pratham-cloud-ctrl/INDRBT/02_Simulation_and_Animation/README.md

# Simulation · Motion, workspace and feedback

[← Project home](../README.md) · [Mechanical tour](../06_Complete_Project_Source/docs/cad_tour.md) · [Theory walkthrough](../06_Complete_Project_Source/docs/engineering_walkthrough.md)

Recorded FK pick-and-place task

## Move and inspect the actual CAD

**[Launch the public robot viewer](https://pratham-cloud-ctrl.github.io/INDRBT/#robot)** for joint controls, gripper motion, component isolation and playback without downloading files.

**Optional offline use:** download and extract the project, then open **OPEN_3D_VIEWER.cmd** in the parent folder on Windows. On any system, open [Interactive_3D_Viewer.html](Interactive_3D_Viewer.html) locally in a browser. This local copy needs no server or internet; GitHub displays its HTML source rather than executing it.

Drag to orbit, scroll to zoom, select a named pose, adjust six joints and the gripper, or play the recorded task. The **CAD component** selector isolates and frames each of the 54 parts.

For optional native CAD/PCB or offline inspection, use the [public engineering download release](https://github.com/pratham-cloud-ctrl/INDRBT/releases/tag/indrbt-2026-10-28) and [opening guide](../06_Complete_Project_Source/docs/cad_downloads.md). The release includes a combined offline viewer/CAD pack. The published GitHub Pages showcase includes the browser viewers and download controls.

## Understand the recorded task

| Inspect | Evidence |
|---|---|
| Tool path through the task | [Pick/place TCP plot](Trajectories/pick_place_tcp.png) |
| Joint angles, speeds and accelerations | [Pick/place joint plots](Trajectories/pick_place_joints.png) |
| Reproduce the samples | [Task CSV](Trajectories/pick_place.csv) · [Task metrics](Trajectories/pick_place_metrics.json) |
| Compare joint interpolation and Cartesian moves | [Interpolation curves](Trajectories/interpolation_comparison.png) · [MOVE J](Trajectories/move_j_tcp.png) · [MOVE L](Trajectories/move_l_tcp.png) |

## Workspace and feedback

| Topic | Plot | Explanation |
|---|---|---|
| Reachable samples | [3D workspace](Workspace/workspace_3d.png) · [Projections](Workspace/workspace_projections.png) | 6,000 seeded joint configurations; the convex hull is an envelope, not collision-free reachable volume |
| Frames and singularities | [Coordinate frames](Workspace/coordinate_frames.png) · [Singularity analysis](Workspace/singularity_analysis.png) | [Kinematic formulation](../06_Complete_Project_Source/docs/02_kinematics.md) |
| Simplified PID | [Tracking](Control/pid_tracking.png) · [Step response](Control/pid_step_response.png) · [Metrics](Control/metrics.json) | [Theory guide](../06_Complete_Project_Source/docs/theory_guide.md) |

The grasp is an ideal attachment and controller plants use independent assumed inertias/damping. Manual joint settings can collide. [Sampled CAD clearance evidence](../03_Reports_and_Results/Validation/cad_motion_clearance.json) is separate from viewer playback.
