pratham-cloud-ctrl/INDRBT/07_Releases/README.md

# INDRBT release bundles

Download the complete INDRBT project, installable Python package, standard CAD,
FreeCAD and KiCad inspection packs from the [current public release](https://github.com/pratham-cloud-ctrl/INDRBT/releases/tag/indrbt-2026-10-28).

The engineering design revision remains 1.2.0. The October 2026 identity update
renames the project and refreshes its native labels, viewers, documentation and
source-bound verification. Historical distributions and audit records are
preserved separately; current downloads use INDRBT consistently.
