pratham-cloud-ctrl/INDRBT/06_Complete_Project_Source/docs/cad_downloads.md

# Open the engineering files

[Inspect the robot online](https://pratham-cloud-ctrl.github.io/INDRBT/#robot) · [Inspect the PCB online](https://pratham-cloud-ctrl.github.io/INDRBT/#pcb) · [Documentation index](README.md)

The [public browser showcase](https://pratham-cloud-ctrl.github.io/INDRBT/#robot) is the quickest viewing route. For optional CAD/electronics application inspection or offline browsing, use the [public GitHub inspection release](https://github.com/pratham-cloud-ctrl/INDRBT/releases/tag/indrbt-2026-10-28) and the actual engineering files below. The repository and its release assets are public; no private repository access is needed.

**Hosting status — 28 October 2026:** the browser showcase and its download controls are published through GitHub Pages at the address above. Public downloads are also distributed through the GitHub inspection release below. The original Sites management record remains inaccessible; publication on GitHub Pages does not claim to repair that server record.

## Choose a model format

| What you want | Actual file or folder | Open it with |
|---|---|---|
| Complete solid assembly | [Home STEP](../cad/exports/STEP/assembly_home.step) | FreeCAD or another CAD application supporting STEP |
| Another complete configuration | [Six STEP assemblies](../cad/exports/STEP) — files named `assembly_home`, `assembly_extended`, `assembly_folded`, `assembly_vertical`, `assembly_pick` and `assembly_place` | CAD application, **File → Open** or **File → Import** |
| One component | [Individual STEP files](../../01_CAD_Models/STEP/Individual_Parts) | CAD application, **File → Open** or **File → Import** |
| Native FreeCAD inspection assembly | [indrbt_home.FCStd](../cad/freecad/indrbt_home.FCStd) | FreeCAD, **File → Open** |
| Triangle meshes | [STL exports](../cad/exports/STL) | Mesh viewer or a CAD application supporting STL |
| Dimensioned interfaces | [Engineering drawings PDF](drawings/engineering_interfaces.pdf) | Any PDF viewer |

**STEP is standard solid-geometry exchange without construction history.** Its geometry can be inspected or modified using the receiving application's tools; it does not include the original parametric feature sequence. The native FreeCAD file contains 54 named, saved solids and inspection metadata, rather than a sketch-based construction tree.

The reproducible parametric design lives in [Build123d geometry](../cad/build123d/geometry.py), [assembly transforms](../cad/build123d/assembly.py) and the [shared SI configuration](../config/robot.yaml). Read [CAD reproduction](04_cad.md#refresh-native-cad-evidence) before changing the design or regenerating its exports.

### Open or import safely

1. Save or extract the chosen file to a normal folder. On GitHub, use the file page's **Download raw file** control when available; do not copy its displayed text into another application.
2. Start FreeCAD or your CAD application, then choose **File → Open** for a new document, or **File → Import** when deliberately adding geometry to an existing document. Select the `.step` or `.FCStd` file using the file-type filter.
3. Use **Fit all** if the model is outside the current view. Open an `assembly_*.step` file to see positioned parts together.
4. Save intentional edits as a **new filename**. Generated files are refreshed by the project scripts; an older open document should not overwrite a newer generated file.

CAD exports use **millimetres**; numerical calculations use **metres**. Individual parts retain local group frames, so opening all part files at a common origin does not assemble the robot. Use a complete assembly or the native FreeCAD home model for that purpose.

## Open the KiCad project

| Native item | Actual file or folder |
|---|---|
| Project entry point | [joint_interface.kicad_pro](../electronics/joint_interface.kicad_pro) |
| Schematic | [joint_interface.kicad_sch](../electronics/joint_interface.kicad_sch) |
| Routed PCB | [joint_interface.kicad_pcb](../electronics/joint_interface.kicad_pcb) |
| Project-local footprint resolution | [fp-lib-table](../electronics/fp-lib-table) and [INDRBT_Interface.pretty](../electronics/INDRBT_Interface.pretty) |
| Symbol resolution and rules | [sym-lib-table](../electronics/sym-lib-table) and [joint_interface.kicad_dru](../electronics/joint_interface.kicad_dru) |
| Readable circuit and layers | [Schematic PDF](../electronics/exports/joint_interface.pdf) and [PCB layer PDF](../electronics/exports/pcb_layers.pdf) |

With **KiCad 10** and its standard libraries installed, keep the project, schematic, PCB, rule files, library tables and local footprint folder together. Open the `.kicad_pro` file in KiCad, then open the schematic or PCB editor. Open the `.kicad_sch` or `.kicad_pcb` directly only when their surrounding project context is retained. The custom F1 footprint resolves through `${KIPRJMOD}`; downloading the board alone omits that editable library context.

For component roles, supply assumptions and verification scope, read the [circuit tour](electronics_tour.md), [component guide](electronics_components.md) and [electronics chapter](05_electronics.md). Native files and rule checks remain digital design evidence, without physical qualification.

## Public inspection download release

[Open the inspection release](https://github.com/pratham-cloud-ctrl/INDRBT/releases/tag/indrbt-2026-10-28) for the four focused format packs and the combined offline pack. These are GitHub **release assets**; they do not need to be stored in the repository file tree. Local copies are also retained in `07_Releases`.

| Public release asset | Intended use |
|---|---|
| [INDRBT_STEP_STL_CAD.zip](https://github.com/pratham-cloud-ctrl/INDRBT/releases/download/indrbt-2026-10-28/INDRBT_STEP_STL_CAD.zip) | Extract the exchange solids/meshes, then open a complete STEP assembly; STEP has no construction history |
| [INDRBT_FreeCAD_Model.zip](https://github.com/pratham-cloud-ctrl/INDRBT/releases/download/indrbt-2026-10-28/INDRBT_FreeCAD_Model.zip) | Extract and open the native saved-solid FreeCAD inspection model |
| [INDRBT_KiCad_Project.zip](https://github.com/pratham-cloud-ctrl/INDRBT/releases/download/indrbt-2026-10-28/INDRBT_KiCad_Project.zip) | Extract the project with its local library context, then open the `.kicad_pro` file |
| [INDRBT_PCB_STEP.zip](https://github.com/pratham-cloud-ctrl/INDRBT/releases/download/indrbt-2026-10-28/INDRBT_PCB_STEP.zip) | Import the native board STEP into mechanical CAD; 100 × 100 × 11.54 mm, with fitted component and copper geometry |
| [INDRBT_Inspection_With_CAD.zip](https://github.com/pratham-cloud-ctrl/INDRBT/releases/download/indrbt-2026-10-28/INDRBT_Inspection_With_CAD.zip) | Extract the browser viewers with the selected CAD and KiCad downloads for combined offline inspection |

The earlier `INDRBT_Browser_Inspection.zip` remains a local historical pack in `07_Releases`; the public combined pack is the current offline download. The engineering v1.2.0 release is preserved separately from this inspection distribution.

Downloading or opening these files is optional. The online viewers remain the immediate inspection route, and the [source project guide](../README.md) covers local reproduction.
