pratham-cloud-ctrl/INDRBT/06_Complete_Project_Source/docs/completion_checklist.md

# Digital project completion checklist

This maps the master brief's definition of done to the retained source and actual
evidence. The executed [validation report](../results/validation/validation_report.md)
records **DIGITAL SCOPE COMPLETE**: the numerical/CAD tests passed with no failures,
errors or skips, native schematic ERC/PCB DRC/connectivity passed, and the versioned
wheel passed detached installation checks. The public repository and its versioned
releases provide publication evidence, checked separately from local engineering
acceptance. The current published release is linked below.

| Deliverable | Evidence |
|---|---|
| Requirements and architecture | [Requirements](01_requirements.md), [architecture](architecture.md), diagrams |
| Student-readable theory and assumptions | [Theory guide](theory_guide.md), linked equations/models and independent [final theory review](../results/validation/final_theory_review.json) |
| Original six-axis arm, parametric CAD and assembly | `cad/build123d`, valid component manifest and six STEP/STL assemblies |
| Parallel gripper and interchangeable tool | CAD body/guides/jaws, opening checks and mechanical calculations |
| STEP/STL, useful drawings and representative renders | `cad/exports`, `docs/drawings`, `cad/renders`, independent FreeCAD inspection |
| Frames, FK, IK and Jacobian | [Kinematics](02_kinematics.md), software tests and independent numerical reconstruction |
| Workspace and singularities | Seeded FK sample data and labelled projections/3D figures |
| Joint/Cartesian trajectories and pick/place | Linear/cubic/quintic laws, MOVE J/MOVE L, recorded task data, plots and model-driven viewer |
| Joint torque, analytical structure and conceptual actuator sizing | [Mechanical analysis](03_mechanical_analysis.md), load/beam results and independent torque test |
| PID control simulation | Step/tracking/saturation/antiwindup evidence under the stated independent-axis plant |
| KiCad architecture, schematic, PCB and actual native checks | [Electronics](05_electronics.md), BOM/net contract, native ERC/DRC, routed board and fabrication files; zero DRC violations, unconnected items or schematic parity issues in the [PCB audit](../electronics/pcb_verification.json) |
| Organized reproducible software and central parameters | `src/robotarm`, authoritative SI YAML, commands and tests |
| Automated tests and numerical validation | Passing suite in the executed validation report plus Jacobian/IK/FK/configuration/trajectory/gripper/CAD checks; the [final theory review](../results/validation/final_theory_review.json) includes the independent beam-regression audit |
| Validation matrix and one workflow | [Traceability](validation_matrix.md), `scripts/run_validation.py` |
| Research experiments, plots and KPIs | Five real parameter sweeps, figure files and [KPIs](kpis.md) |
| Engineering report and decisions | [Report](engineering_report.md), [decision log](design_decisions.md), real failure/fix journal |
| Polished README and tested installation | Root/source guides, browser reports and fresh detached [versioned wheel validation](../results/validation/packaging_validation.json) |
| Clean repository, secrets scan and meaningful history | Repository audit and retained commits; repository made public by the owner's explicit instruction on 21 October 2026 |
| Complete organized publication and coherent release | Numbered repository folders and exact-copy manifest; [public repository](https://github.com/pratham-cloud-ctrl/INDRBT) and [latest versioned release](https://github.com/pratham-cloud-ctrl/INDRBT/releases/latest) with complete project ZIP and installable wheel. Live publication is checked separately from local engineering acceptance. |

Physical construction and physically measured payload/repeatability were excluded
by the master brief. The allowed analytical structure and simplified PID models
are implemented. Full FEA, coupled dynamics, contact physics, production firmware,
manufacturing qualification and continuous swept collision certification are
declared extensions, not substituted pass claims. The [scope audit](digital_scope_audit.md)
explains this boundary against the actual requested sections.
