pratham-cloud-ctrl/INDRBT/01_CAD_Models/Drawings/engineering_interfaces.pdf

# INDRBT | BASE & TOOL INTERFACES

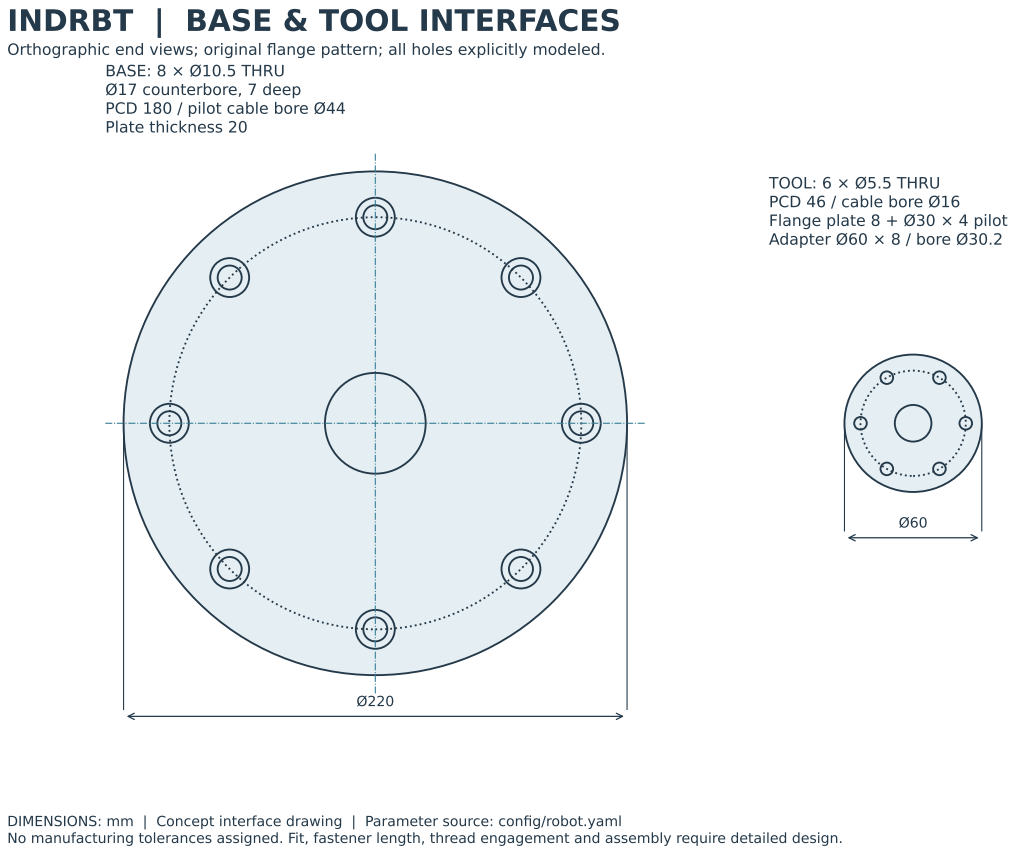
[picture p14: page 1]

Orthographic end views; original flange pattern; all holes explicitly modeled.

BASE: 8 × Ø10.5 THRU
Ø17 counterbore, 7 deep
PCD 180 / pilot cable bore Ø44
Plate thickness 20

TOOL: 6 × Ø5.5 THRU
PCD 46 / cable bore Ø16
Flange plate 8 + Ø30 × 4 pilot
Adapter Ø60 × 8 / bore Ø30.2

DIMENSIONS: mm | Concept interface drawing | Parameter source: config/robot.yaml
No manufacturing tolerances assigned. Fit, fastener length, thread engagement and assembly require detailed design.

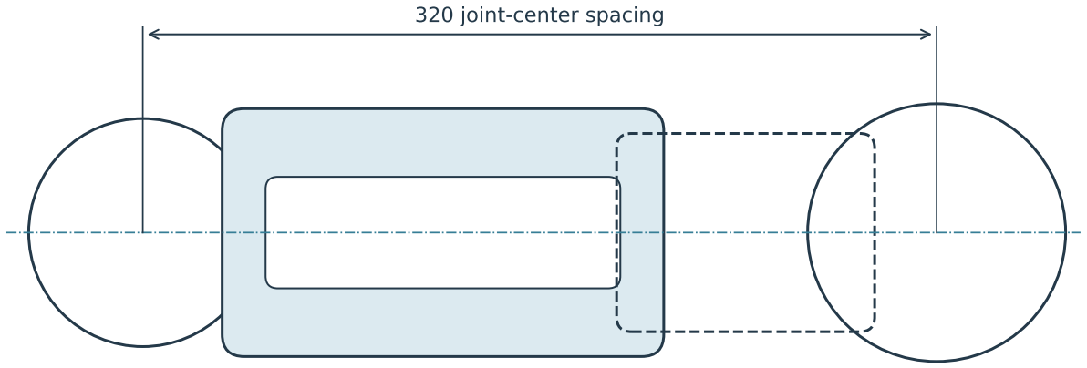
[picture p15: figure]
320 joint-center spacing

100

80

UPPER NOMINAL
80 × 100 × 4 wall

FOREARM: 280 center spacing; 65 × 80 × 4 wall.
Longitudinal fillets R9 outside / R5 inside; service cover mounting Ø3.4.

Joint barrels, fork bridges and material overlap are structural assembly interfaces.

# INDRBT | LINK SECTIONS & JOINT CENTERS

Side outline and nominal extrusion section. Access windows require a separate structural refinement.

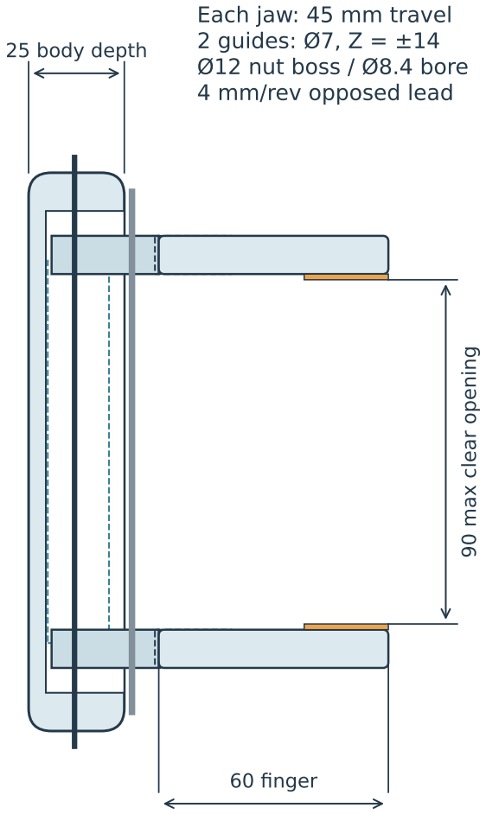
[picture p16: figure]
90 max clear opening; 60 finger; 25 body depth; Each jaw: 45 mm travel 2 guides: Ø7, Z = ±14 Ø12 nut boss / Ø8.4 bore 4 mm/rev opposed lead

Finger section 10 × 18; replaceable 1.5-thick pads. TCP at X=110, jaw mid-plane.
Ø8 screw envelope; connected nut bridges; top service hatch (dashed); no thread/preload detail.

# INDRBT | SYMMETRIC PARALLEL GRIPPER

Top view: transverse opposite-hand screw and two guides; fingers translate along ±Y.
