pratham-cloud-ctrl/INDRBT/06_Complete_Project_Source/requirements-lock.txt

anytree==2.13.0
asttokens==3.0.2
bd_materials==0.2.4
build123d==0.13.0
cadquery-ocp-novtk==8.0.1.0.0
cadquery-ocp-proxy==8.0.1.0.0
certifi==2026.7.22
charset-normalizer==3.5.2
cloudpickle==3.1.2
colorama==0.4.6
contourpy==1.4.0
cycler==0.12.1
dataclasses-json==0.6.7
Deprecated==3.0.0
executing==2.2.1
ezdxf==1.4.4
fonttools==4.66.1
idna==3.20
iniconfig==2.3.0
ipython==9.17.1
ipython_pygments_lexers==1.1.1
jedi==0.20.0
joblib==1.6.0
kiwisolver==1.5.1
lib3mf==2.5.0
Markdown==3.8.2
marshmallow==3.26.2
matplotlib==3.11.2
matplotlib-inline==0.2.2
mpmath==1.3.0
mypy_extensions==1.1.0
narwhals==2.26.0
numpy==2.5.3
ocp_gordon==0.3.1
ocpsvg==0.7.0
packaging==26.3
parso==0.8.7
pillow==12.2.0
platformdirs==4.12.3
pluggy==1.6.0
prompt_toolkit==3.0.53
psutil==7.2.2
pure_eval==0.2.4
pygltflib==1.16.5
Pygments==2.21.0
pyparsing==3.3.3
pytest==9.1.1
python-dateutil==2.9.0.post0
PyYAML==6.0.3
requests==2.34.2
ruff==0.16.10
scikit-learn==1.9.1
scipy==1.18.1
six==1.17.0
stack-data==0.6.3
svgelements==1.9.6
svgpathtools==1.8.0
svgwrite==1.4.3
sympy==1.14.0
threadpoolctl==3.7.0
threejs-materials==1.2.4
traitlets==5.16.1
trianglesolver==1.2
trimesh==5.1.1
typing-inspect==0.9.0
typing_extensions==4.16.0
urllib3==2.8.0
wcwidth==0.9.1
webcolors==24.8.0
wrapt==2.5.0
