pratham-cloud-ctrl/INDRBT/01_CAD_Models/Preview_Images/pose_extended.png

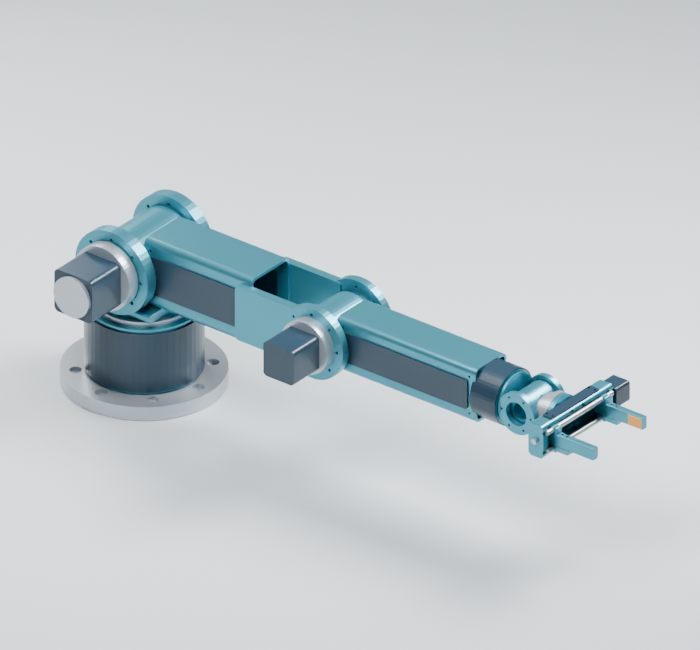
01_CAD_Models/Preview_Images/pose_extended.png
