pratham-cloud-ctrl/INDRBT/01_CAD_Models/Preview_Images/pose_home.png

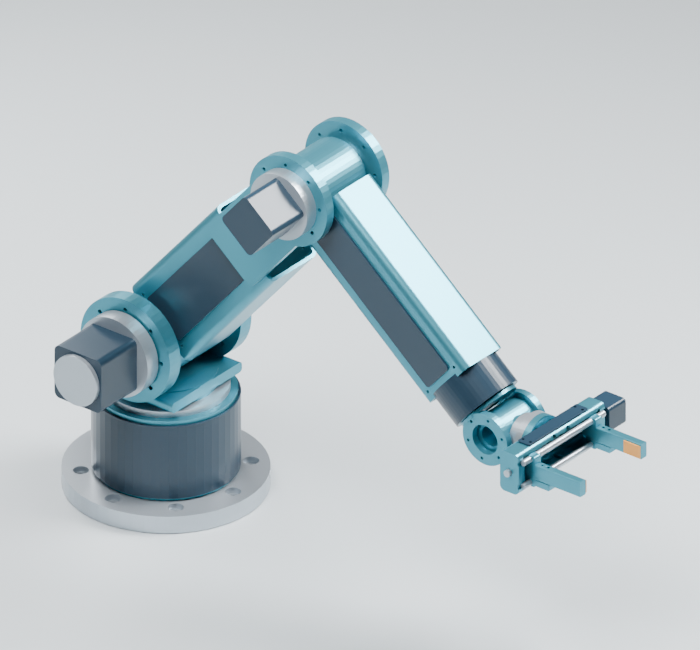
01_CAD_Models/Preview_Images/pose_home.png
