pratham-cloud-ctrl/INDRBT/01_CAD_Models/Preview_Images/pose_pick.png

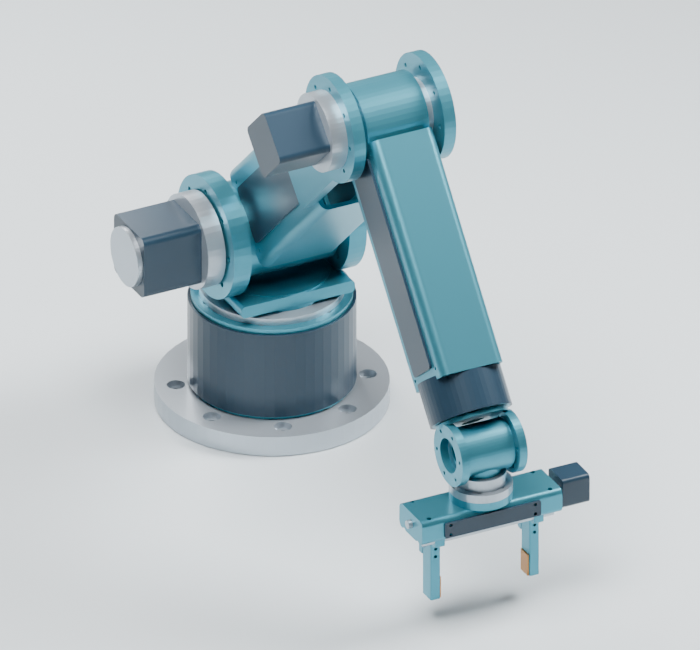
01_CAD_Models/Preview_Images/pose_pick.png
