pratham-cloud-ctrl/INDRBT/02_Simulation_and_Animation/Trajectories/interpolation_comparison.png

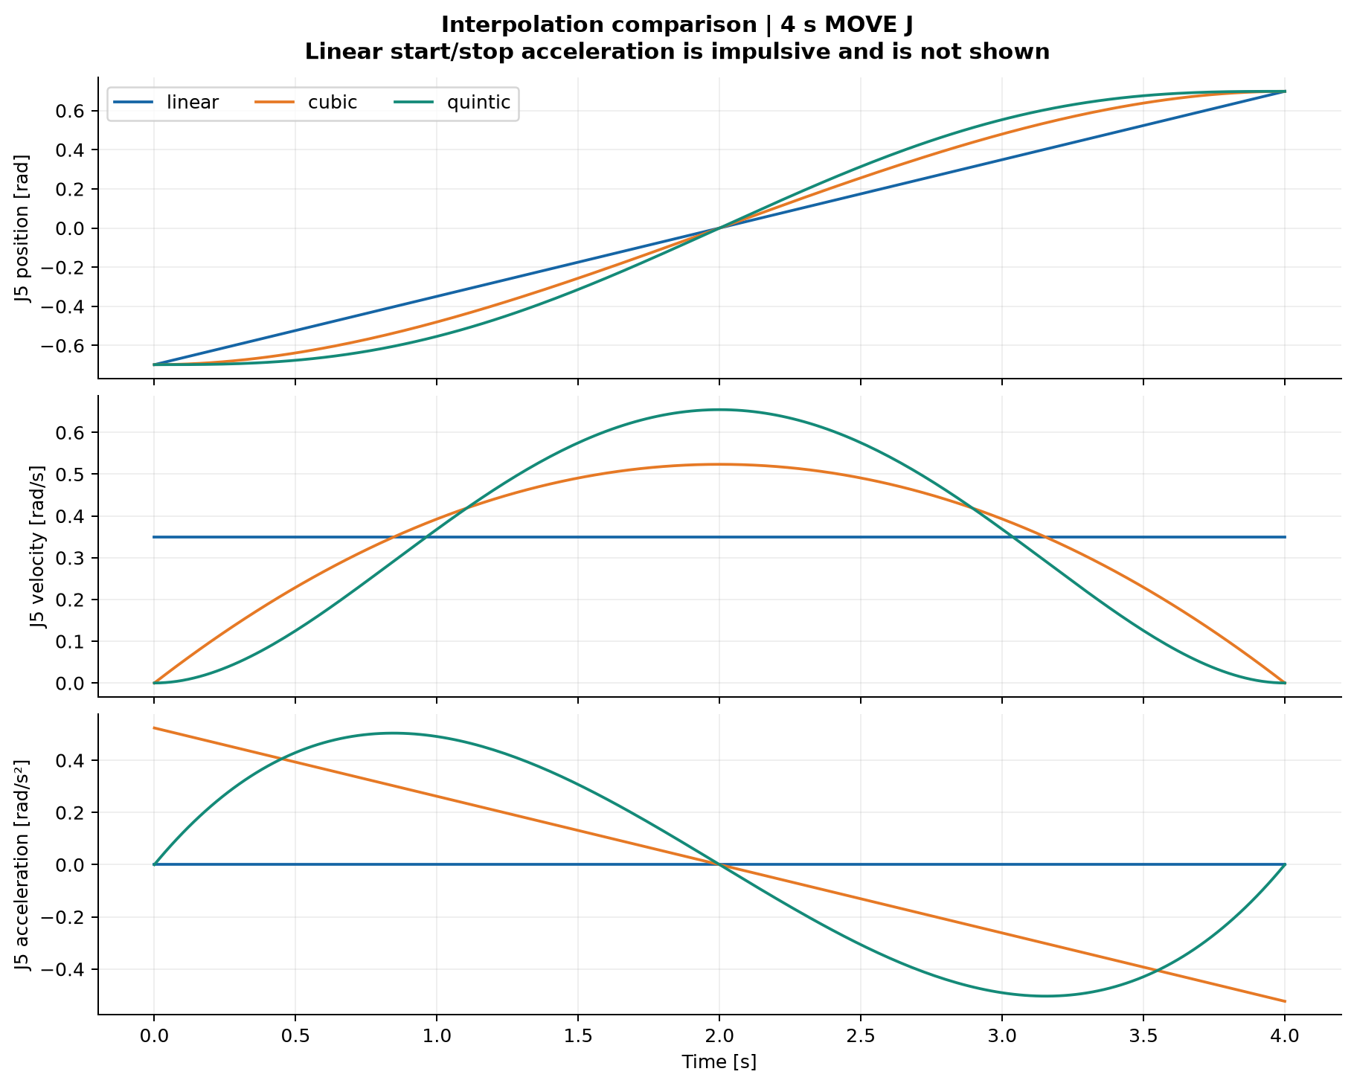
02_Simulation_and_Animation/Trajectories/interpolation_comparison.png
