pratham-cloud-ctrl/INDRBT/02_Simulation_and_Animation/Trajectories/move_j_joints.png

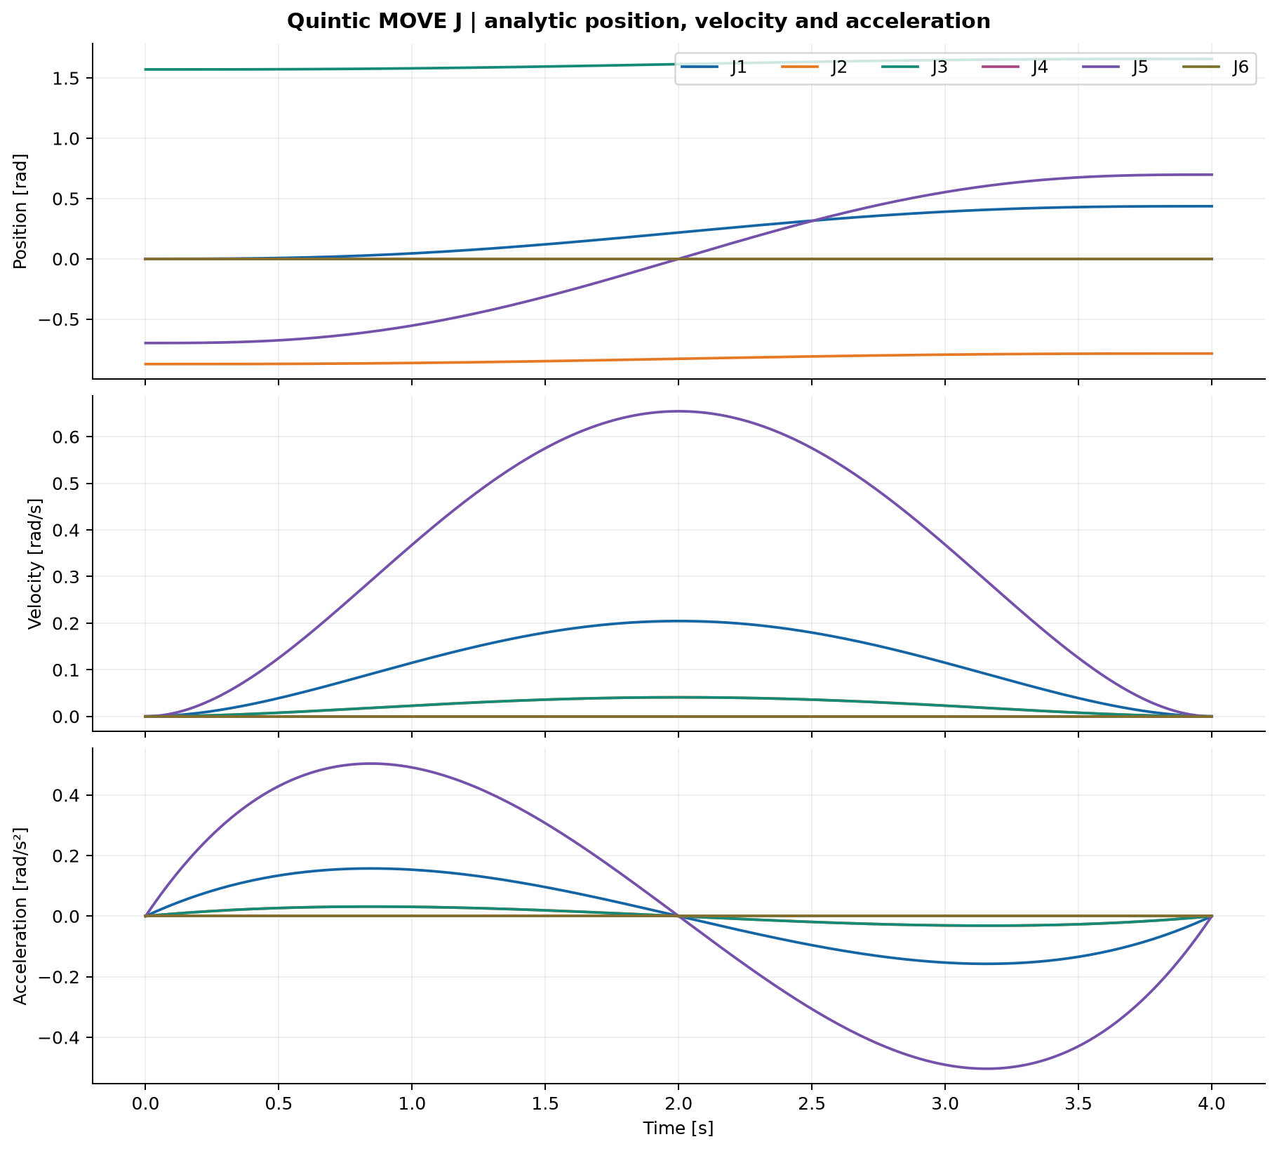
02_Simulation_and_Animation/Trajectories/move_j_joints.png
