pratham-cloud-ctrl/INDRBT/02_Simulation_and_Animation/Trajectories/move_l_tcp.png

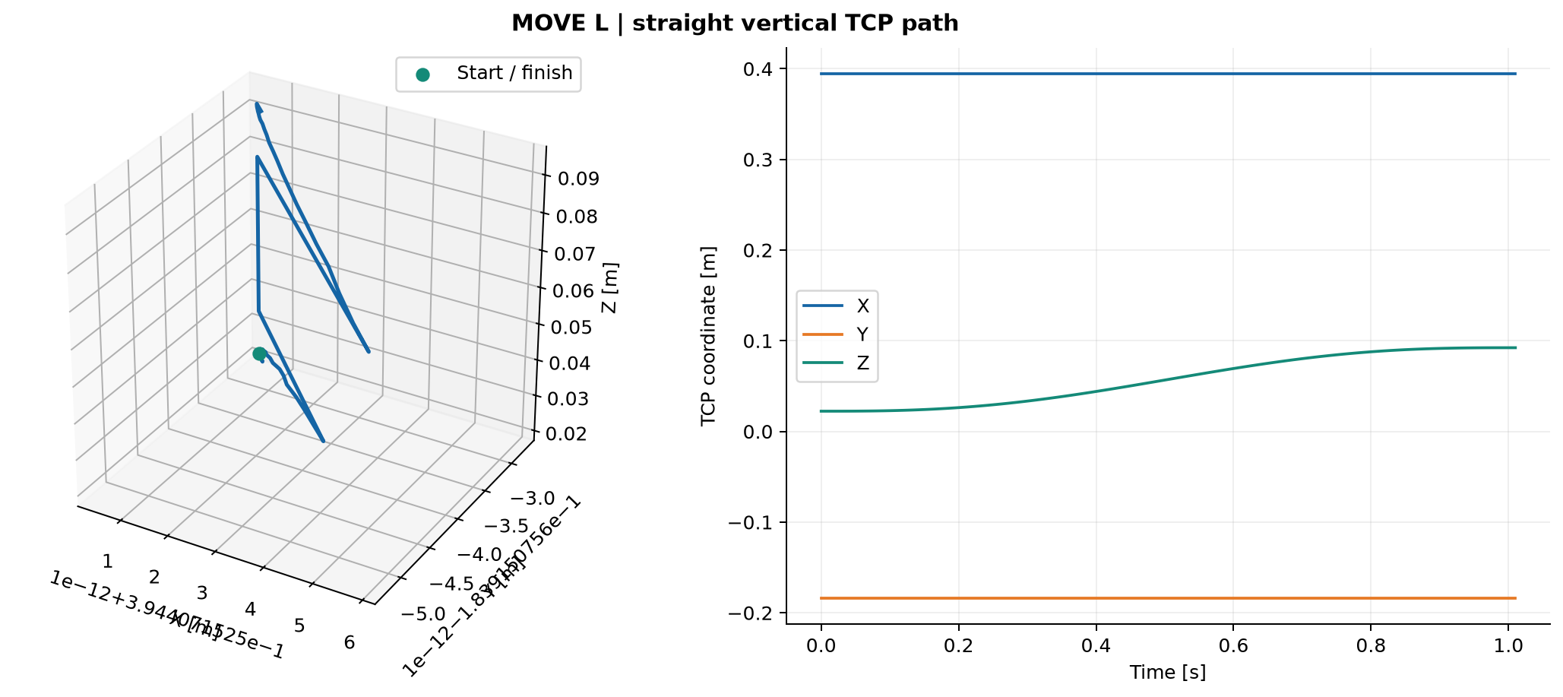
02_Simulation_and_Animation/Trajectories/move_l_tcp.png
