pratham-cloud-ctrl/INDRBT/02_Simulation_and_Animation/Viewer_Checked.png

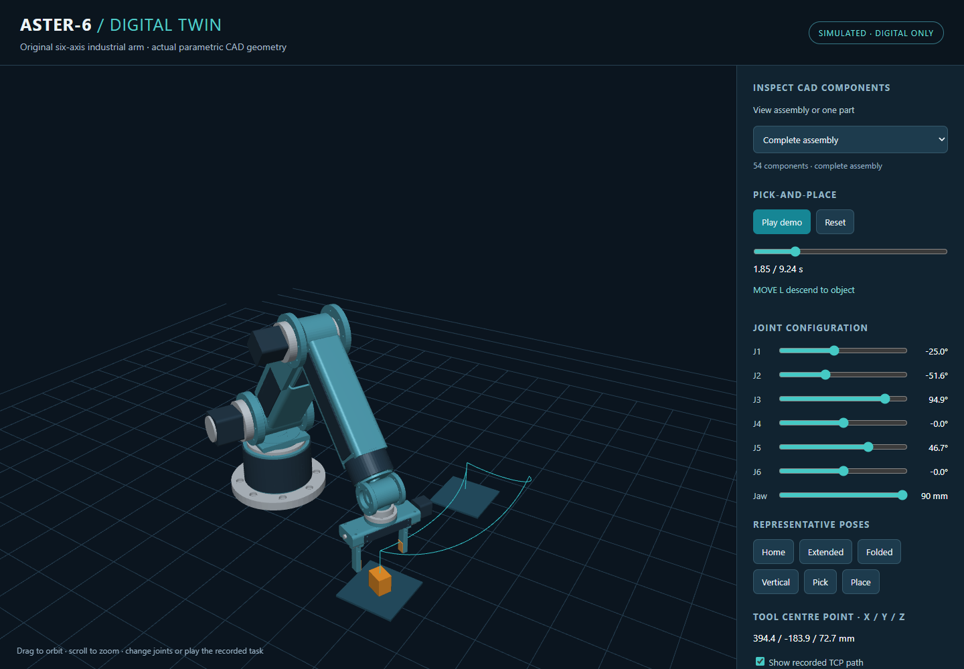
02_Simulation_and_Animation/Viewer_Checked.png
