pratham-cloud-ctrl/INDRBT/02_Simulation_and_Animation/viewer_preview.png

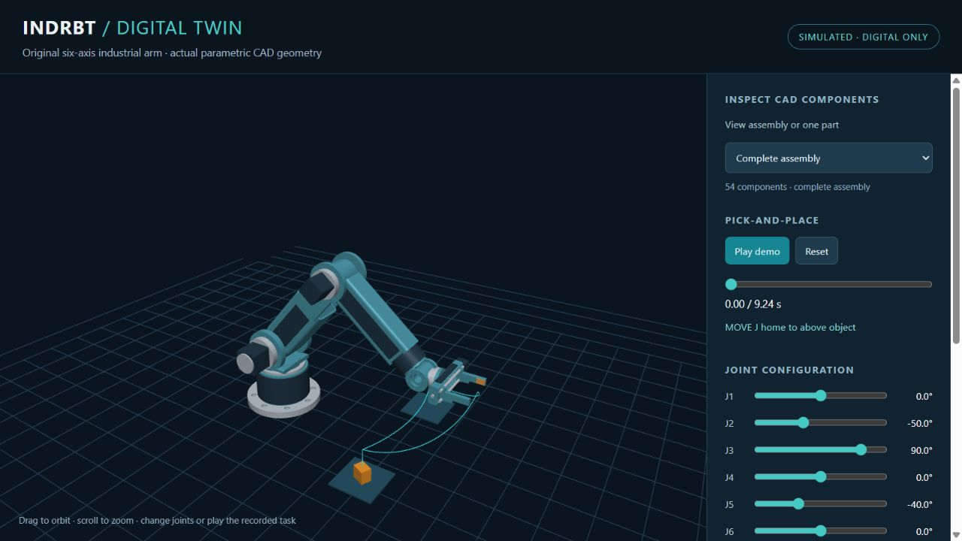
02_Simulation_and_Animation/viewer_preview.png
