pratham-cloud-ctrl/INDRBT/02_Simulation_and_Animation/Workspace/representative_poses.png

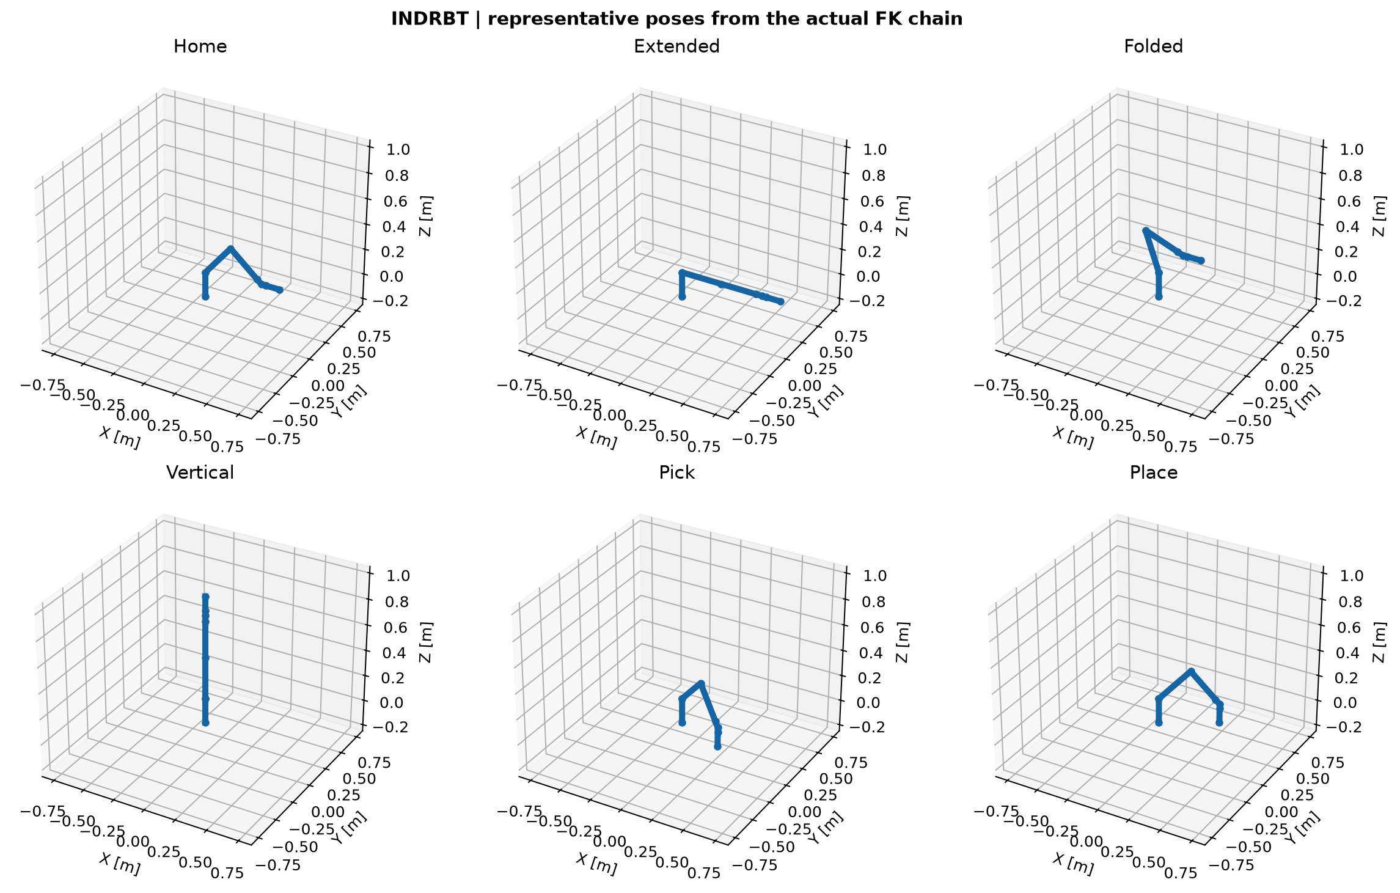
02_Simulation_and_Animation/Workspace/representative_poses.png
