pratham-cloud-ctrl/INDRBT/02_Simulation_and_Animation/Workspace/singularity_analysis.png

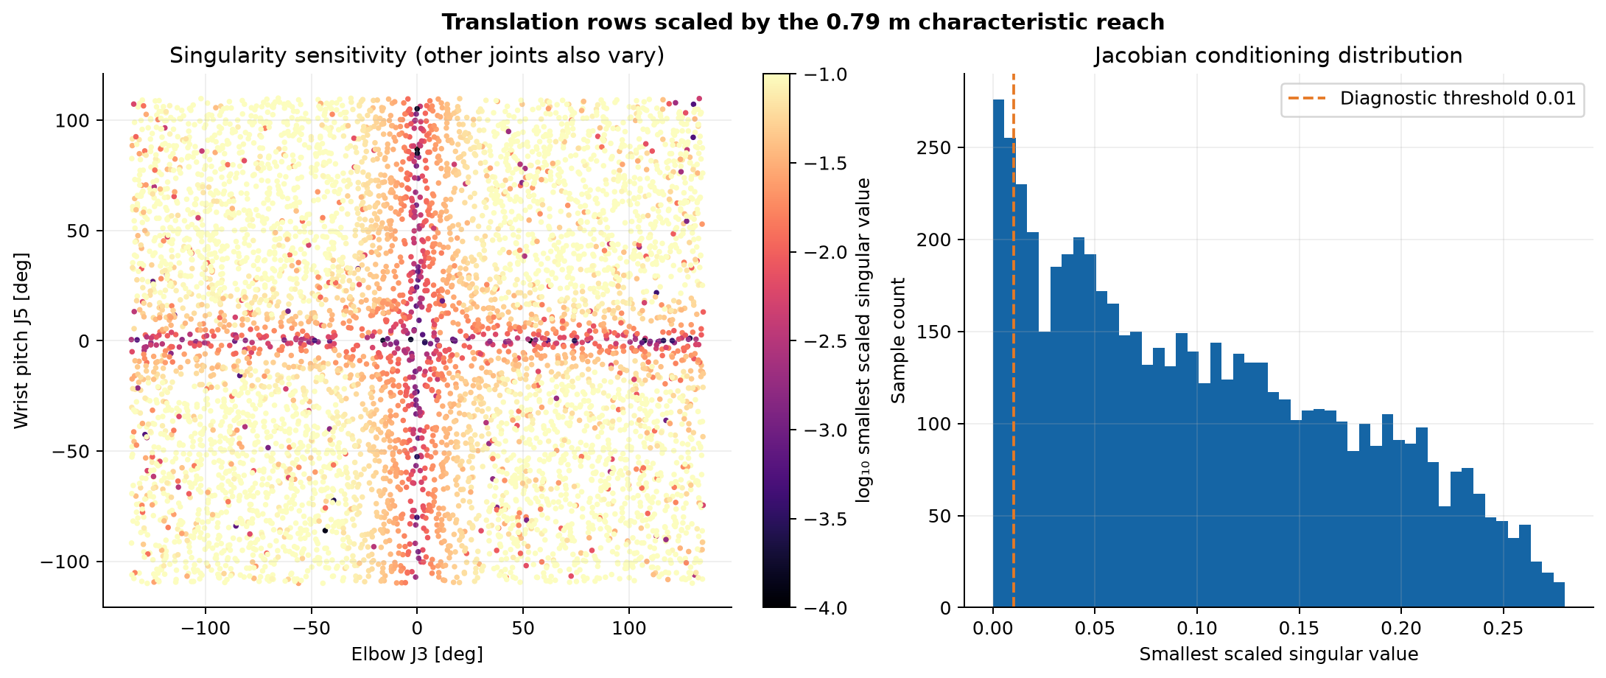
02_Simulation_and_Animation/Workspace/singularity_analysis.png
