pratham-cloud-ctrl/INDRBT/02_Simulation_and_Animation/Workspace/workspace_above_floor.png

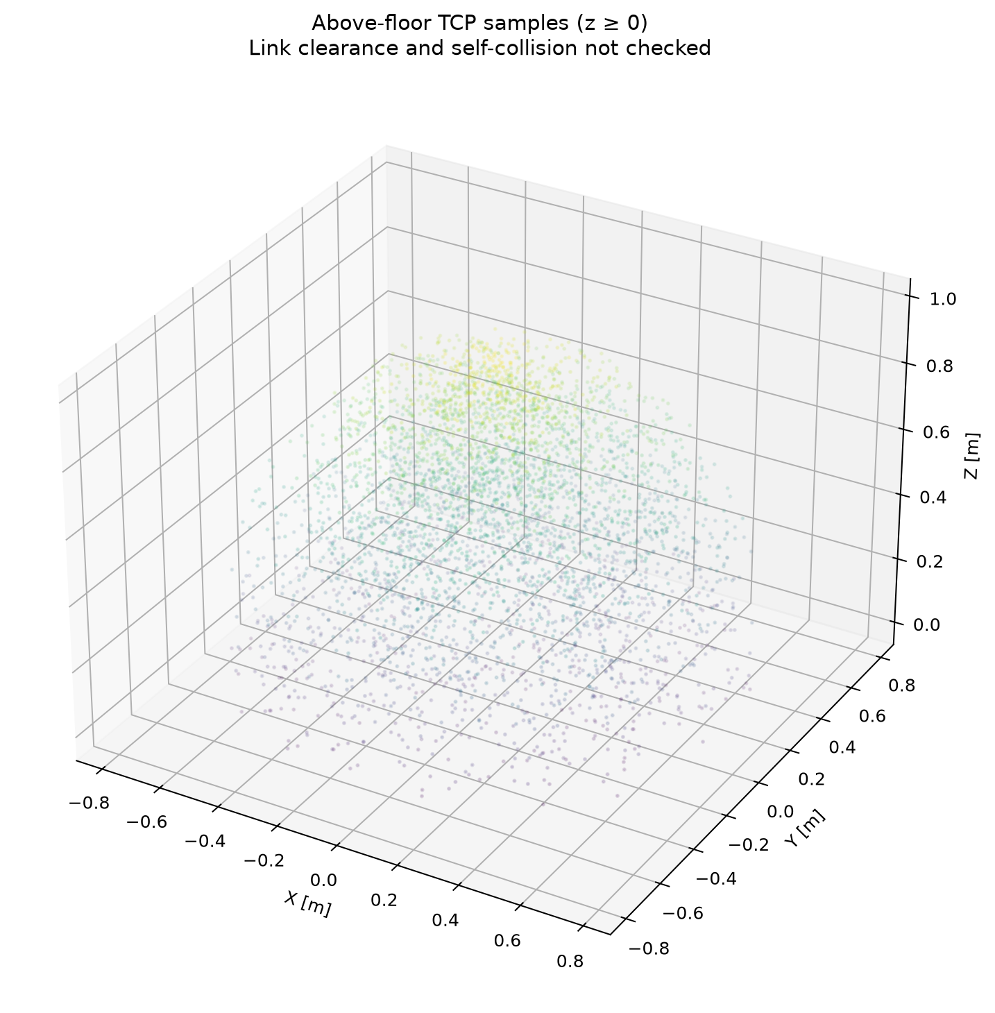
02_Simulation_and_Animation/Workspace/workspace_above_floor.png
