pratham-cloud-ctrl/INDRBT/03_Reports_and_Results/Mechanical/joint_torque.png

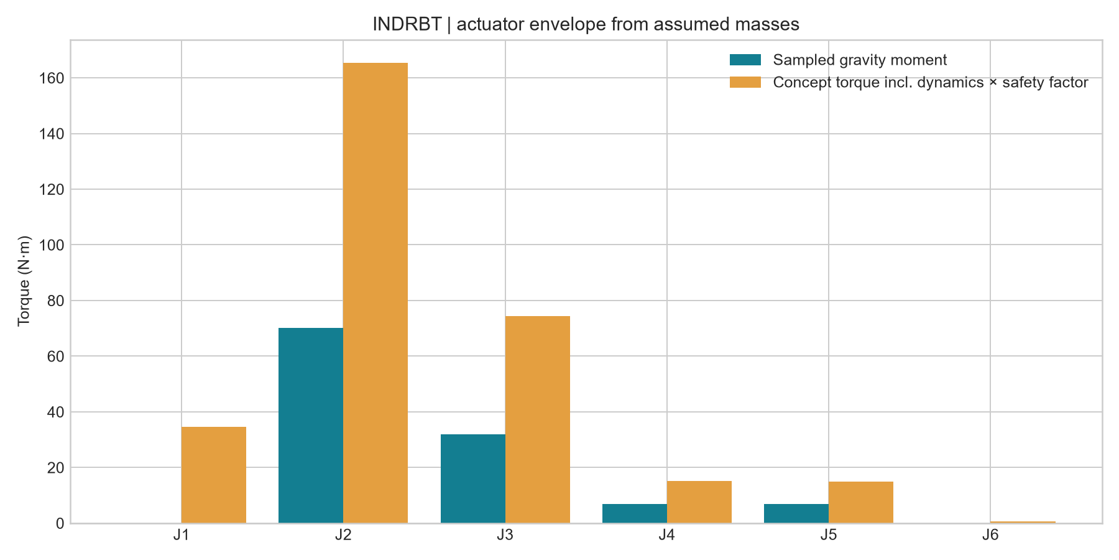
03_Reports_and_Results/Mechanical/joint_torque.png
