pratham-cloud-ctrl/INDRBT/06_Complete_Project_Source/docs/diagrams/electronics_architecture.png

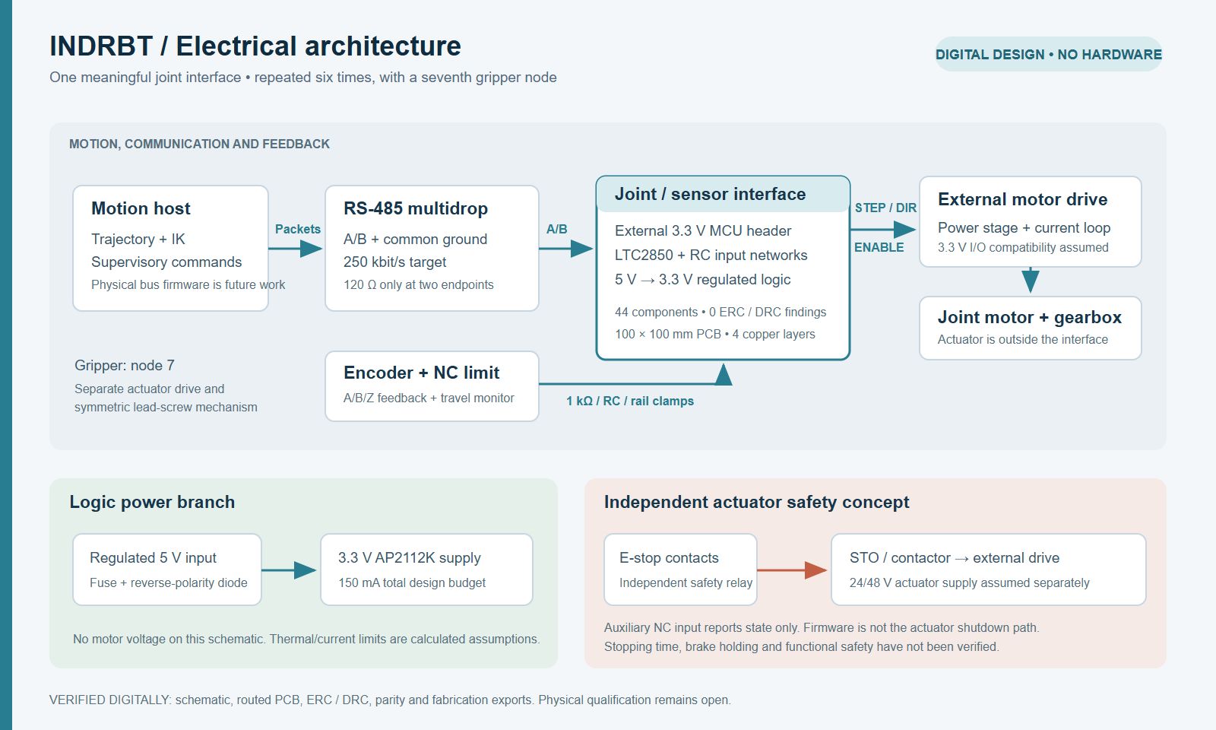
06_Complete_Project_Source/docs/diagrams/electronics_architecture.png
