pratham-cloud-ctrl/INDRBT/01_CAD_Models/STEP/Assemblies/assembly_vertical.step

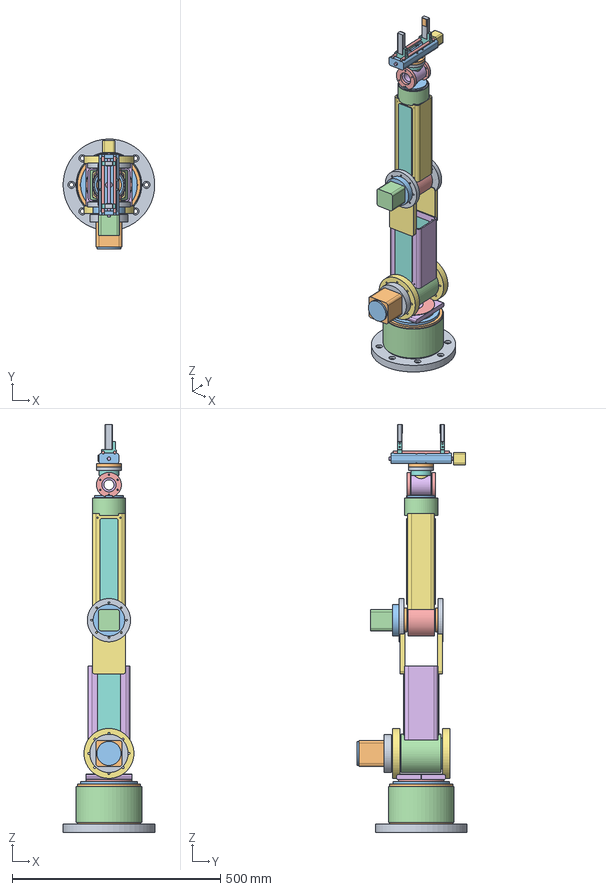
[picture p39: CAD file, 2026-10-17]
01_CAD_Models/STEP/Assemblies/assembly_vertical.step
219.8 x 263.9 x 980.0 mm
base_mounting_plate
fixed_base_riser
j1_slew_bearing_envelope
base_electronics_cover
turret_neck
turret_bridge
shoulder_fork_-1
shoulder_bearing_-1
shoulder_fork_+1
shoulder_bearing_+1
j2_gearbox_envelope
j2_motor_envelope
j2_motor_endcap
shoulder_rotor
shoulder_output_shaft
upper_arm_hollow_link
elbow_fork_bridge_-1
elbow_fork_bridge_+1
upper_service_cover_-1
elbow_fork_-1
elbow_bearing_-1
upper_service_cover_+1
elbow_fork_+1
elbow_bearing_+1
j3_gearbox_envelope
j3_motor_envelope
elbow_rotor
elbow_output_shaft
forearm_hollow_link
forearm_service_cover_-1
forearm_service_cover_+1
wrist_roll_stator
j4_bearing_envelope
wrist_roll_rotor
wrist_roll_cover
wrist_pitch_fork_-1
wrist_pitch_fork_+1
wrist_pitch_rotor
wrist_pitch_neck
j6_stator_envelope
tool_flange_6xM5_PCD46
interchangeable_gripper_adapter
gripper_pocketed_body
gripper_top_service_cover
gripper_guide_rod_-14
gripper_guide_rod_+14
opposite_hand_screw_envelope
gripper_actuator_envelope
gripper_jaw_carriage_-1
gripper_finger_-1
gripper_contact_pad_-1
gripper_jaw_carriage_+1
gripper_finger_+1
gripper_contact_pad_+1
