pratham-cloud-ctrl/INDRBT/01_CAD_Models/STEP/Individual_Parts/gripper_jaw_carriage_+1.step

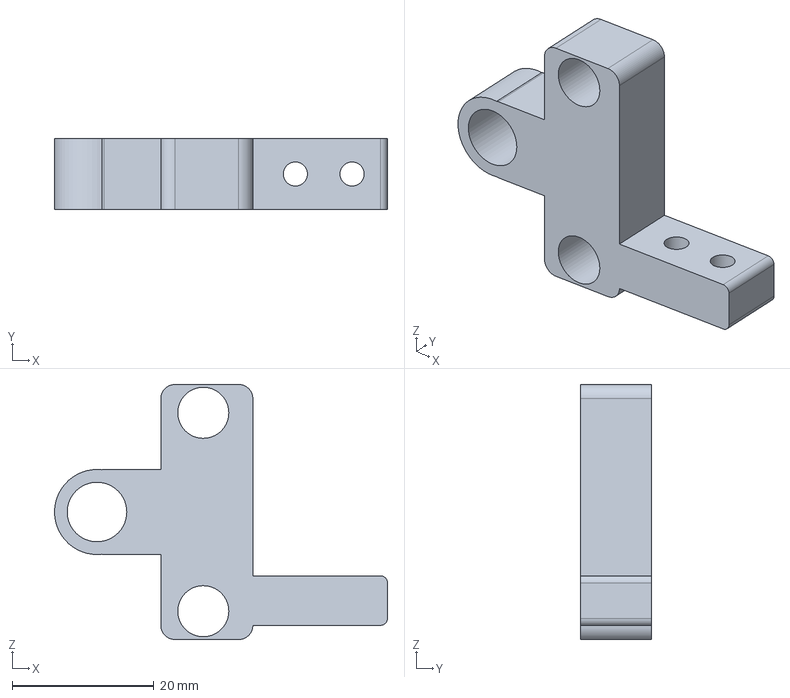
[picture p41: CAD file, 2026-10-17]
01_CAD_Models/STEP/Individual_Parts/gripper_jaw_carriage_+1.step
47.0 x 10.0 x 36.0 mm
