pratham-cloud-ctrl/INDRBT/06_Complete_Project_Source/cad/exports/STEP/wrist_roll_stator.step

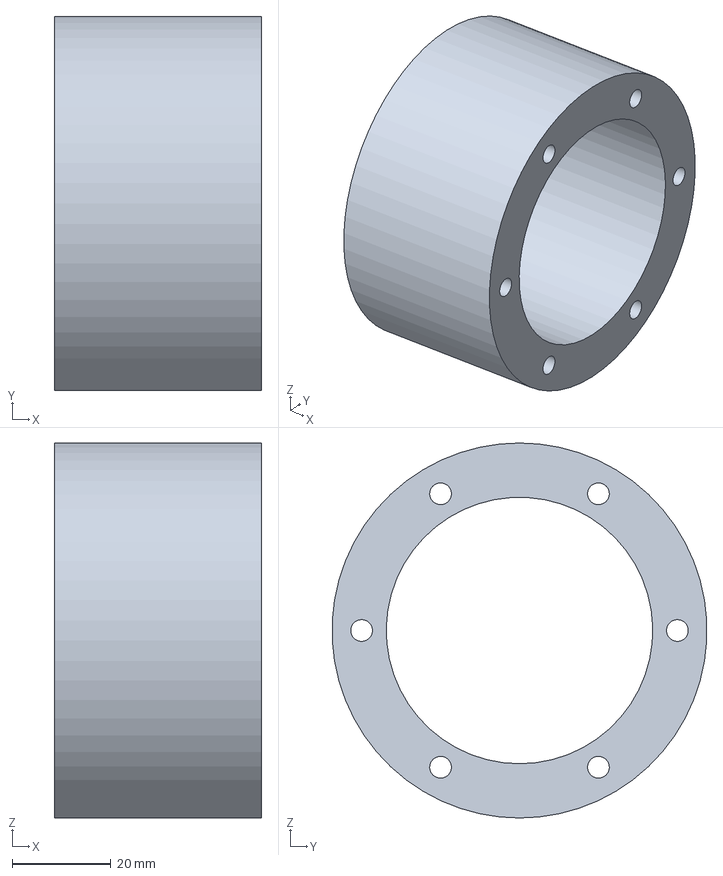
[picture p42: CAD file, 2026-10-17]
06_Complete_Project_Source/cad/exports/STEP/wrist_roll_stator.step
42.0 x 75.9 x 76.0 mm
