pratham-cloud-ctrl/INDRBT/01_CAD_Models/STEP/Individual_Parts/wrist_pitch_neck.step

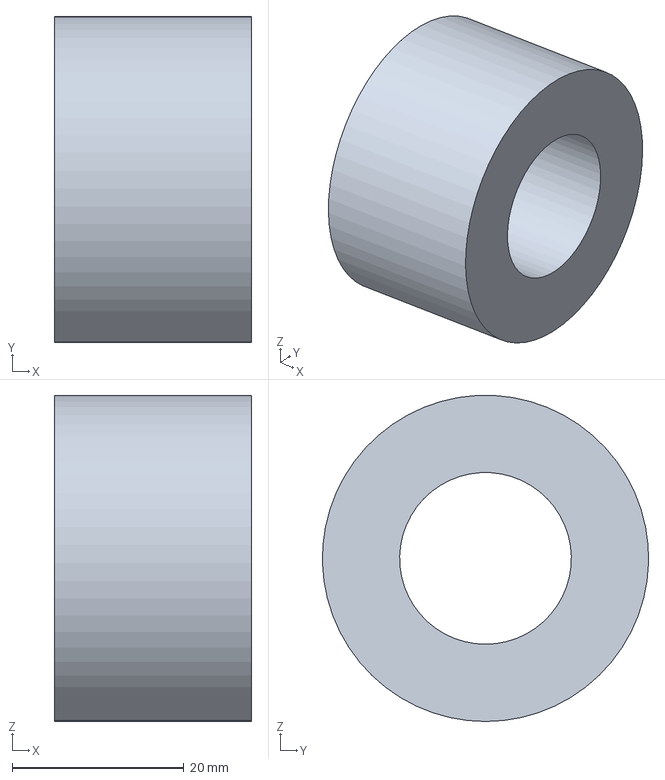
[picture p43: CAD file, 2026-10-17]
01_CAD_Models/STEP/Individual_Parts/wrist_pitch_neck.step
23.0 x 38.0 x 38.0 mm
