pratham-cloud-ctrl/INDRBT/06_Complete_Project_Source/cad/exports/STEP/elbow_fork_bridge_+1.step

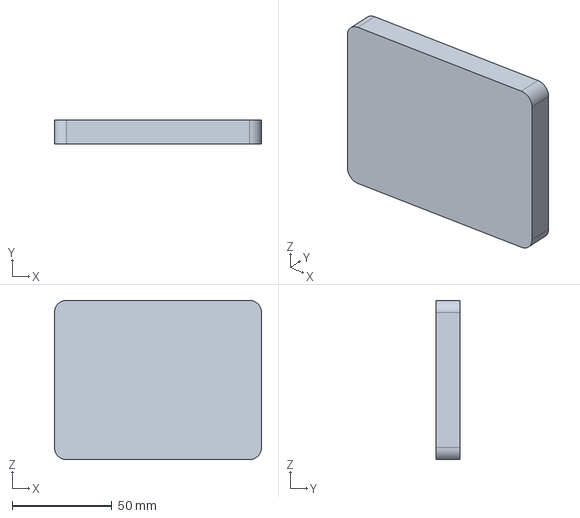
[picture p44: CAD file, 2026-10-17]
06_Complete_Project_Source/cad/exports/STEP/elbow_fork_bridge_+1.step
104.0 x 12.0 x 80.0 mm
