pratham-cloud-ctrl/INDRBT/01_CAD_Models/STEP/Individual_Parts/gripper_contact_pad_+1.step

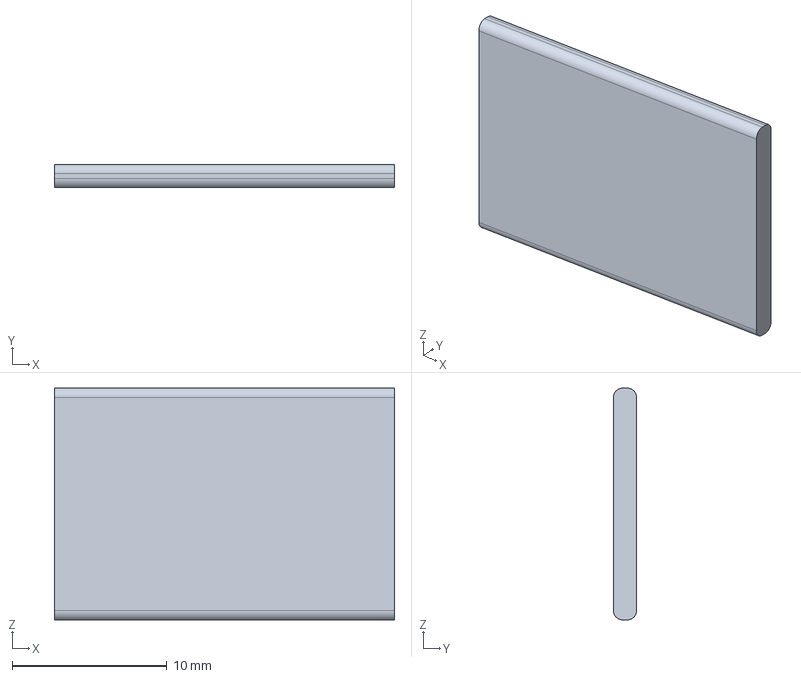
[picture p45: CAD file, 2026-10-17]
01_CAD_Models/STEP/Individual_Parts/gripper_contact_pad_+1.step
22.0 x 1.50 x 15.0 mm
