pratham-cloud-ctrl/INDRBT/06_Complete_Project_Source/cad/exports/STEP/j2_motor_endcap.step

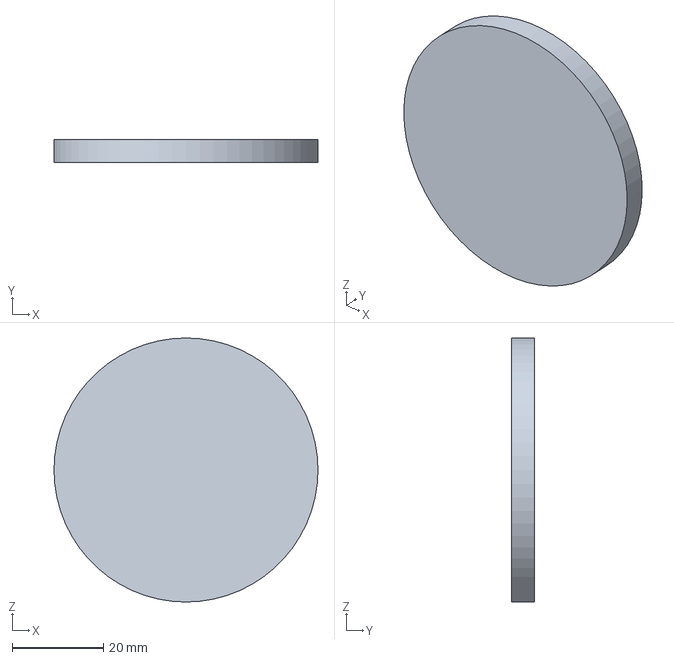
[picture p46: CAD file, 2026-10-17]
06_Complete_Project_Source/cad/exports/STEP/j2_motor_endcap.step
58.0 x 5.00 x 58.0 mm
