pratham-cloud-ctrl/INDRBT/01_CAD_Models/STEP/Individual_Parts/upper_service_cover_+1.step

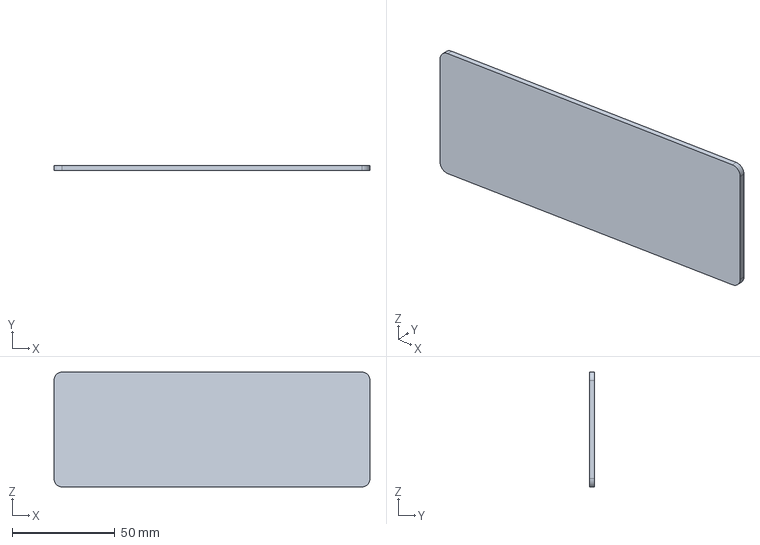
[picture p47: CAD file, 2026-10-17]
01_CAD_Models/STEP/Individual_Parts/upper_service_cover_+1.step
154.0 x 2.50 x 56.0 mm
