pratham-cloud-ctrl/INDRBT/01_CAD_Models/STEP/Individual_Parts/elbow_bearing_+1.step

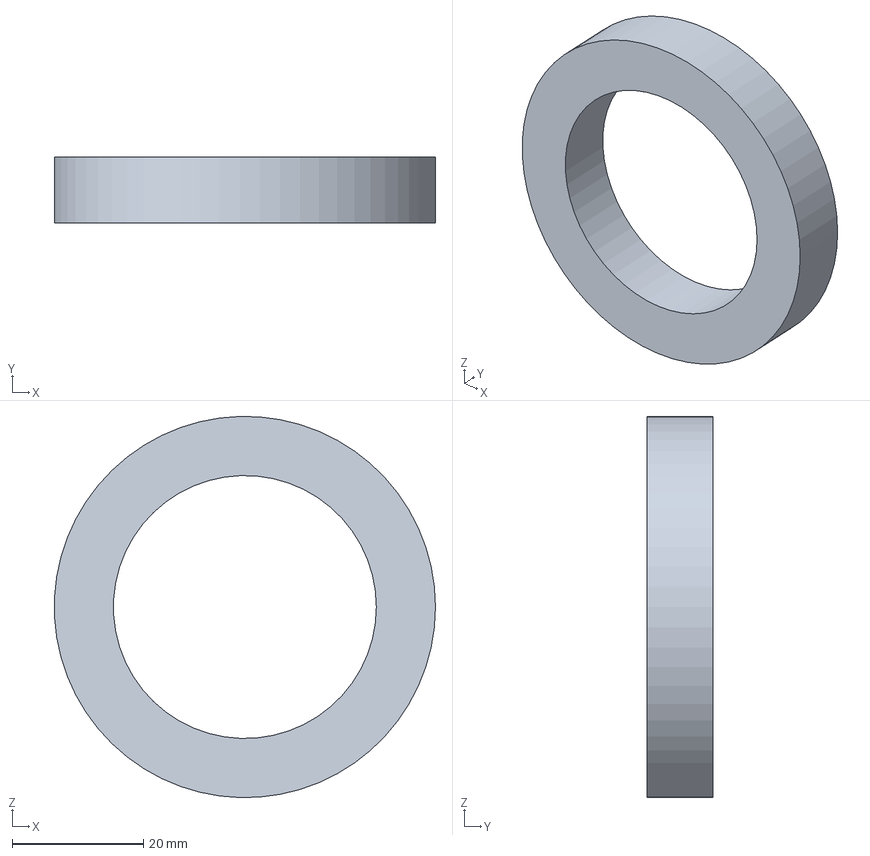
[picture p48: CAD file, 2026-10-17]
01_CAD_Models/STEP/Individual_Parts/elbow_bearing_+1.step
58.0 x 10.0 x 58.0 mm
