pratham-cloud-ctrl/INDRBT/06_Complete_Project_Source/cad/exports/STEP/wrist_roll_rotor.step

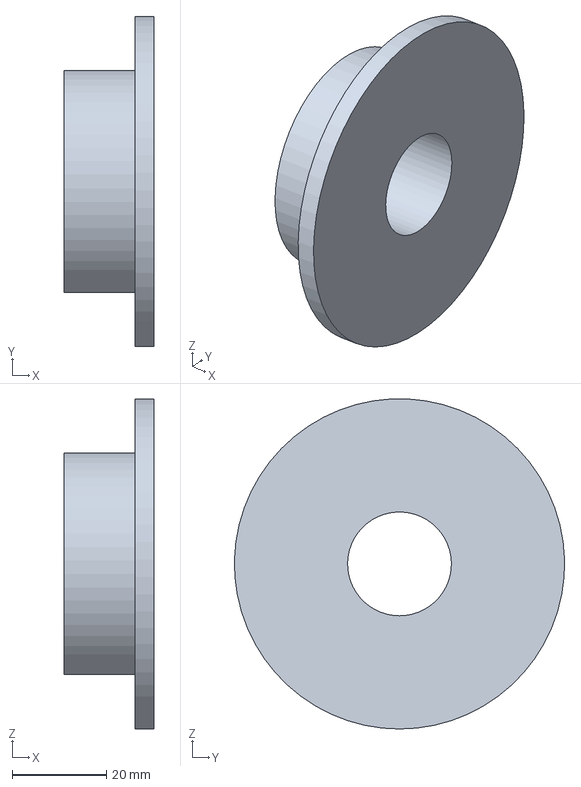
[picture p49: CAD file, 2026-10-17]
06_Complete_Project_Source/cad/exports/STEP/wrist_roll_rotor.step
19.0 x 70.0 x 70.0 mm
