pratham-cloud-ctrl/INDRBT/01_CAD_Models/STEP/Individual_Parts/base_electronics_cover.step

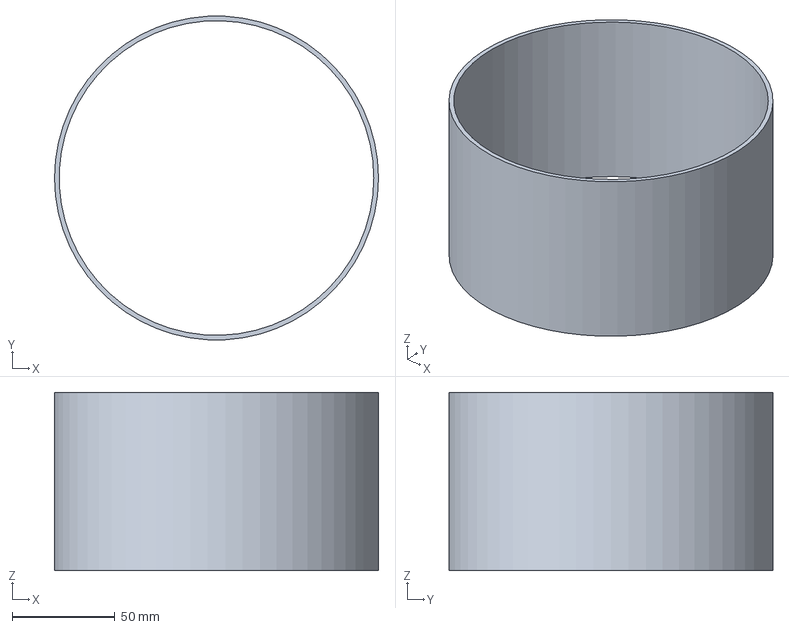
[picture p50: CAD file, 2026-10-17]
01_CAD_Models/STEP/Individual_Parts/base_electronics_cover.step
158.0 x 157.8 x 87.0 mm
