pratham-cloud-ctrl/INDRBT/06_Complete_Project_Source/cad/exports/STEP/gripper_top_service_cover.step

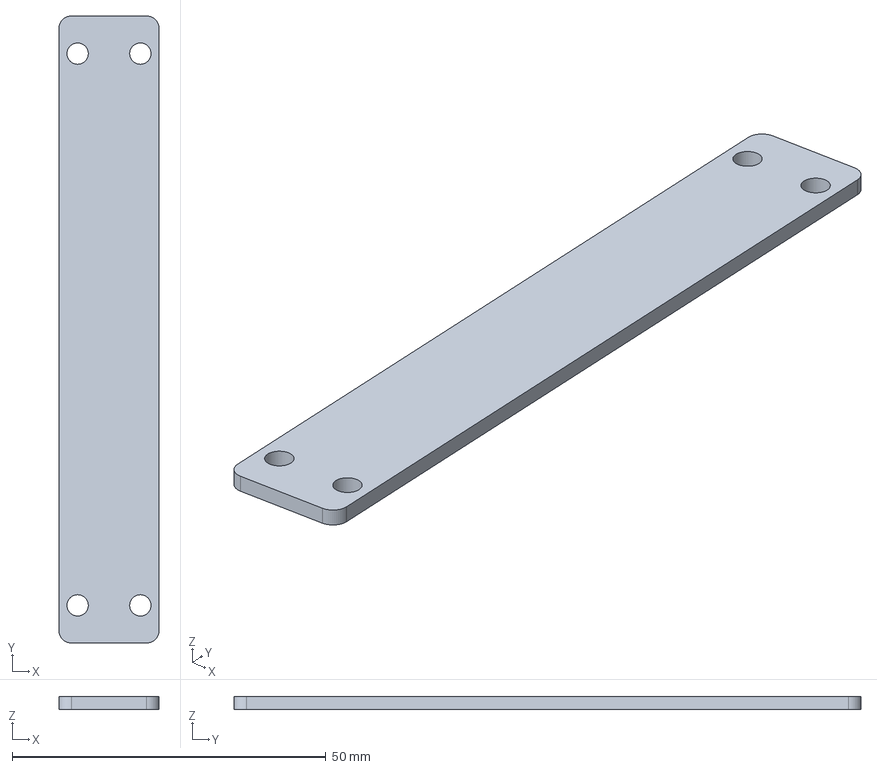
[picture p51: CAD file, 2026-10-17]
06_Complete_Project_Source/cad/exports/STEP/gripper_top_service_cover.step
16.0 x 100.0 x 2.00 mm
