pratham-cloud-ctrl/INDRBT/01_CAD_Models/STEP/Individual_Parts/wrist_pitch_rotor.step

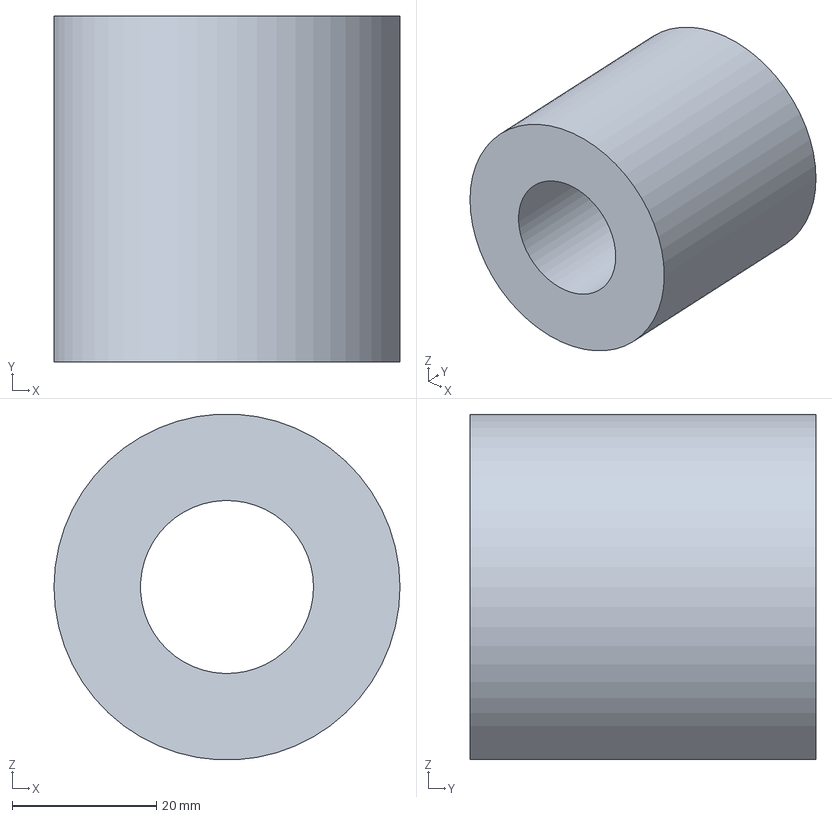
[picture p52: CAD file, 2026-10-17]
01_CAD_Models/STEP/Individual_Parts/wrist_pitch_rotor.step
48.0 x 48.0 x 47.9 mm
