pratham-cloud-ctrl/INDRBT/01_CAD_Models/STEP/Individual_Parts/j1_slew_bearing_envelope.step

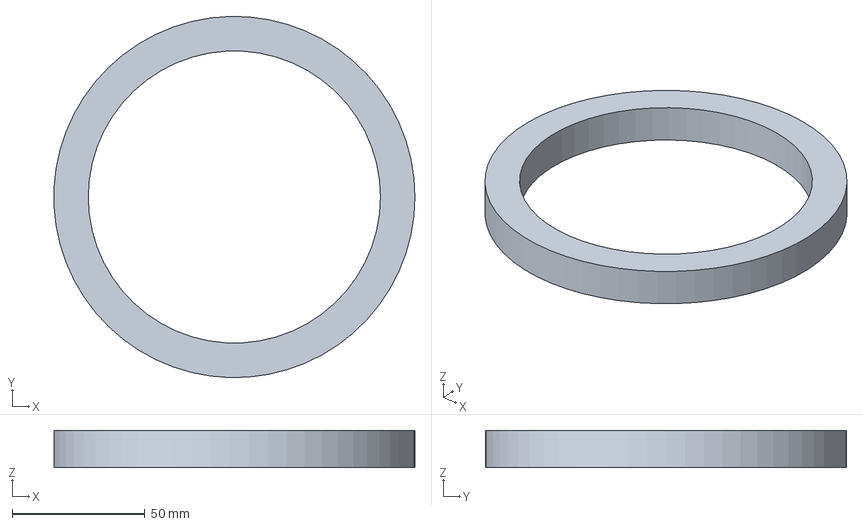
[picture p53: CAD file, 2026-10-17]
01_CAD_Models/STEP/Individual_Parts/j1_slew_bearing_envelope.step
135.9 x 136.0 x 14.0 mm
