pratham-cloud-ctrl/INDRBT/06_Complete_Project_Source/cad/exports/STEP/elbow_fork_+1.step

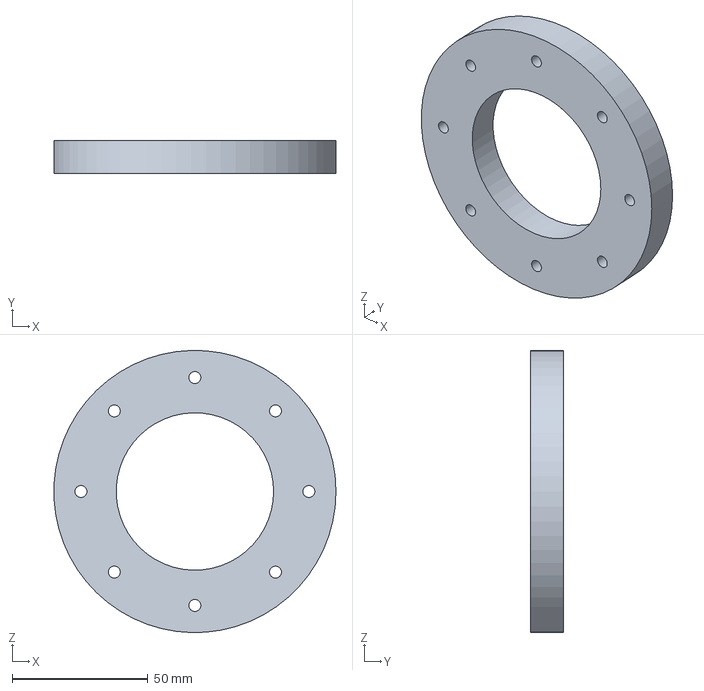
[picture p54: CAD file, 2026-10-17]
06_Complete_Project_Source/cad/exports/STEP/elbow_fork_+1.step
103.9 x 12.0 x 104.0 mm
