pratham-cloud-ctrl/INDRBT/01_CAD_Models/STEP/Individual_Parts/tool_flange_6xM5_PCD46.step

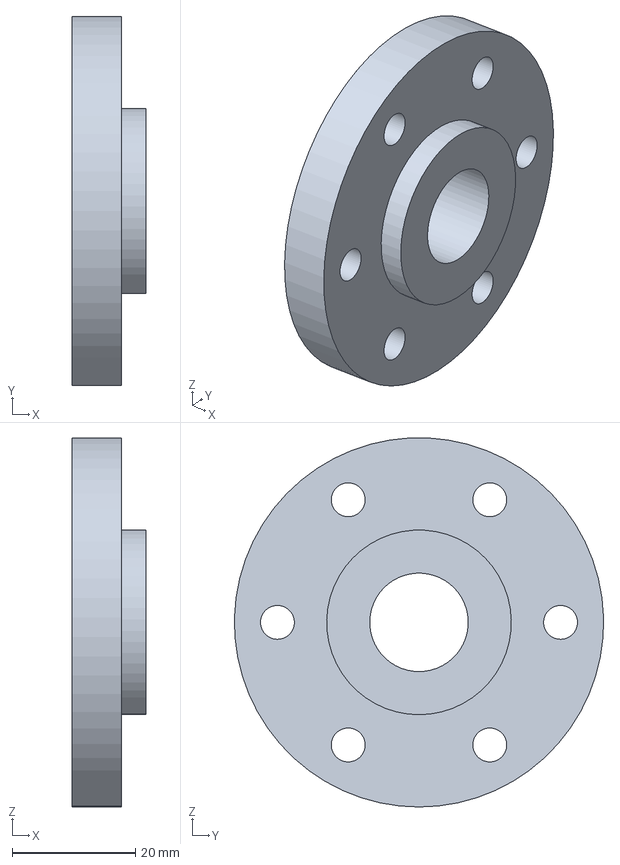
[picture p55: CAD file, 2026-10-17]
01_CAD_Models/STEP/Individual_Parts/tool_flange_6xM5_PCD46.step
12.0 x 60.0 x 60.0 mm
