pratham-cloud-ctrl/INDRBT/06_Complete_Project_Source/cad/exports/STEP/j2_gearbox_envelope.step

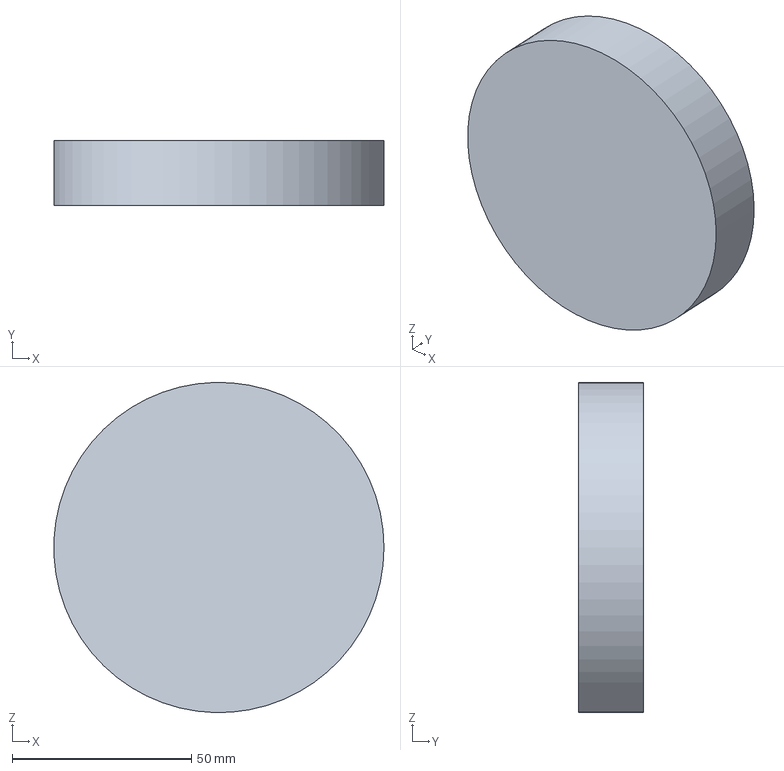
[picture p56: CAD file, 2026-10-17]
06_Complete_Project_Source/cad/exports/STEP/j2_gearbox_envelope.step
91.9 x 18.0 x 92.0 mm
