pratham-cloud-ctrl/INDRBT/01_CAD_Models/STEP/Individual_Parts/j6_stator_envelope.step

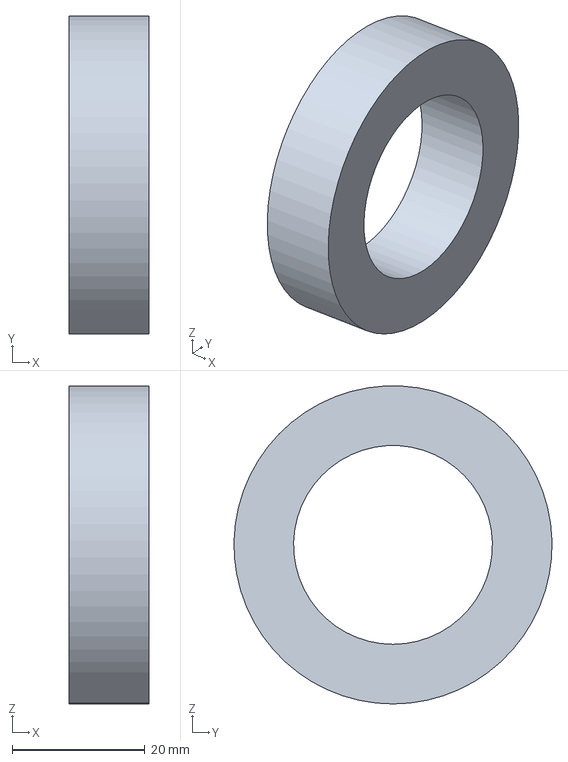
[picture p57: CAD file, 2026-10-17]
01_CAD_Models/STEP/Individual_Parts/j6_stator_envelope.step
12.0 x 48.0 x 48.0 mm
