pratham-cloud-ctrl/INDRBT/06_Complete_Project_Source/cad/exports/STEP/j4_bearing_envelope.step

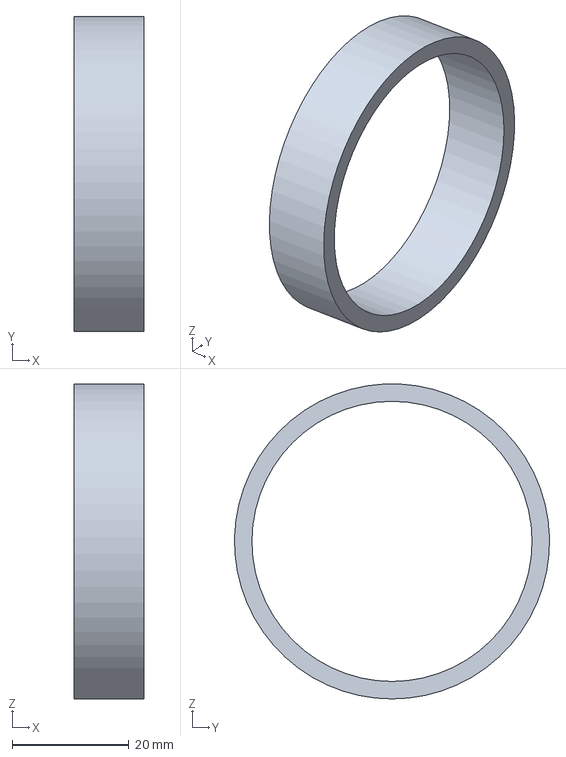
[picture p58: CAD file, 2026-10-17]
06_Complete_Project_Source/cad/exports/STEP/j4_bearing_envelope.step
12.0 x 54.0 x 54.0 mm
