pratham-cloud-ctrl/INDRBT/01_CAD_Models/STEP/Individual_Parts/interchangeable_gripper_adapter.step

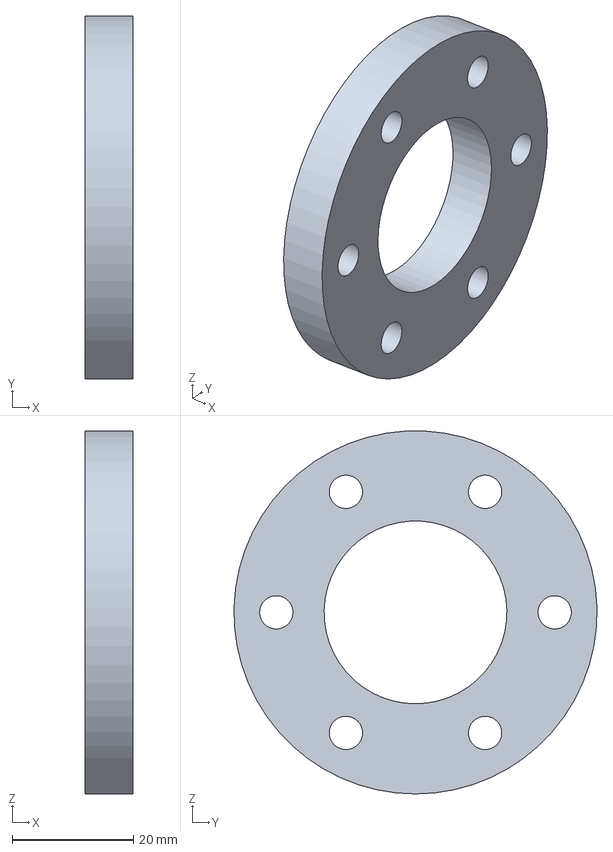
[picture p59: CAD file, 2026-10-17]
01_CAD_Models/STEP/Individual_Parts/interchangeable_gripper_adapter.step
8.00 x 60.0 x 60.0 mm
