pratham-cloud-ctrl/INDRBT/06_Complete_Project_Source/cad/exports/STEP/elbow_rotor.step

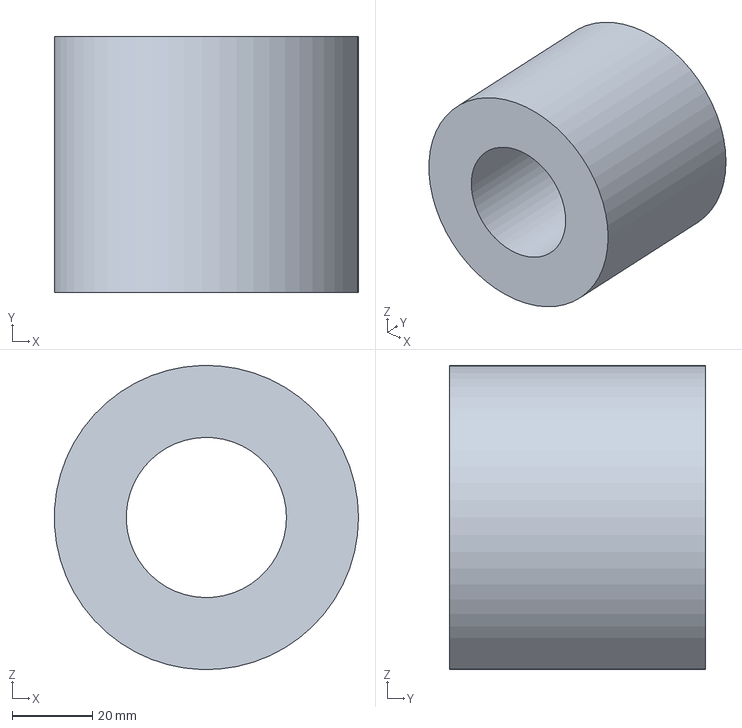
[picture p60: CAD file, 2026-10-17]
06_Complete_Project_Source/cad/exports/STEP/elbow_rotor.step
75.9 x 64.0 x 76.0 mm
