pratham-cloud-ctrl/INDRBT/01_CAD_Models/STEP/Individual_Parts/j3_gearbox_envelope.step

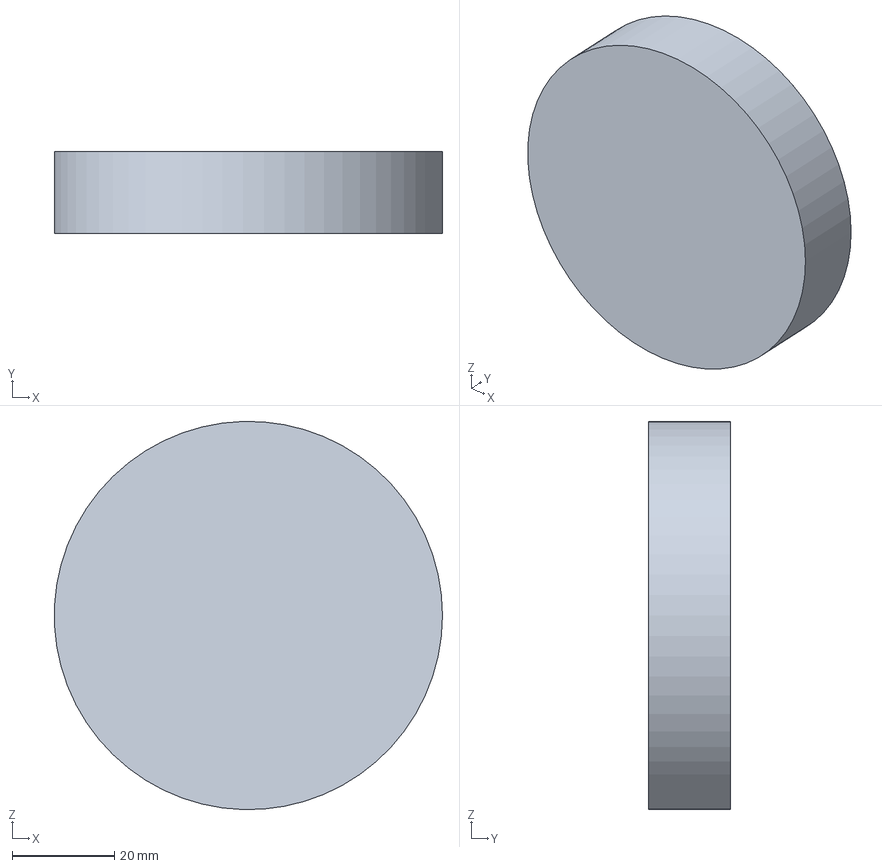
[picture p61: CAD file, 2026-10-17]
01_CAD_Models/STEP/Individual_Parts/j3_gearbox_envelope.step
75.9 x 16.0 x 76.0 mm
