pratham-cloud-ctrl/INDRBT/06_Complete_Project_Source/cad/exports/STEP/forearm_hollow_link.step

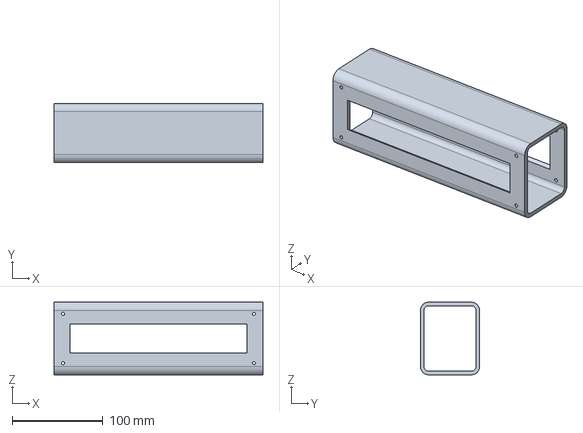
[picture p62: CAD file, 2026-10-17]
06_Complete_Project_Source/cad/exports/STEP/forearm_hollow_link.step
230.0 x 65.0 x 80.0 mm
