pratham-cloud-ctrl/INDRBT/01_CAD_Models/STEP/Individual_Parts/j2_motor_envelope.step

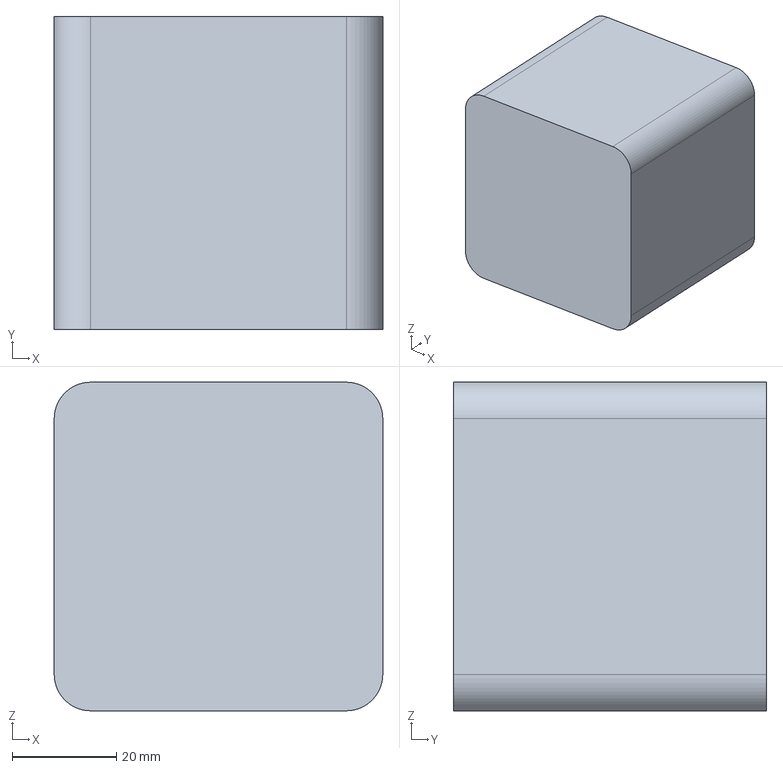
[picture p63: CAD file, 2026-10-17]
01_CAD_Models/STEP/Individual_Parts/j2_motor_envelope.step
63.0 x 60.0 x 63.0 mm
