pratham-cloud-ctrl/INDRBT/06_Complete_Project_Source/cad/exports/STEP/gripper_guide_rod_+14.step

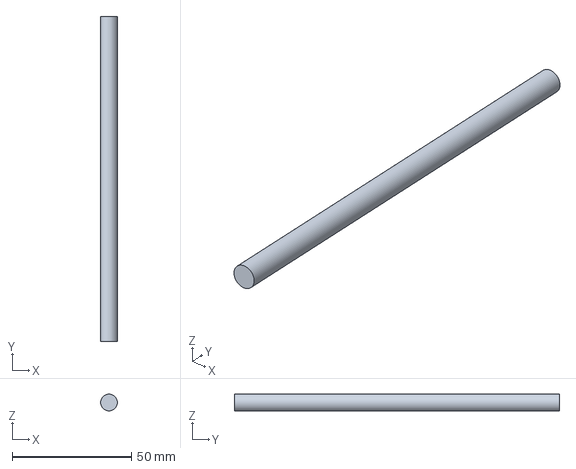
[picture p64: CAD file, 2026-10-17]
06_Complete_Project_Source/cad/exports/STEP/gripper_guide_rod_+14.step
6.99 x 136.0 x 7.00 mm
