pratham-cloud-ctrl/INDRBT/06_Complete_Project_Source/cad/exports/STEP/shoulder_output_shaft.step

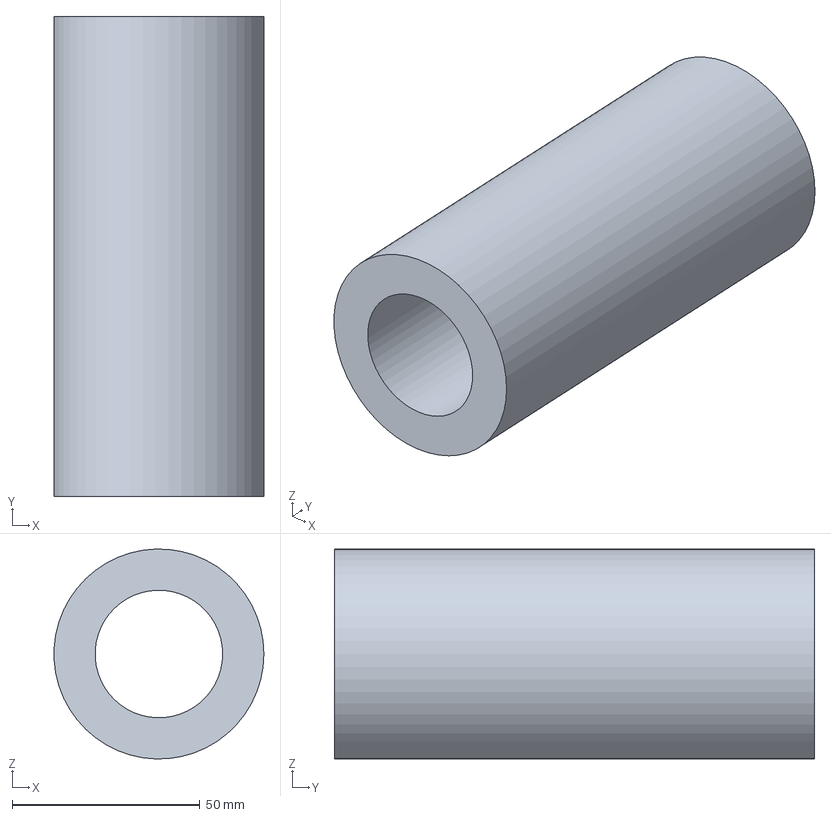
[picture p65: CAD file, 2026-10-17]
06_Complete_Project_Source/cad/exports/STEP/shoulder_output_shaft.step
55.9 x 128.0 x 56.0 mm
