pratham-cloud-ctrl/INDRBT/01_CAD_Models/STEP/Individual_Parts/shoulder_rotor.step

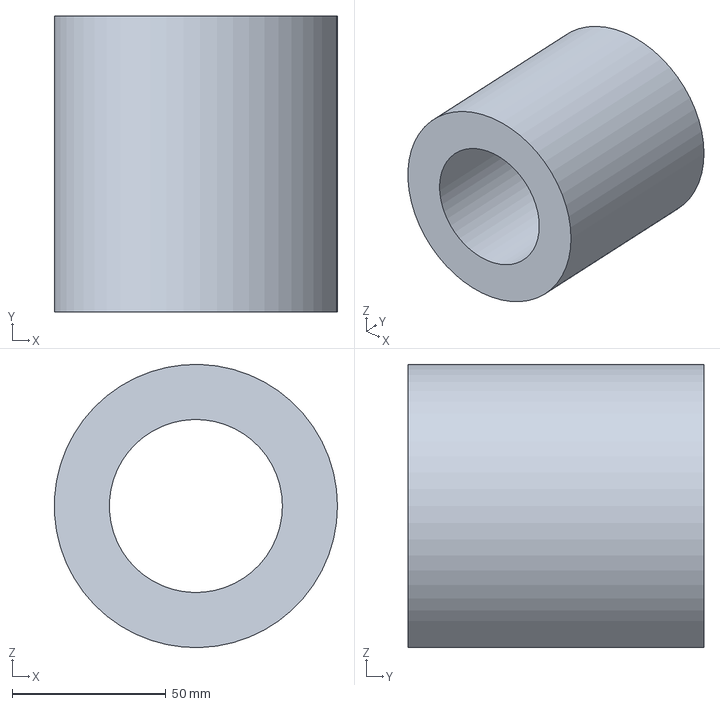
[picture p66: CAD file, 2026-10-17]
01_CAD_Models/STEP/Individual_Parts/shoulder_rotor.step
91.9 x 96.0 x 92.0 mm
