pratham-cloud-ctrl/INDRBT/06_Complete_Project_Source/cad/exports/STEP/gripper_pocketed_body.step

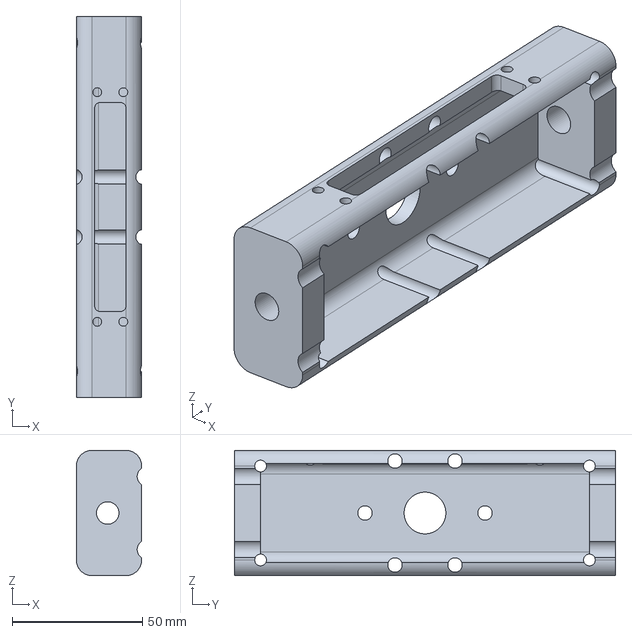
[picture p67: CAD file, 2026-10-17]
06_Complete_Project_Source/cad/exports/STEP/gripper_pocketed_body.step
25.0 x 146.0 x 48.0 mm
