pratham-cloud-ctrl/INDRBT/01_CAD_Models/STEP/Individual_Parts/wrist_roll_cover.step

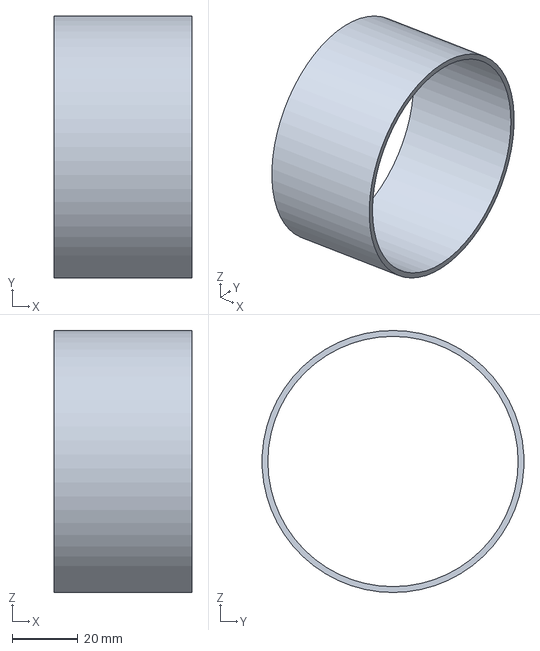
[picture p68: CAD file, 2026-10-17]
01_CAD_Models/STEP/Individual_Parts/wrist_roll_cover.step
42.0 x 79.9 x 80.0 mm
