pratham-cloud-ctrl/INDRBT/01_CAD_Models/STEP/Individual_Parts/forearm_service_cover_+1.step

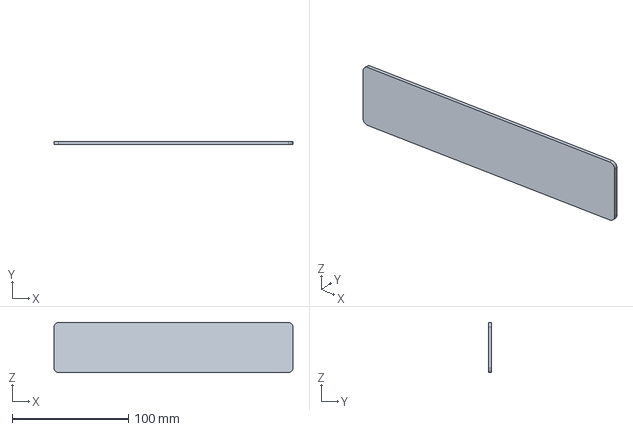
[picture p69: CAD file, 2026-10-17]
01_CAD_Models/STEP/Individual_Parts/forearm_service_cover_+1.step
206.0 x 2.50 x 43.2 mm
