pratham-cloud-ctrl/INDRBT/01_CAD_Models/STEP/Individual_Parts/gripper_actuator_envelope.step

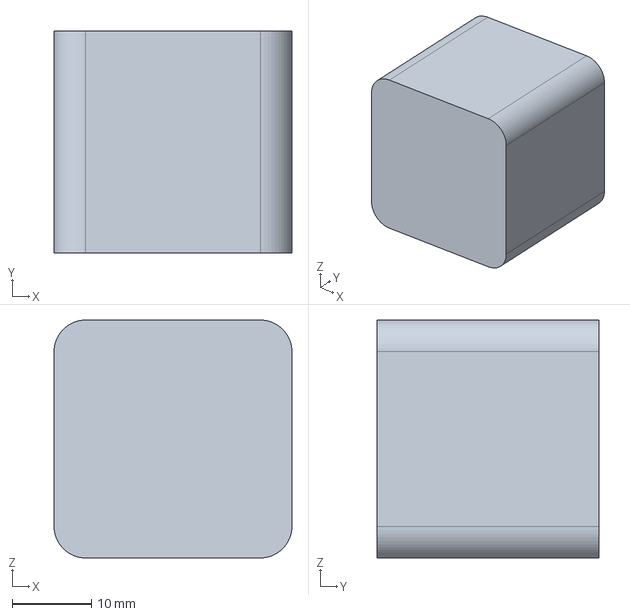
[picture p70: CAD file, 2026-10-17]
01_CAD_Models/STEP/Individual_Parts/gripper_actuator_envelope.step
30.0 x 28.0 x 30.0 mm
