pratham-cloud-ctrl/INDRBT/01_CAD_Models/STEP/Individual_Parts/turret_neck.step

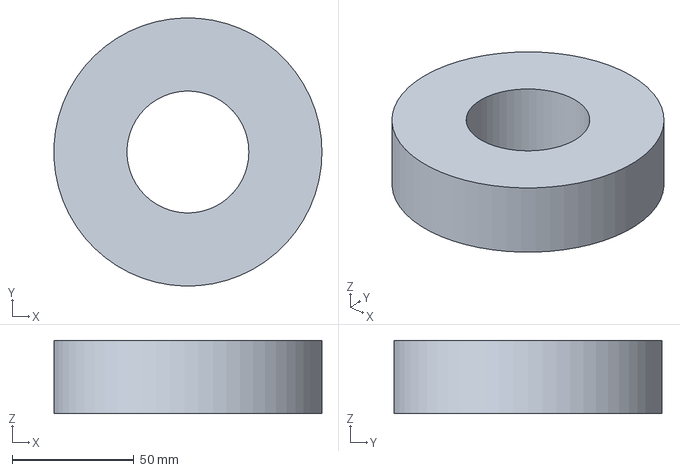
[picture p71: CAD file, 2026-10-17]
01_CAD_Models/STEP/Individual_Parts/turret_neck.step
109.9 x 110.0 x 30.0 mm
