pratham-cloud-ctrl/INDRBT/01_CAD_Models/STEP/Individual_Parts/wrist_pitch_fork_+1.step

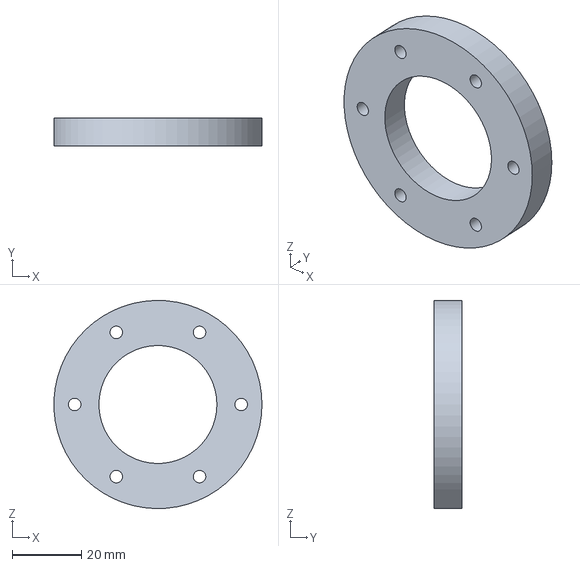
[picture p72: CAD file, 2026-10-17]
01_CAD_Models/STEP/Individual_Parts/wrist_pitch_fork_+1.step
60.0 x 8.00 x 60.0 mm
