pratham-cloud-ctrl/INDRBT/06_Complete_Project_Source/cad/exports/STEP/shoulder_bearing_+1.step

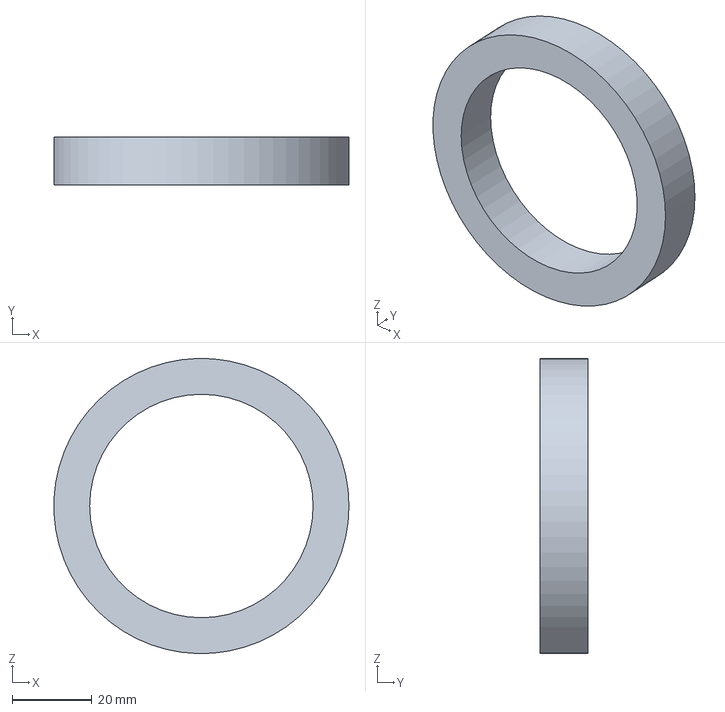
[picture p73: CAD file, 2026-10-17]
06_Complete_Project_Source/cad/exports/STEP/shoulder_bearing_+1.step
73.9 x 12.0 x 74.0 mm
