pratham-cloud-ctrl/INDRBT/01_CAD_Models/STEP/Individual_Parts/upper_arm_hollow_link.step

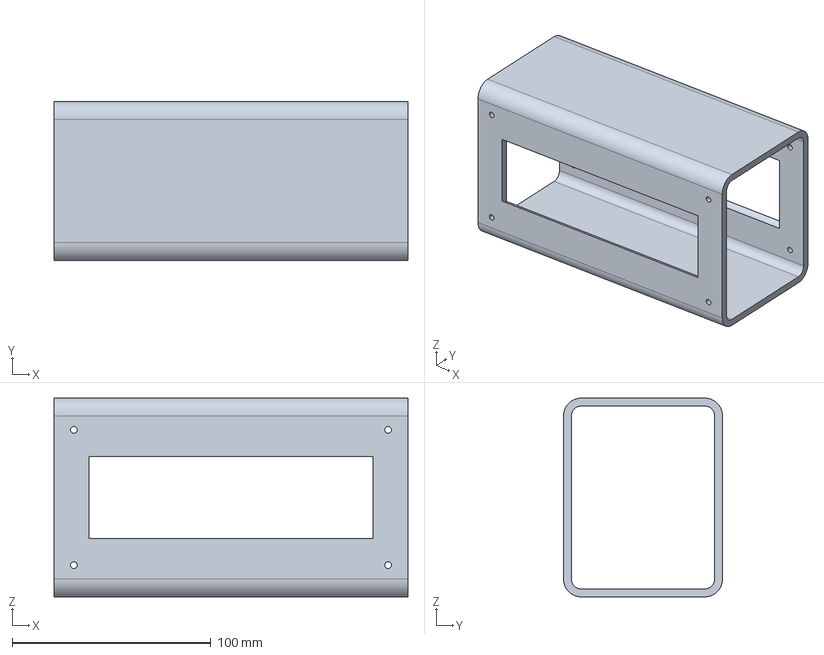
[picture p74: CAD file, 2026-10-17]
01_CAD_Models/STEP/Individual_Parts/upper_arm_hollow_link.step
178.0 x 80.0 x 100.0 mm
