pratham-cloud-ctrl/INDRBT/01_CAD_Models/STEP/Individual_Parts/fixed_base_riser.step

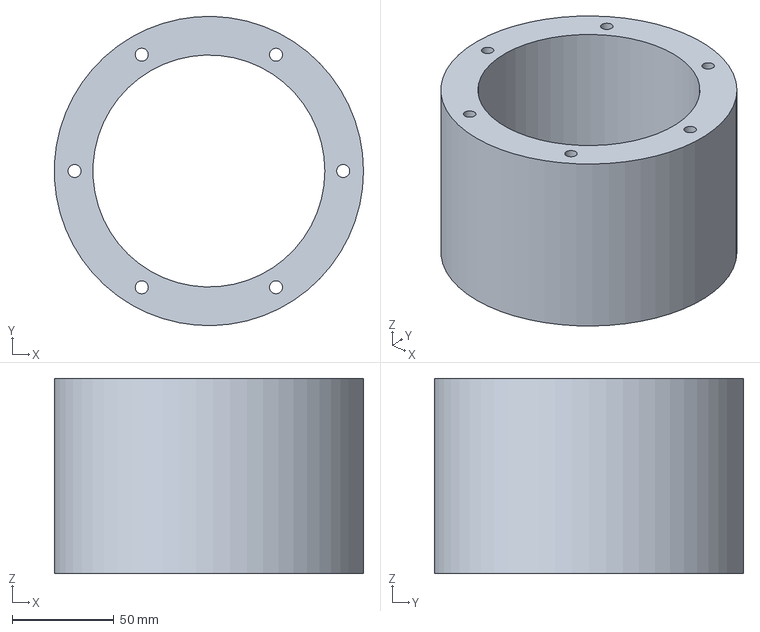
[picture p75: CAD file, 2026-10-17]
01_CAD_Models/STEP/Individual_Parts/fixed_base_riser.step
151.9 x 151.9 x 96.0 mm
