pratham-cloud-ctrl/INDRBT/06_Complete_Project_Source/cad/exports/STEP/elbow_output_shaft.step

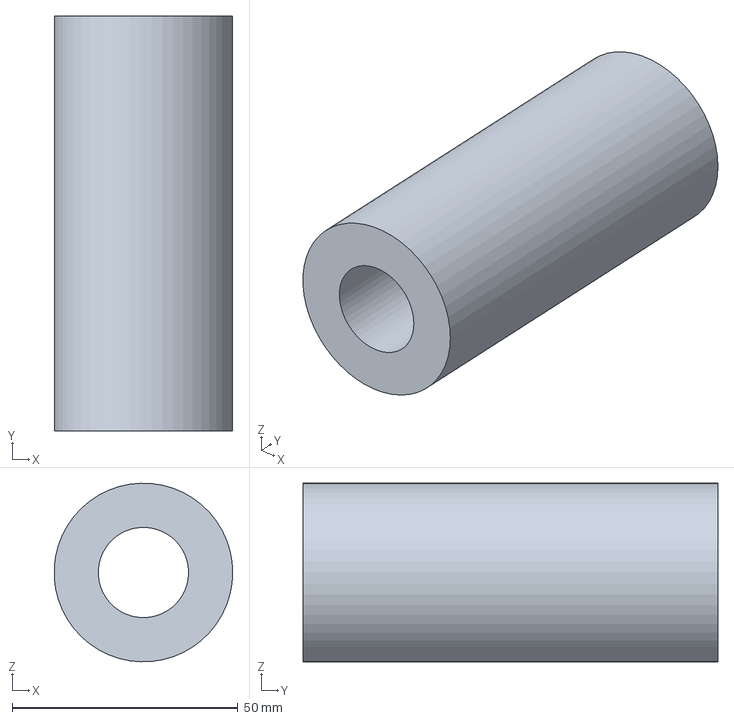
[picture p76: CAD file, 2026-10-17]
06_Complete_Project_Source/cad/exports/STEP/elbow_output_shaft.step
39.6 x 92.0 x 39.6 mm
