pratham-cloud-ctrl/INDRBT/01_CAD_Models/STEP/Individual_Parts/turret_bridge.step

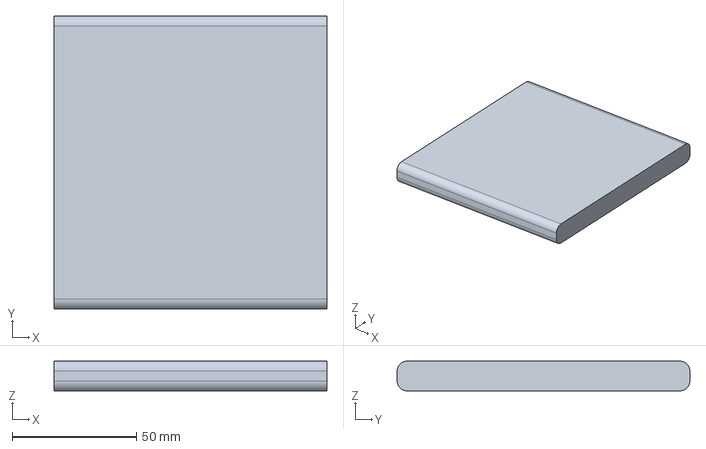
[picture p77: CAD file, 2026-10-17]
01_CAD_Models/STEP/Individual_Parts/turret_bridge.step
110.0 x 118.0 x 12.0 mm
