pratham-cloud-ctrl/INDRBT/06_Complete_Project_Source/cad/exports/STEP/j3_motor_envelope.step

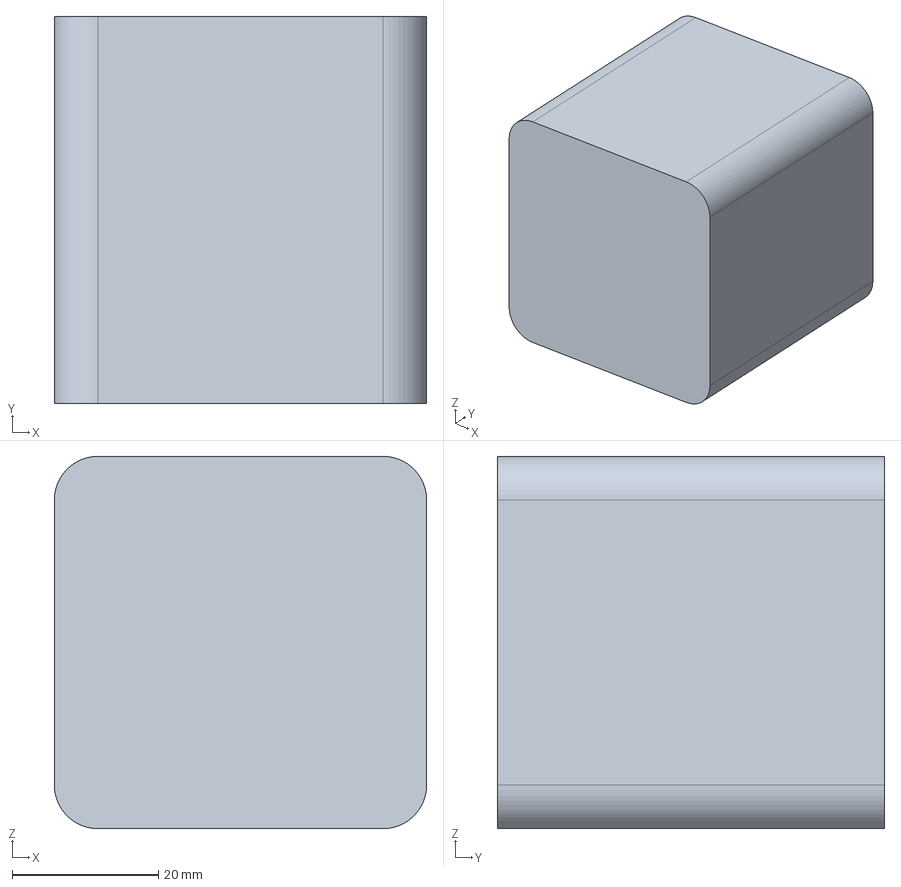
[picture p78: CAD file, 2026-10-17]
06_Complete_Project_Source/cad/exports/STEP/j3_motor_envelope.step
51.0 x 53.0 x 51.0 mm
