pratham-cloud-ctrl/INDRBT/01_CAD_Models/STEP/Individual_Parts/shoulder_fork_+1.step

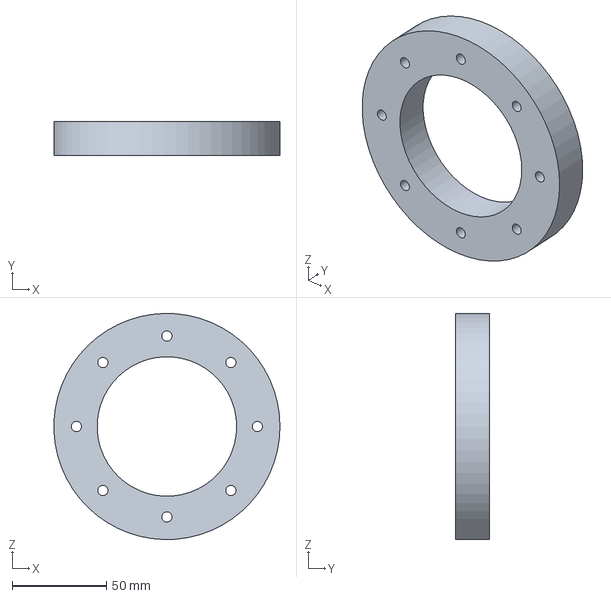
[picture p79: CAD file, 2026-10-17]
01_CAD_Models/STEP/Individual_Parts/shoulder_fork_+1.step
119.9 x 18.0 x 120.0 mm
