pratham-cloud-ctrl/INDRBT/01_CAD_Models/STEP/Individual_Parts/base_mounting_plate.step

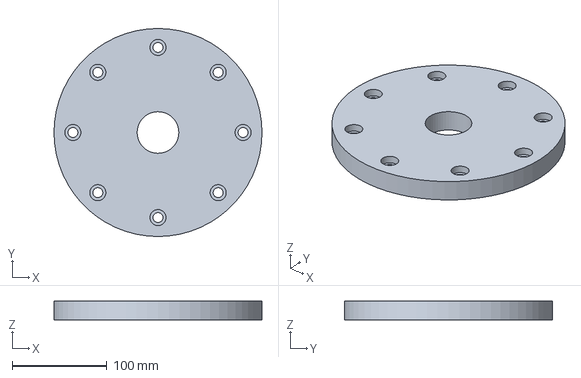
[picture p80: CAD file, 2026-10-17]
01_CAD_Models/STEP/Individual_Parts/base_mounting_plate.step
220.0 x 220.0 x 20.0 mm
