pratham-cloud-ctrl/INDRBT/01_CAD_Models/STEP/Individual_Parts/gripper_finger_+1.step

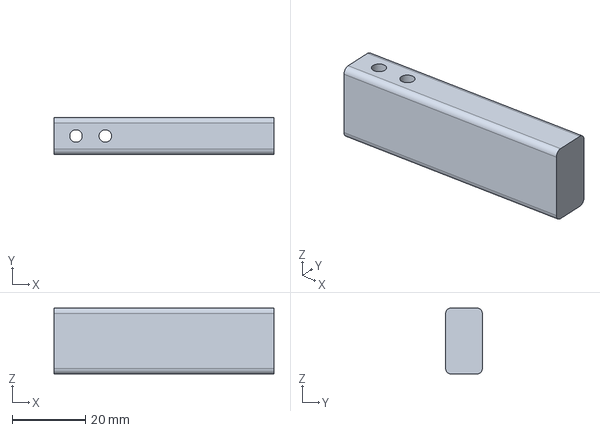
[picture p81: CAD file, 2026-10-17]
01_CAD_Models/STEP/Individual_Parts/gripper_finger_+1.step
60.0 x 10.0 x 18.0 mm
