pratham-cloud-ctrl/INDRBT/(list of files, cad)

Other CAD files:
01_CAD_Models/FreeCAD/indrbt_home.FCStd
06_Complete_Project_Source/cad/freecad/indrbt_home.FCStd
01_CAD_Models/Blender/indrbt_home.blend
01_CAD_Models/STEP/Individual_Parts/elbow_bearing_-1.step
01_CAD_Models/STEP/Individual_Parts/elbow_fork_-1.step
01_CAD_Models/STEP/Individual_Parts/elbow_fork_bridge_-1.step
01_CAD_Models/STEP/Individual_Parts/forearm_service_cover_-1.step
01_CAD_Models/STEP/Individual_Parts/gripper_contact_pad_-1.step
01_CAD_Models/STEP/Individual_Parts/gripper_finger_-1.step
01_CAD_Models/STEP/Individual_Parts/gripper_guide_rod_-14.step
01_CAD_Models/STEP/Individual_Parts/gripper_jaw_carriage_-1.step
01_CAD_Models/STEP/Individual_Parts/opposite_hand_screw_envelope.step
01_CAD_Models/STEP/Individual_Parts/shoulder_bearing_-1.step
01_CAD_Models/STEP/Individual_Parts/shoulder_fork_-1.step
01_CAD_Models/STEP/Individual_Parts/upper_service_cover_-1.step
01_CAD_Models/STEP/Individual_Parts/wrist_pitch_fork_-1.step
01_CAD_Models/STL/Assemblies/assembly_extended.stl
01_CAD_Models/STL/Assemblies/assembly_folded.stl
01_CAD_Models/STL/Assemblies/assembly_home.stl
01_CAD_Models/STL/Assemblies/assembly_pick.stl
01_CAD_Models/STL/Assemblies/assembly_place.stl
01_CAD_Models/STL/Assemblies/assembly_vertical.stl
01_CAD_Models/STL/Individual_Parts/base_electronics_cover.stl
01_CAD_Models/STL/Individual_Parts/base_mounting_plate.stl
01_CAD_Models/STL/Individual_Parts/elbow_bearing_+1.stl
01_CAD_Models/STL/Individual_Parts/elbow_bearing_-1.stl
01_CAD_Models/STL/Individual_Parts/elbow_fork_+1.stl
01_CAD_Models/STL/Individual_Parts/elbow_fork_-1.stl
01_CAD_Models/STL/Individual_Parts/elbow_fork_bridge_+1.stl
01_CAD_Models/STL/Individual_Parts/elbow_fork_bridge_-1.stl
01_CAD_Models/STL/Individual_Parts/elbow_output_shaft.stl
01_CAD_Models/STL/Individual_Parts/elbow_rotor.stl
01_CAD_Models/STL/Individual_Parts/fixed_base_riser.stl
01_CAD_Models/STL/Individual_Parts/forearm_hollow_link.stl
01_CAD_Models/STL/Individual_Parts/forearm_service_cover_+1.stl
01_CAD_Models/STL/Individual_Parts/forearm_service_cover_-1.stl
01_CAD_Models/STL/Individual_Parts/gripper_actuator_envelope.stl
01_CAD_Models/STL/Individual_Parts/gripper_contact_pad_+1.stl
01_CAD_Models/STL/Individual_Parts/gripper_contact_pad_-1.stl
01_CAD_Models/STL/Individual_Parts/gripper_finger_+1.stl
01_CAD_Models/STL/Individual_Parts/gripper_finger_-1.stl
01_CAD_Models/STL/Individual_Parts/gripper_guide_rod_+14.stl
01_CAD_Models/STL/Individual_Parts/gripper_guide_rod_-14.stl
01_CAD_Models/STL/Individual_Parts/gripper_jaw_carriage_+1.stl
01_CAD_Models/STL/Individual_Parts/gripper_jaw_carriage_-1.stl
01_CAD_Models/STL/Individual_Parts/gripper_pocketed_body.stl
01_CAD_Models/STL/Individual_Parts/gripper_top_service_cover.stl
01_CAD_Models/STL/Individual_Parts/interchangeable_gripper_adapter.stl
01_CAD_Models/STL/Individual_Parts/j1_slew_bearing_envelope.stl
01_CAD_Models/STL/Individual_Parts/j2_gearbox_envelope.stl
01_CAD_Models/STL/Individual_Parts/j2_motor_endcap.stl
01_CAD_Models/STL/Individual_Parts/j2_motor_envelope.stl
01_CAD_Models/STL/Individual_Parts/j3_gearbox_envelope.stl
01_CAD_Models/STL/Individual_Parts/j3_motor_envelope.stl
01_CAD_Models/STL/Individual_Parts/j4_bearing_envelope.stl
01_CAD_Models/STL/Individual_Parts/j6_stator_envelope.stl
01_CAD_Models/STL/Individual_Parts/opposite_hand_screw_envelope.stl
01_CAD_Models/STL/Individual_Parts/shoulder_bearing_+1.stl
01_CAD_Models/STL/Individual_Parts/shoulder_bearing_-1.stl
01_CAD_Models/STL/Individual_Parts/shoulder_fork_+1.stl
01_CAD_Models/STL/Individual_Parts/shoulder_fork_-1.stl
01_CAD_Models/STL/Individual_Parts/shoulder_output_shaft.stl
01_CAD_Models/STL/Individual_Parts/shoulder_rotor.stl
01_CAD_Models/STL/Individual_Parts/tool_flange_6xM5_PCD46.stl
01_CAD_Models/STL/Individual_Parts/turret_bridge.stl
01_CAD_Models/STL/Individual_Parts/turret_neck.stl
01_CAD_Models/STL/Individual_Parts/upper_arm_hollow_link.stl
01_CAD_Models/STL/Individual_Parts/upper_service_cover_+1.stl
01_CAD_Models/STL/Individual_Parts/upper_service_cover_-1.stl
01_CAD_Models/STL/Individual_Parts/wrist_pitch_fork_+1.stl
01_CAD_Models/STL/Individual_Parts/wrist_pitch_fork_-1.stl
01_CAD_Models/STL/Individual_Parts/wrist_pitch_neck.stl
01_CAD_Models/STL/Individual_Parts/wrist_pitch_rotor.stl
01_CAD_Models/STL/Individual_Parts/wrist_roll_cover.stl
01_CAD_Models/STL/Individual_Parts/wrist_roll_rotor.stl
01_CAD_Models/STL/Individual_Parts/wrist_roll_stator.stl
06_Complete_Project_Source/cad/exports/STEP/elbow_bearing_-1.step
06_Complete_Project_Source/cad/exports/STEP/elbow_fork_-1.step
06_Complete_Project_Source/cad/exports/STEP/elbow_fork_bridge_-1.step
06_Complete_Project_Source/cad/exports/STEP/forearm_service_cover_-1.step
06_Complete_Project_Source/cad/exports/STEP/gripper_contact_pad_-1.step
06_Complete_Project_Source/cad/exports/STEP/gripper_finger_-1.step
06_Complete_Project_Source/cad/exports/STEP/gripper_guide_rod_-14.step
06_Complete_Project_Source/cad/exports/STEP/gripper_jaw_carriage_-1.step
06_Complete_Project_Source/cad/exports/STEP/opposite_hand_screw_envelope.step
06_Complete_Project_Source/cad/exports/STEP/shoulder_bearing_-1.step
06_Complete_Project_Source/cad/exports/STEP/shoulder_fork_-1.step
06_Complete_Project_Source/cad/exports/STEP/upper_service_cover_-1.step
06_Complete_Project_Source/cad/exports/STEP/wrist_pitch_fork_-1.step
06_Complete_Project_Source/cad/exports/STL/assembly_extended.stl
06_Complete_Project_Source/cad/exports/STL/assembly_folded.stl
06_Complete_Project_Source/cad/exports/STL/assembly_home.stl
06_Complete_Project_Source/cad/exports/STL/assembly_pick.stl
06_Complete_Project_Source/cad/exports/STL/assembly_place.stl
06_Complete_Project_Source/cad/exports/STL/assembly_vertical.stl
06_Complete_Project_Source/cad/exports/STL/base_electronics_cover.stl
06_Complete_Project_Source/cad/exports/STL/base_mounting_plate.stl
06_Complete_Project_Source/cad/exports/STL/elbow_bearing_+1.stl
06_Complete_Project_Source/cad/exports/STL/elbow_bearing_-1.stl
06_Complete_Project_Source/cad/exports/STL/elbow_fork_+1.stl
06_Complete_Project_Source/cad/exports/STL/elbow_fork_-1.stl
06_Complete_Project_Source/cad/exports/STL/elbow_fork_bridge_+1.stl
06_Complete_Project_Source/cad/exports/STL/elbow_fork_bridge_-1.stl
06_Complete_Project_Source/cad/exports/STL/elbow_output_shaft.stl
06_Complete_Project_Source/cad/exports/STL/elbow_rotor.stl
06_Complete_Project_Source/cad/exports/STL/fixed_base_riser.stl
06_Complete_Project_Source/cad/exports/STL/forearm_hollow_link.stl
06_Complete_Project_Source/cad/exports/STL/forearm_service_cover_+1.stl
06_Complete_Project_Source/cad/exports/STL/forearm_service_cover_-1.stl
06_Complete_Project_Source/cad/exports/STL/gripper_actuator_envelope.stl
06_Complete_Project_Source/cad/exports/STL/gripper_contact_pad_+1.stl
06_Complete_Project_Source/cad/exports/STL/gripper_contact_pad_-1.stl
06_Complete_Project_Source/cad/exports/STL/gripper_finger_+1.stl
06_Complete_Project_Source/cad/exports/STL/gripper_finger_-1.stl
06_Complete_Project_Source/cad/exports/STL/gripper_guide_rod_+14.stl
06_Complete_Project_Source/cad/exports/STL/gripper_guide_rod_-14.stl
06_Complete_Project_Source/cad/exports/STL/gripper_jaw_carriage_+1.stl
06_Complete_Project_Source/cad/exports/STL/gripper_jaw_carriage_-1.stl
06_Complete_Project_Source/cad/exports/STL/gripper_pocketed_body.stl
06_Complete_Project_Source/cad/exports/STL/gripper_top_service_cover.stl
06_Complete_Project_Source/cad/exports/STL/interchangeable_gripper_adapter.stl
06_Complete_Project_Source/cad/exports/STL/j1_slew_bearing_envelope.stl
06_Complete_Project_Source/cad/exports/STL/j2_gearbox_envelope.stl
06_Complete_Project_Source/cad/exports/STL/j2_motor_endcap.stl
06_Complete_Project_Source/cad/exports/STL/j2_motor_envelope.stl
06_Complete_Project_Source/cad/exports/STL/j3_gearbox_envelope.stl
06_Complete_Project_Source/cad/exports/STL/j3_motor_envelope.stl
06_Complete_Project_Source/cad/exports/STL/j4_bearing_envelope.stl
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
