pratham-cloud-ctrl/INDRBT/02_Simulation_and_Animation/Control/pid_step_response.png

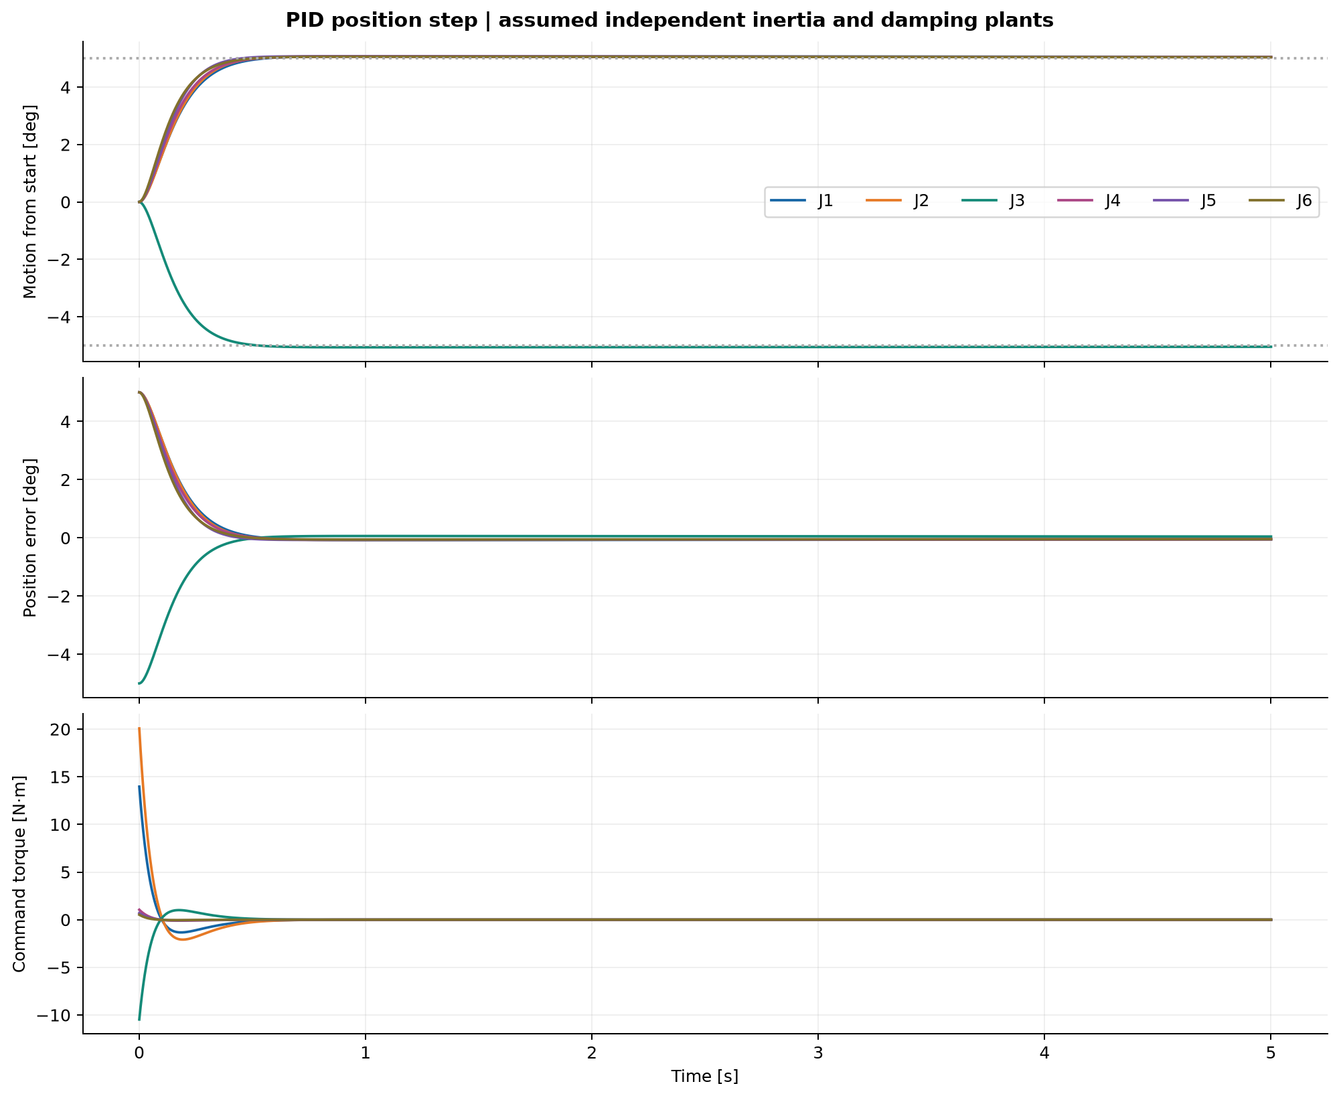
02_Simulation_and_Animation/Control/pid_step_response.png
