pratham-cloud-ctrl/INDRBT/Project_Guide_Preview.png

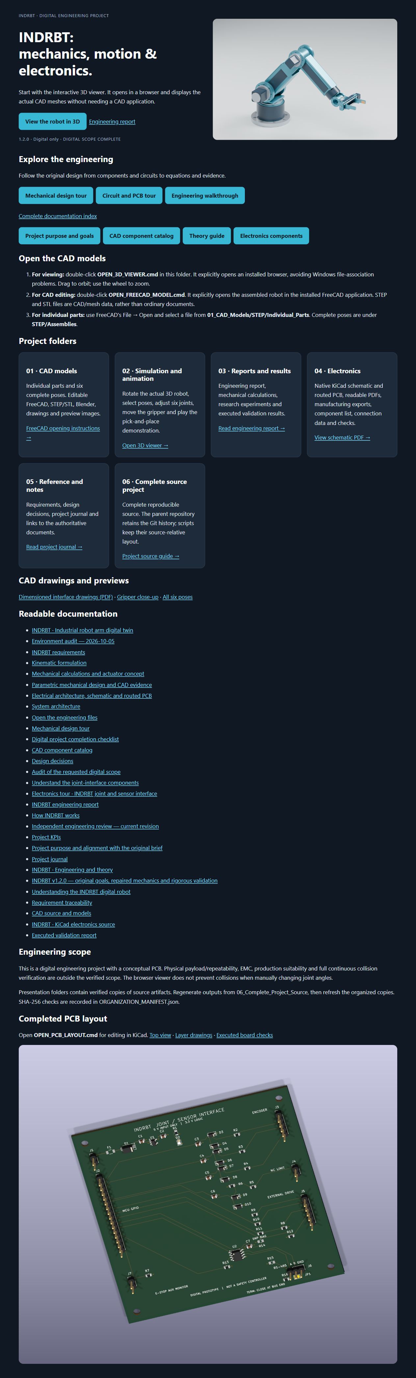
Project_Guide_Preview.png
