pratham-cloud-ctrl/INDRBT/03_Reports_and_Results/README.md

# Theory, calculations and engineering evidence

[← Project home](../README.md) · [CAD](../01_CAD_Models/README.md) · [Electronics & KiCad](../04_Electronics/README.md)

**[Read the public engineering walkthrough](https://pratham-cloud-ctrl.github.io/INDRBT/#theory) · [Open the browser design library](https://pratham-cloud-ctrl.github.io/INDRBT/#guides)** — the included chapters and figures are accessible without a GitHub account.

**Start with the [illustrated engineering walkthrough](../06_Complete_Project_Source/docs/engineering_walkthrough.md).** Follow the reasoning from robot geometry through a useful motion, assumed loads, gripper mechanics, feedback control and the interface board.

Coordinate frames from the implemented robot model

For optional native application inspection, use the [public engineering download release](https://github.com/pratham-cloud-ctrl/INDRBT/releases/tag/indrbt-2026-10-28) and [CAD/KiCad opening guide](../06_Complete_Project_Source/docs/cad_downloads.md). Four focused packs and the combined offline viewer/CAD pack are available publicly through GitHub. The published GitHub Pages showcase includes the browser viewers and download controls.

## Choose a reading route

| Your goal | Start here | Continue with |
|---|---|---|
| Understand the whole idea | [Project purpose and goals](../06_Complete_Project_Source/docs/project_alignment.md) | [Illustrated walkthrough](../06_Complete_Project_Source/docs/engineering_walkthrough.md) |
| Learn the equations | [Theory guide](../06_Complete_Project_Source/docs/theory_guide.md) | [Kinematics](../06_Complete_Project_Source/docs/02_kinematics.md) · [Mechanics](../06_Complete_Project_Source/docs/03_mechanical_analysis.md) |
| Assess the design | [Engineering report](../06_Complete_Project_Source/docs/engineering_report.md) | [Requirements matrix](../06_Complete_Project_Source/docs/validation_matrix.md) · [Design decisions](../06_Complete_Project_Source/docs/design_decisions.md) |
| Reproduce a result | [Complete documentation index](../06_Complete_Project_Source/docs/README.md) | [Source installation and commands](../06_Complete_Project_Source/README.md#run) |

## Inspect the evidence behind each chapter

| Topic | Readable result | Underlying data |
|---|---|---|
| Workspace and singularities | [Workspace plots](../02_Simulation_and_Animation/README.md#workspace-and-feedback) | [Workspace result files](../02_Simulation_and_Animation/Workspace) |
| Motion planning | [Pick/place path](../02_Simulation_and_Animation/Trajectories/pick_place_tcp.png) · [Joint curves](../02_Simulation_and_Animation/Trajectories/pick_place_joints.png) | [Recorded task CSV](../02_Simulation_and_Animation/Trajectories/pick_place.csv) |
| Feedback control | [PID tracking](../02_Simulation_and_Animation/Control/pid_tracking.png) | [Control metrics](../02_Simulation_and_Animation/Control/metrics.json) |
| Mechanical sizing and gripper | [Analysis chapter](../06_Complete_Project_Source/docs/03_mechanical_analysis.md) | [Mechanical results](Mechanical) |
| Design trade-offs | [Five research experiments](../06_Complete_Project_Source/docs/engineering_report.md) | [Experiment results and plots](Research) |
| Verification | [Executed validation report](Validation/validation_report.md) | [CAD review](Validation/final_cad_review.json) · [Electronics review](Validation/final_electronics_review.json) · [Theory review](Validation/final_theory_review.json) |

Markdown chapters also render directly on GitHub. For optional offline reading, download the project and open **OPEN_PROJECT_HOME.cmd**; [Readable_Reports](Readable_Reports) contains the matching local HTML chapters.

Results distinguish assumptions, targets, calculations, simulations and digital checks. Payload and repeatability remain physical design targets. The [scope audit](../06_Complete_Project_Source/docs/digital_scope_audit.md) explains what the models establish.
