pratham-cloud-ctrl/INDRBT/03_Reports_and_Results/Validation/validation_report.md

# Executed validation report

Status: **DIGITAL SCOPE COMPLETE**. Physical performance is unverified.

| Check | Result |
|---|---|
| KiCad ERC / PCB DRC / connectivity | PASS |
| Automated numerical/CAD tests | PASS |
| Configuration validation | PASS |
| FK / IK / Jacobian random trials | PASS |
| CAD / task / parameter consistency | PASS |
| Code lint | PASS |
| Documentation links and coverage | PASS |
| Validation source revision consistency | PASS |

## Verified scope limitations

- Collision evidence is representative and sampled, not a continuous swept collision certificate
- Payload and repeatability remain design targets; no physical robot was built
- Analytical structure and independent-axis control are the documented educational models
- The conceptual PCB has no physical thermal, EMC, ESD or functional-safety validation
