pratham-cloud-ctrl/INDRBT/06_Complete_Project_Source/results/control/tracking.csv

t_s | desired_q1_rad | desired_q2_rad | desired_q3_rad | desired_q4_rad | desired_q5_rad | desired_q6_rad | actual_q1_rad | actual_q2_rad | actual_q3_rad | actual_q4_rad | actual_q5_rad | actual_q6_rad | torque1_Nm | torque2_Nm | torque3_Nm | torque4_Nm | torque5_Nm | torque6_Nm
0 | 0 | -0.872664626 | 1.570796327 | 0 | -0.6981317008 | 0 | 0 | -0.872664626 | 1.570796327 | 0 | -0.6981317008 | 0 | 0 | 0 | 0 | 0 | 0 | 0
0.001999995579 | -1.47485749e-07 | -0.8726646493 | 1.570796353 | -4.298623267e-22 | -0.6981311733 | -2.117137387e-22 | 0 | -0.872664626 | 1.570796327 | 0 | -0.6981317008 | 0 | -0.001586786851 | -0.000347066157 | 0.0001990229991 | -3.205788838e-19 | 0.0002407806222 | -7.031449032e-20
0.003999991158 | -2.949714981e-07 | -0.8726646726 | 1.57079638 | -8.597246533e-22 | -0.6981306457 | -4.234274774e-22 | -5.28926612e-09 | -0.8726646268 | 1.570796328 | -1.602887333e-23 | -0.6981316815 | -9.37522393e-24 | -0.003103971074 | -0.0006800732103 | 0.0003889710837 | -6.265402308e-19 | 0.0004708136349 | -1.368228338e-19
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
