pratham-cloud-ctrl/INDRBT/06_Complete_Project_Source/results/trajectories/move_j.csv

time_s | q1_rad | q2_rad | q3_rad | q4_rad | q5_rad | q6_rad | dq1_rad_s | dq2_rad_s | dq3_rad_s | dq4_rad_s | dq5_rad_s | dq6_rad_s | ddq1_rad_s2 | ddq2_rad_s2 | ddq3_rad_s2 | ddq4_rad_s2 | ddq5_rad_s2 | ddq6_rad_s2
0 | 0 | -0.872664626 | 1.570796327 | 0 | -0.6981317008 | 0 | 0 | 0 | 0 | 0 | 0 | 0 | 0 | 0 | 0 | 0 | 0 | 0
0.02 | 5.41332957e-07 | -0.8726645177 | 1.570796435 | 0 | -0.6981299685 | 0 | 8.099623091e-05 | 1.619924618e-05 | 1.619924618e-05 | 0 | 0.0002591879389 | 0 | 0.008058921467 | 0.001611784293 | 0.001611784293 | 0 | 0.0257885487 | 0
0.04 | 4.298135082e-06 | -0.8726637664 | 1.570797186 | 0 | -0.6981179468 | 0 | 0.000320736975 | 6.4147395e-05 | 6.4147395e-05 | 0 | 0.00102635832 | 0 | 0.01587486038 | 0.003174972076 | 0.003174972076 | 0 | 0.05079955321 | 0
0.06 | 1.439686375e-05 | -0.8726617466 | 1.570799206 | 0 | -0.6980856308 | 0 | 0.0007143871248 | 0.000142877425 | 0.000142877425 | 0 | 0.002286038799 | 0 | 0.0234502711 | 0.00469005422 | 0.00469005422 | 0 | 0.07504086752 | 0
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
