pratham-cloud-ctrl/INDRBT/06_Complete_Project_Source/results/trajectories/move_l.csv

time_s | q1_rad | q2_rad | q3_rad | q4_rad | q5_rad | q6_rad | dq1_rad_s | dq2_rad_s | dq3_rad_s | dq4_rad_s | dq5_rad_s | dq6_rad_s | ddq1_rad_s2 | ddq2_rad_s2 | ddq3_rad_s2 | ddq4_rad_s2 | ddq5_rad_s2 | ddq6_rad_s2
0 | -0.436332313 | -0.7853981634 | 1.658062789 | 0 | 0.6981317008 | 0 | 0 | 0 | 0 | 0 | 0 | 0 | 0 | 0 | 0 | 0 | 0 | 0
0.0101 | -0.436332313 | -0.7853998204 | 1.65806294 | 1.397220369e-15 | 0.6981332068 | -1.815430597e-14 | -7.035076592e-15 | -0.0006463584867 | 5.890145603e-05 | -1.240417581e-15 | 0.0005874570306 | -3.549121762e-15 | 2.110522978e-10 | -0.1180493595 | 0.01075486312 | -1.709375857e-11 | 0.1072944943 | 2.220856164e-10
0.0202 | -0.436332313 | -0.7854112198 | 1.658063979 | -2.505643514e-17 | 0.6981435674 | -7.16922596e-17 | 8.512442676e-13 | -0.002066355103 | 0.000188250217 | -6.73762047e-14 | 0.001878104878 | 8.947665015e-13 | 5.224066776e-13 | -0.1842543049 | 0.01677320719 | 1.986821629e-13 | 0.1674810977 | 1.427666433e-13
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
