pratham-cloud-ctrl/INDRBT/06_Complete_Project_Source/results/workspace/samples.csv

x_m | y_m | z_m | scaled_sigma_min
0.57761527 | 0.326962328 | 0.310549734 | 0.0485374279
-0.0719545326 | -0.356746536 | 0.384311961 | 0.0806283283
0.108566818 | -0.0817953595 | -0.194989933 | 0.159710798
0.0987888713 | -0.236504177 | 0.774828226 | 0.0451956382
-0.0115920849 | 0.0734454779 | -0.136087724 | 0.0670403637
0.112919101 | -0.101440825 | 0.71354048 | 0.169883502
-0.0248534858 | -0.6265374 | 0.616094929 | 0.0220687374
0.148132724 | -0.305428109 | -0.328160622 | 0.186775567
0.135751893 | 0.223530233 | 0.114553355 | 0.236169358
-0.192882103 | 0.0303909054 | -0.356799169 | 0.0575213185
0.412649064 | 0.484647486 | 0.224289269 | 0.110635112
-0.0925911139 | -0.233569934 | 0.101729275 | 0.202396933
-0.643198772 | -0.280953458 | 0.138438155 | 0.0526138332
-0.0701401171 | -0.698049441 | 0.0462878777 | 0.0866815561
0.106374146 | -0.0570915853 | -0.290078844 | 0.0920293393
0.505100815 | -0.200625321 | 0.29484986 | 0.109576658
0.448514978 | -0.0945714462 | 0.710558069 | 0.140881715
-0.0916139028 | 0.155595776 | -0.0115756199 | 0.107921084
-0.046067237 | -0.531343697 | 0.419204044 | 0.192545924
-0.359340512 | 0.381706664 | 0.0594020472 | 0.122996665
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
