pratham-cloud-ctrl/INDRBT/03_Reports_and_Results/Research/duration.png

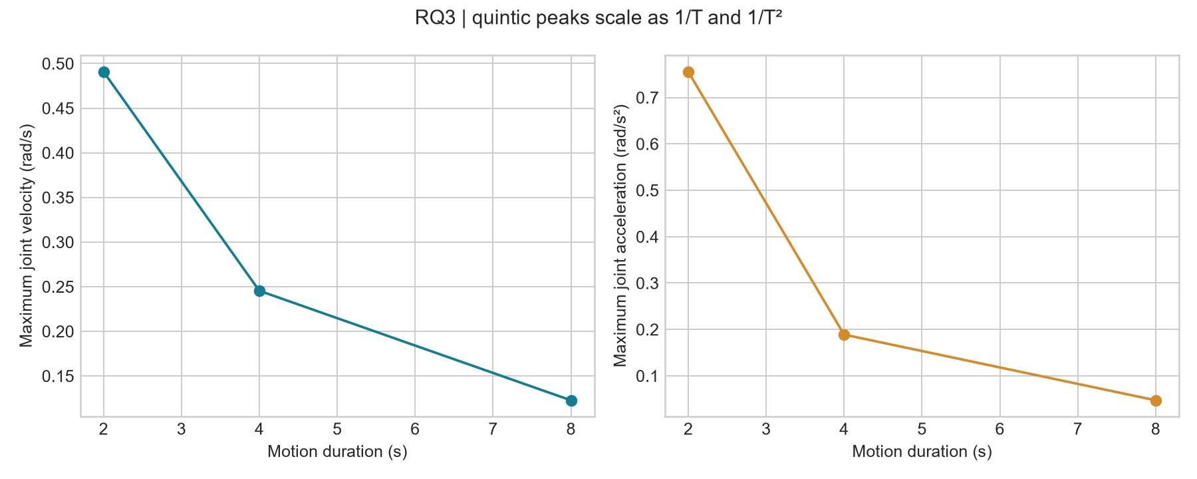
03_Reports_and_Results/Research/duration.png
