pratham-cloud-ctrl/INDRBT/03_Reports_and_Results/Research/finger_length.png

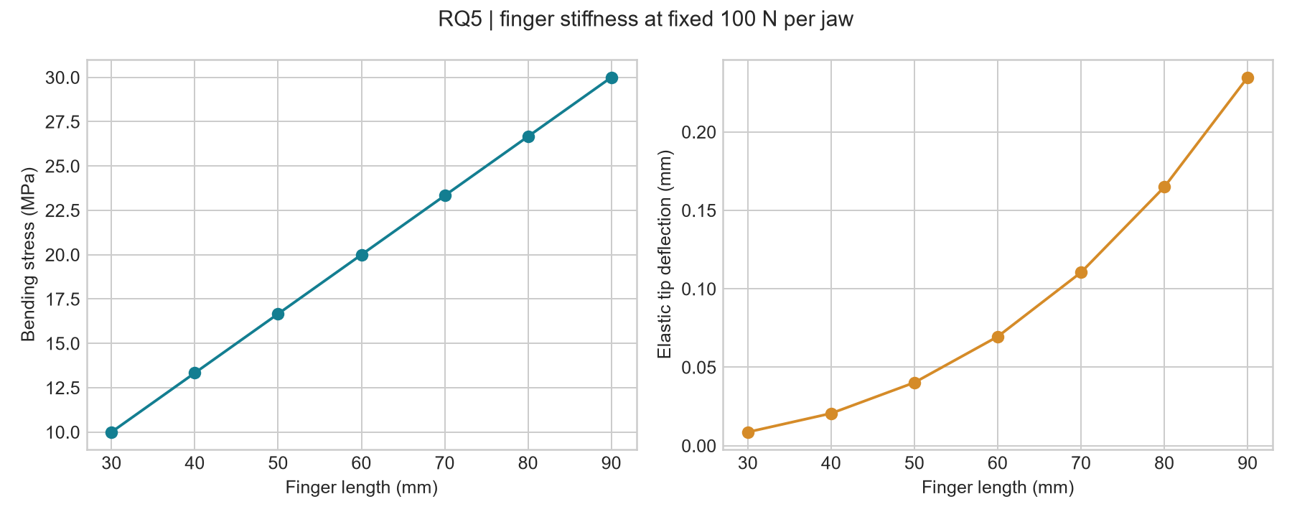
03_Reports_and_Results/Research/finger_length.png
