pratham-cloud-ctrl/INDRBT/03_Reports_and_Results/Research/link_ratio.png

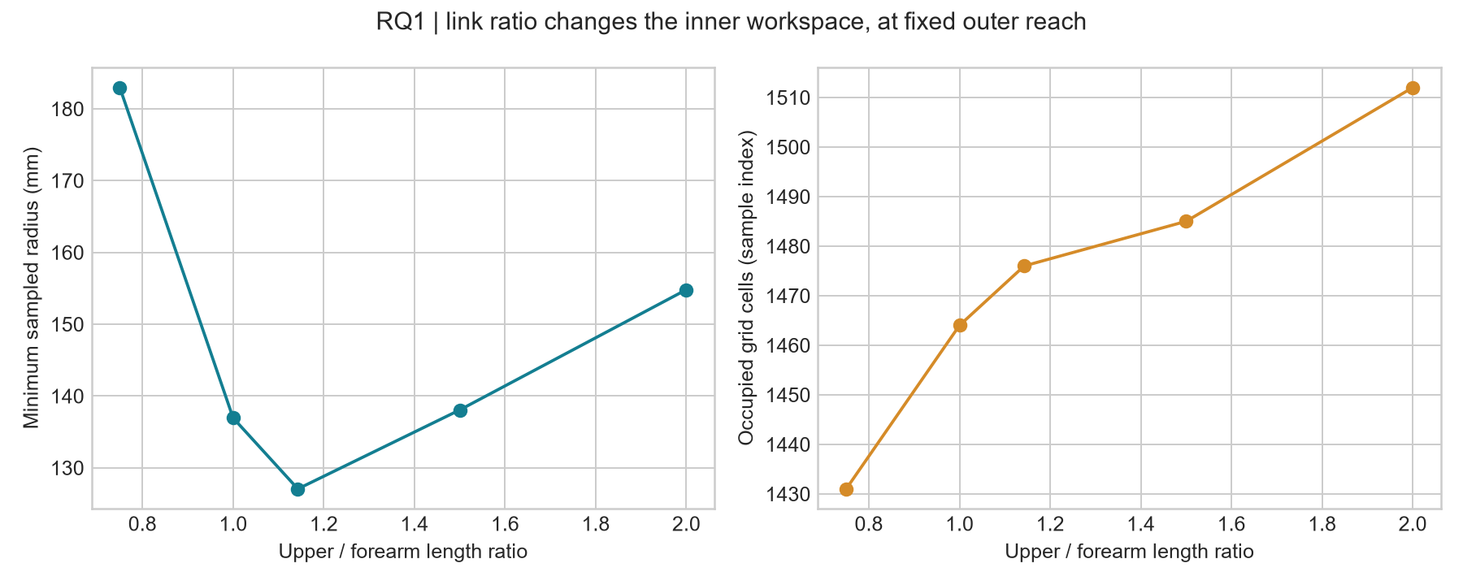
03_Reports_and_Results/Research/link_ratio.png
