pratham-cloud-ctrl/INDRBT/03_Reports_and_Results/Research/pid_tuning.png

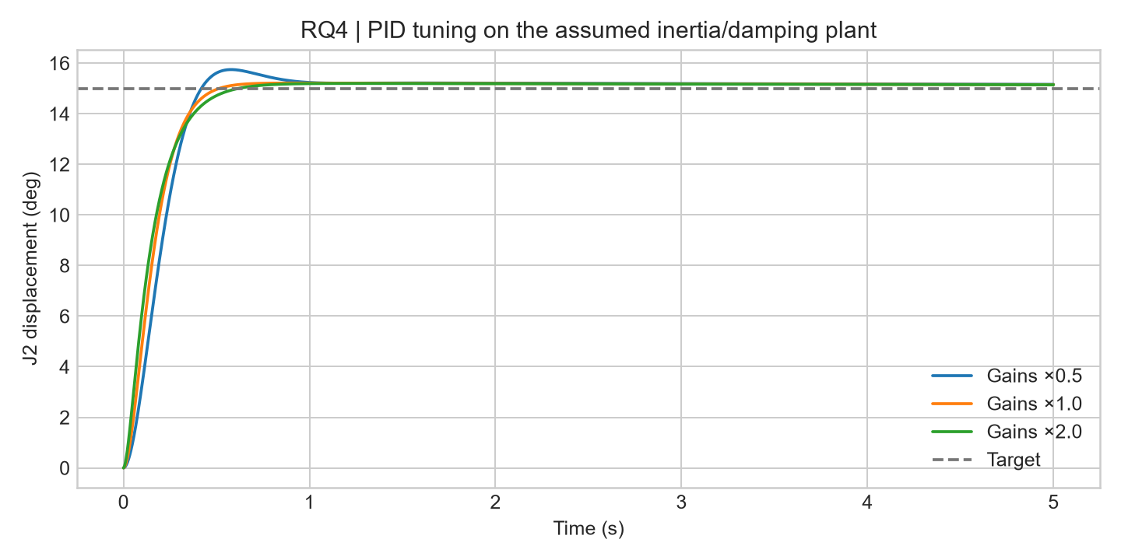
03_Reports_and_Results/Research/pid_tuning.png
