pratham-cloud-ctrl/INDRBT/04_Electronics/exports/pcb_layers.pdf

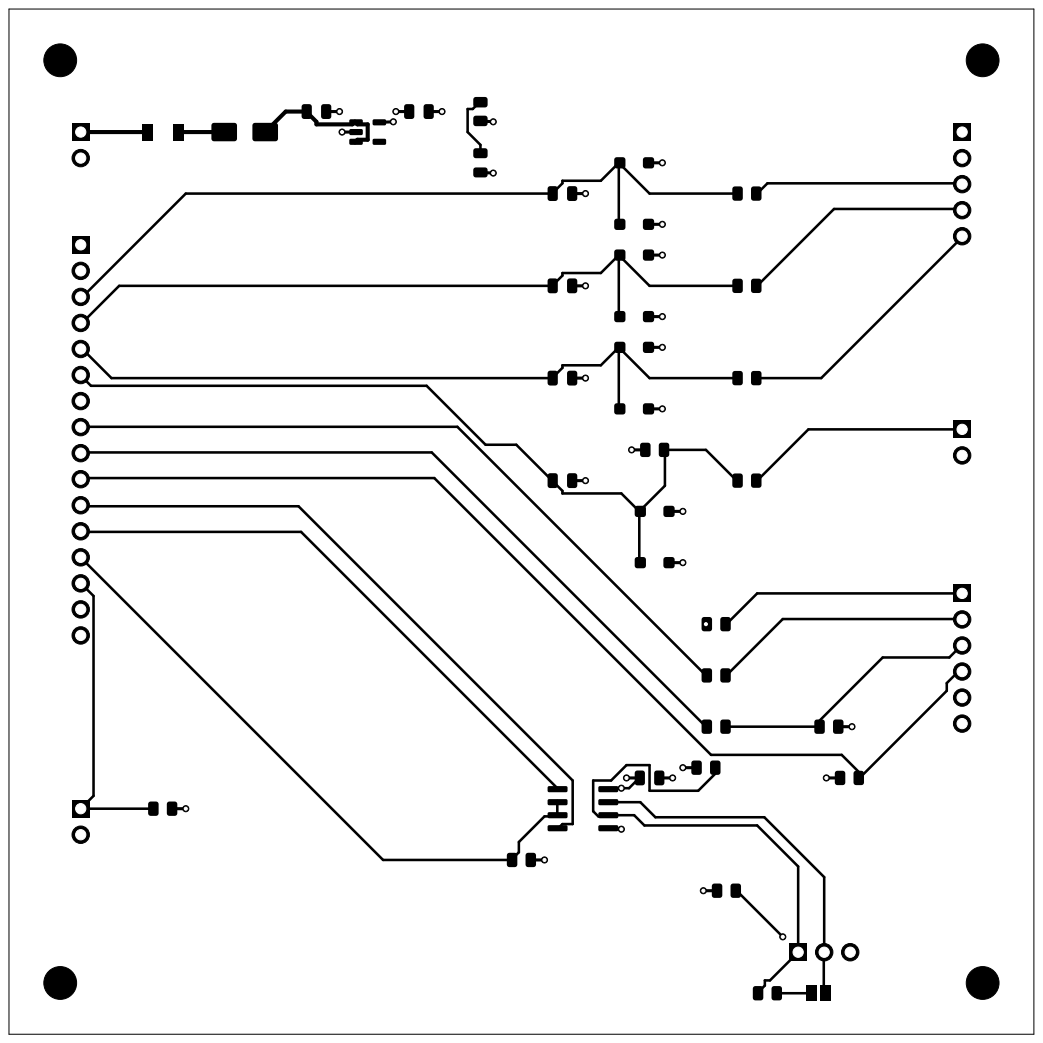
[picture p89: page 1]

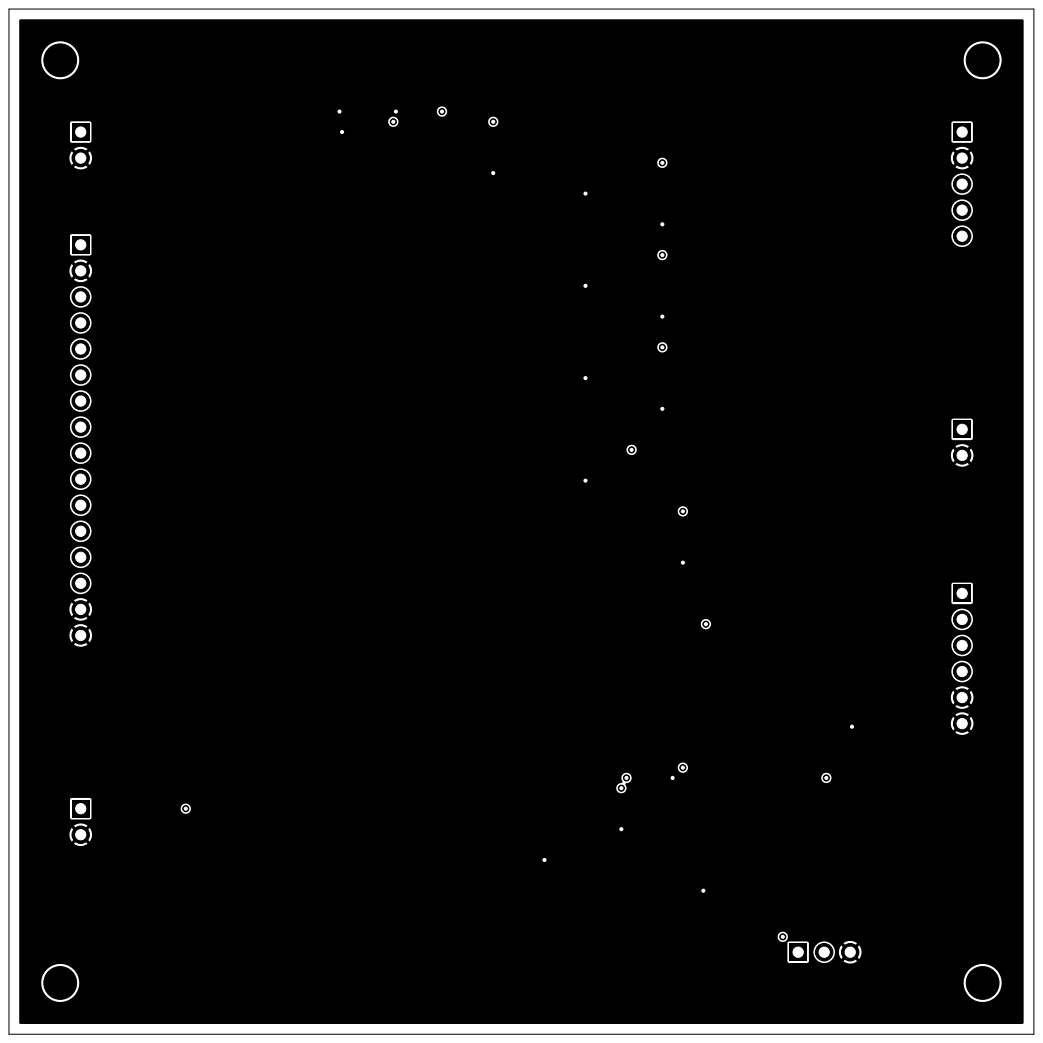
[picture p90: page 2]

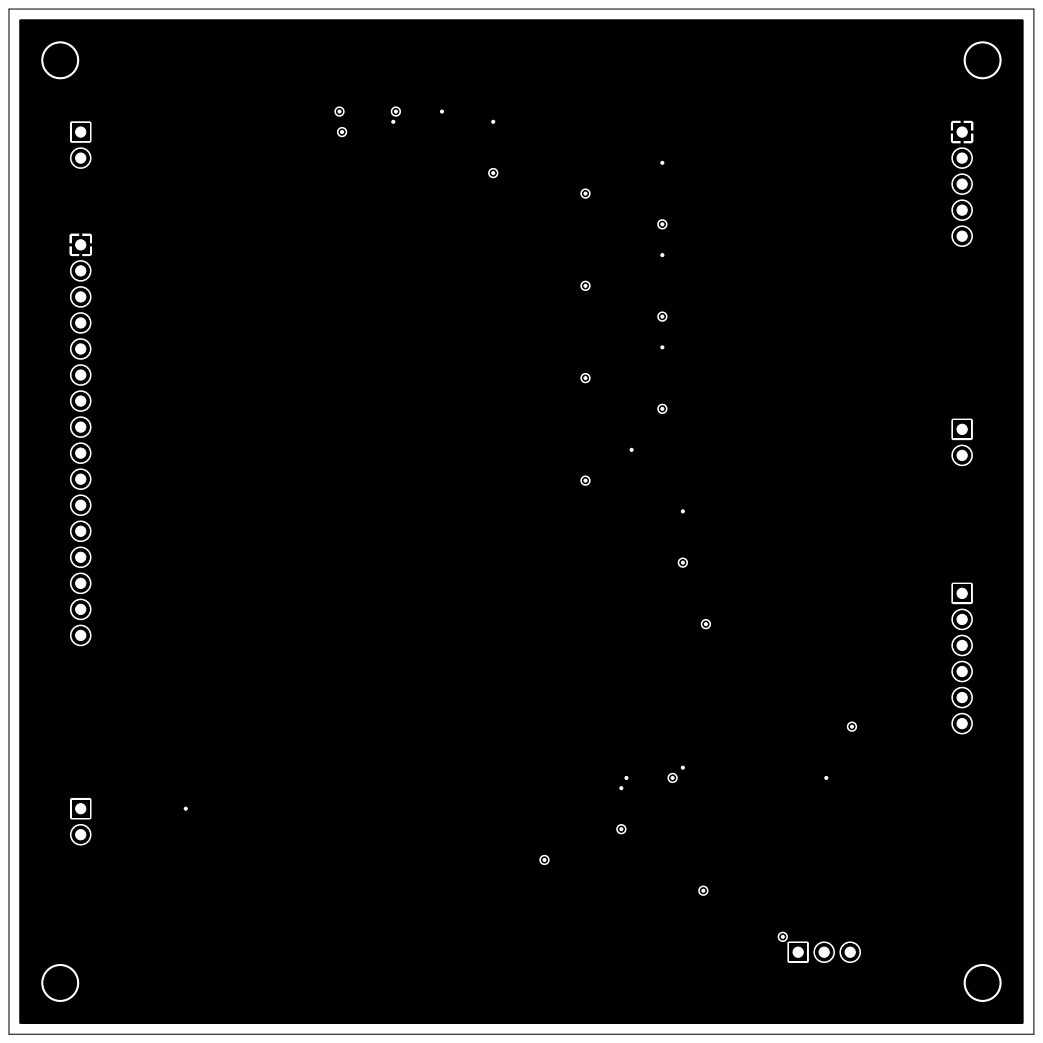
[picture p91: page 3]

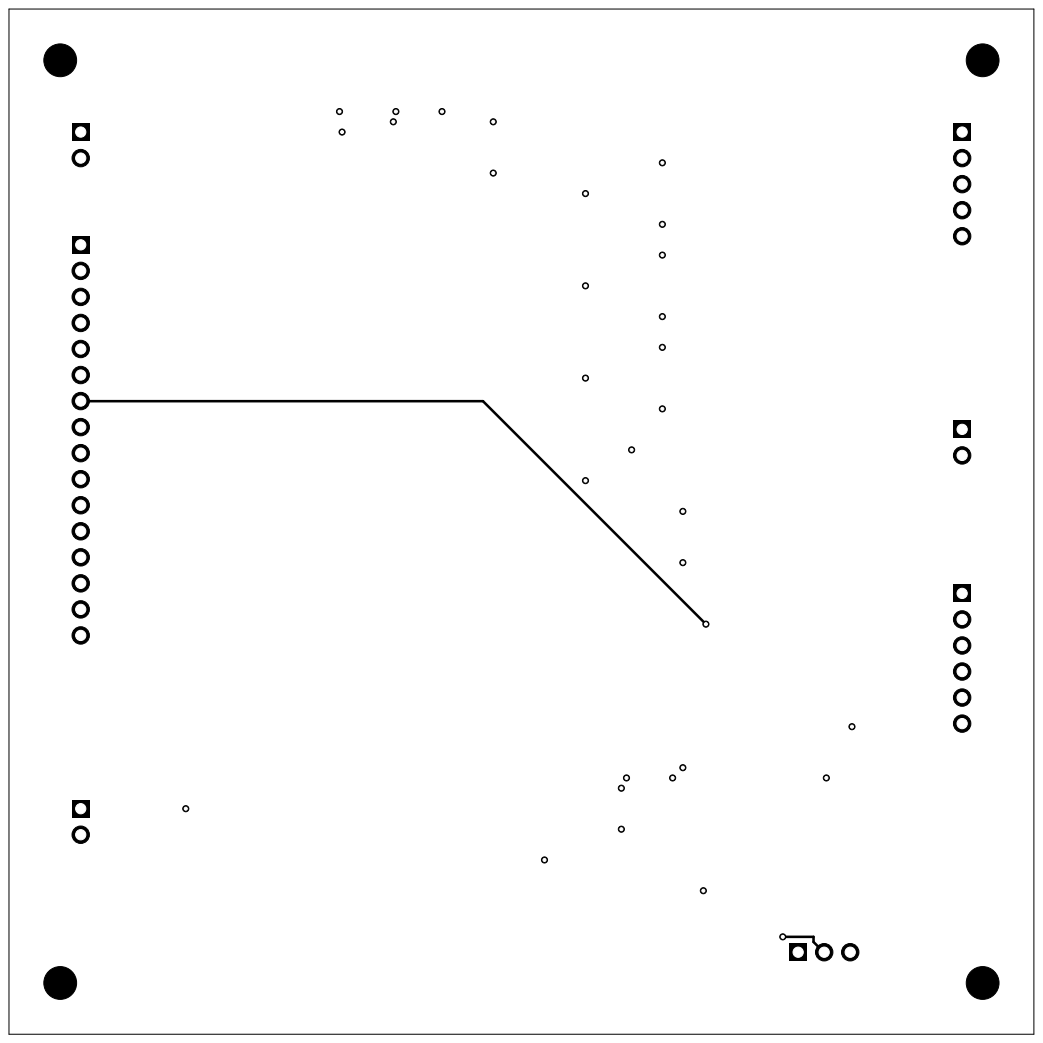
[picture p92: page 4]

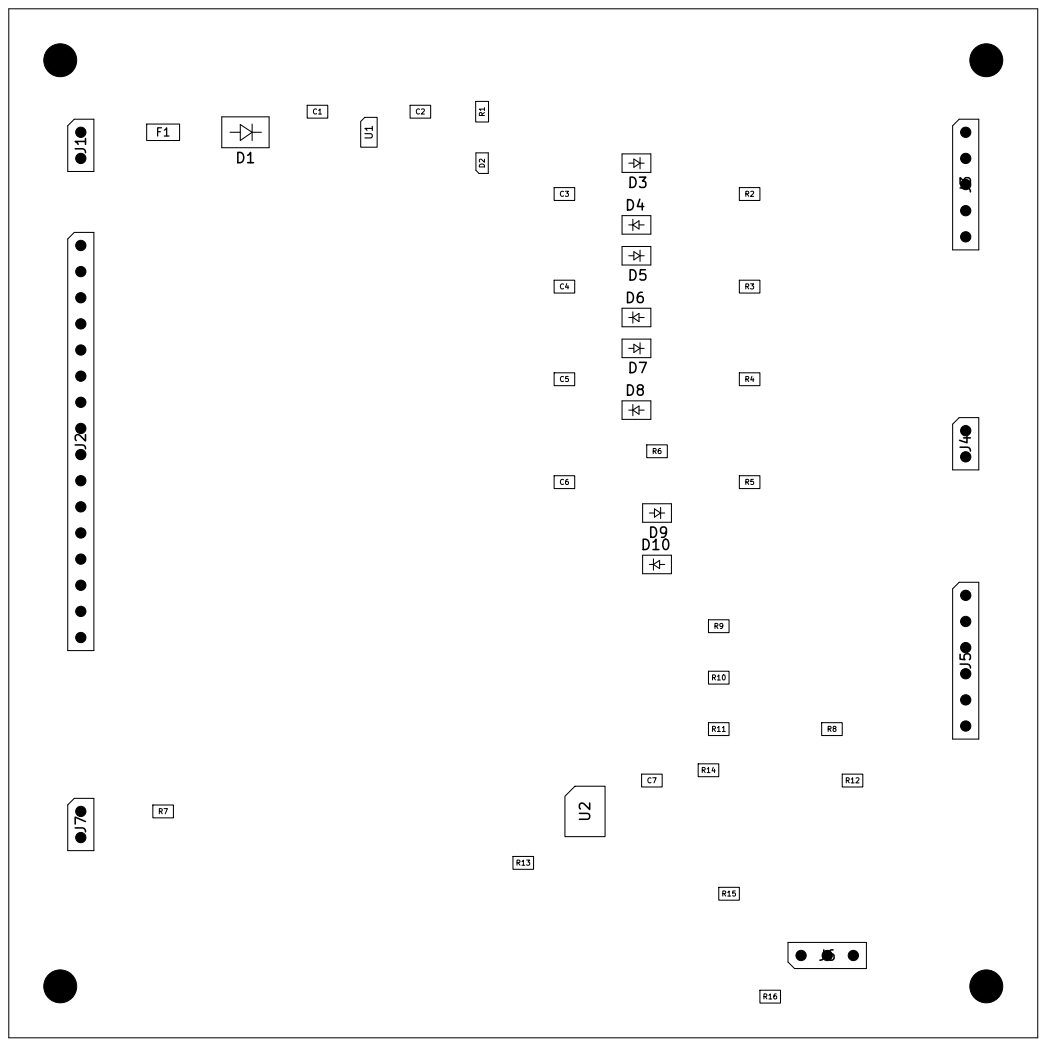
[picture p93: page 5]

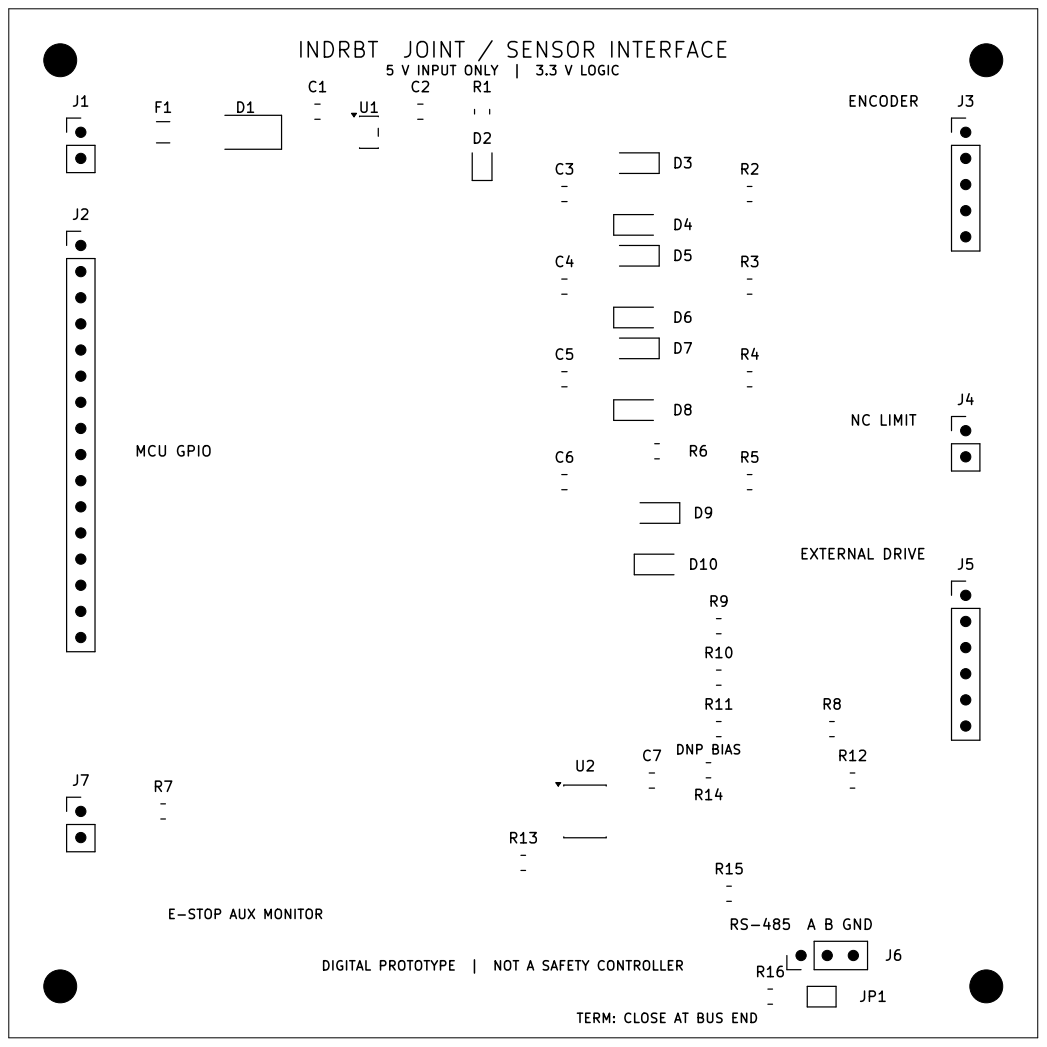
[picture p94: page 6]

INDRBT JOINT / SENSOR INTERFACE

DNP BIAS MCU GPIO

DIGITAL PROTOTYPE | NOT A SAFETY CONTROLLER

TERM: CLOSE AT BUS END
