pratham-cloud-ctrl/INDRBT/(list of files, drawings)

Other design files:
04_Electronics/pcb_command_log.json
04_Electronics/pcb_drc_report.json
04_Electronics/pcb_routing_manifest.json
04_Electronics/pcb_verification.json
06_Complete_Project_Source/electronics/pcb_command_log.json
06_Complete_Project_Source/electronics/pcb_drc_report.json
06_Complete_Project_Source/electronics/pcb_routing_manifest.json
06_Complete_Project_Source/electronics/pcb_verification.json
