pratham-cloud-ctrl/INDRBT/04_Electronics/joint_interface.kicad_pcb

## KiCad design 04_Electronics/joint_interface.kicad_pcb (2026-10-28)

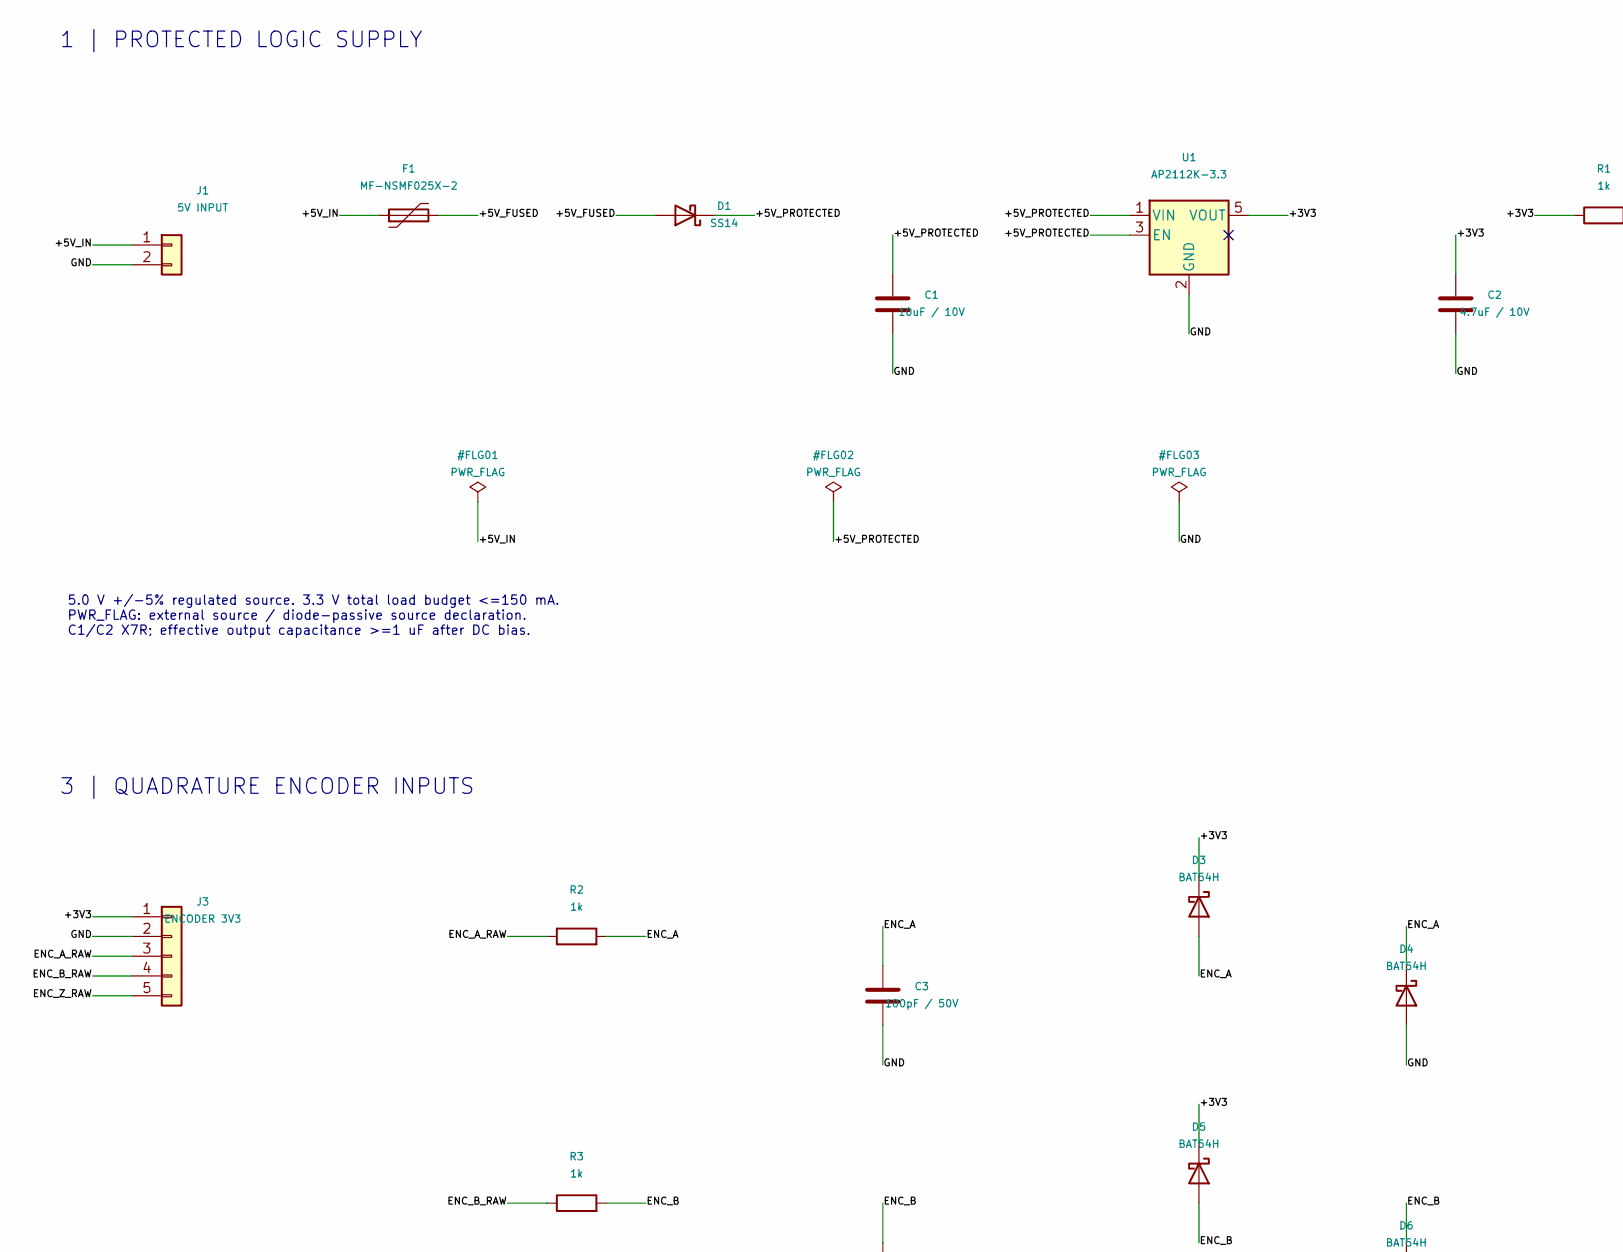
[picture p95: schematic joint_interface.kicad_sch, INDRBT | Joint / Sensor Interface, part in row 1, column 1]

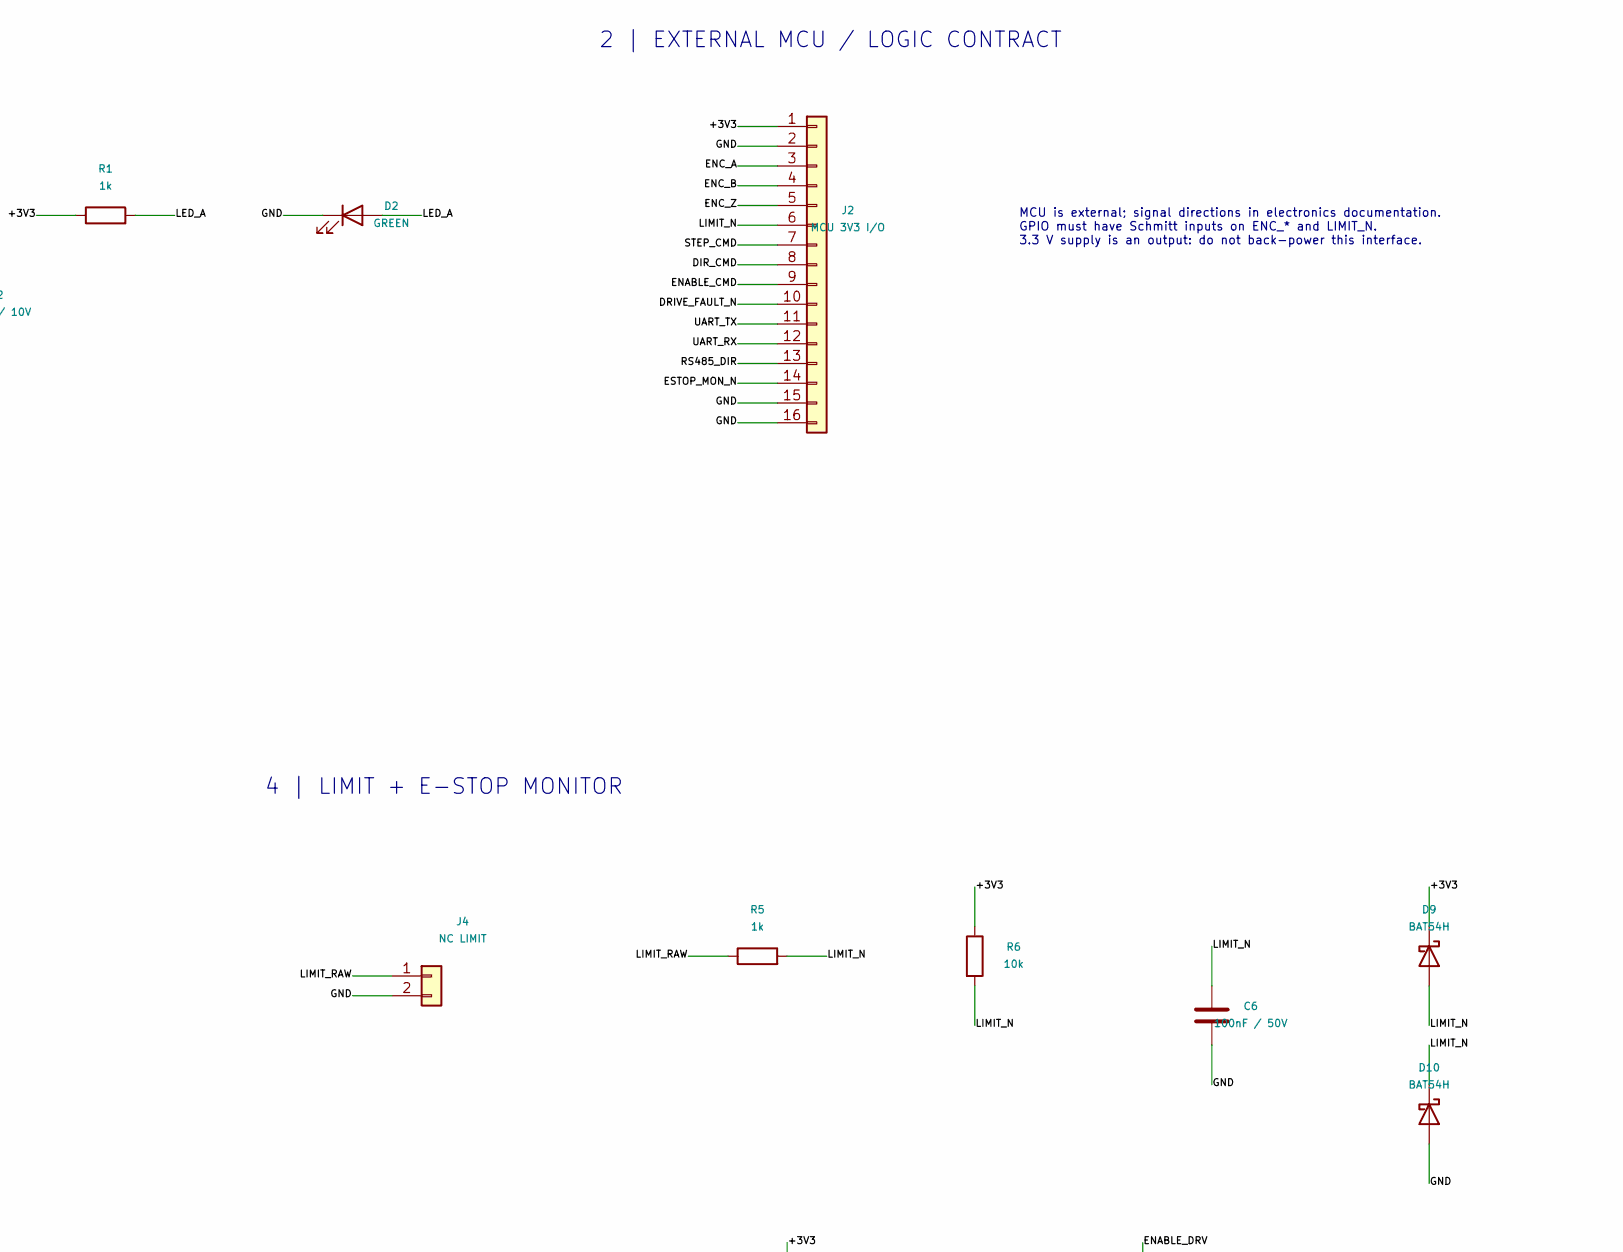
[picture p96: schematic joint_interface.kicad_sch, INDRBT | Joint / Sensor Interface, part in row 1, column 2]

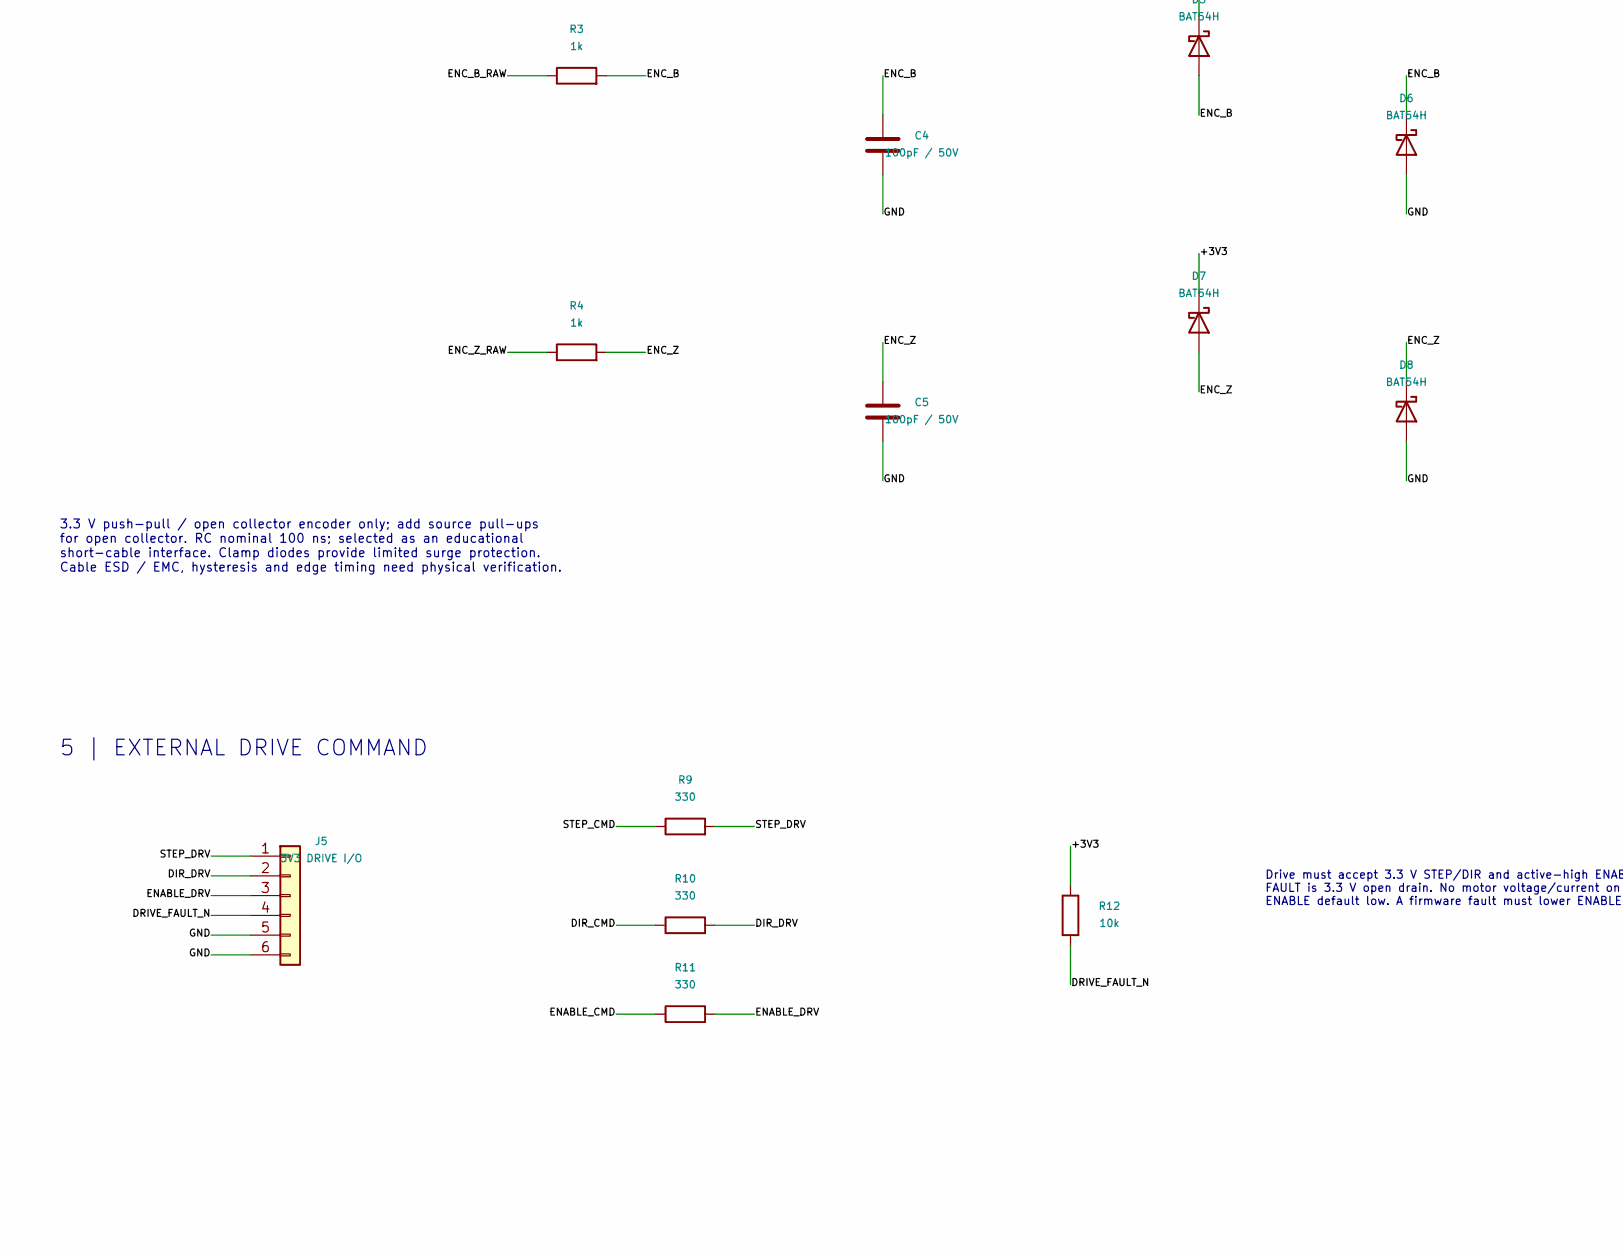
[picture p97: schematic joint_interface.kicad_sch, INDRBT | Joint / Sensor Interface, part in row 2, column 1]

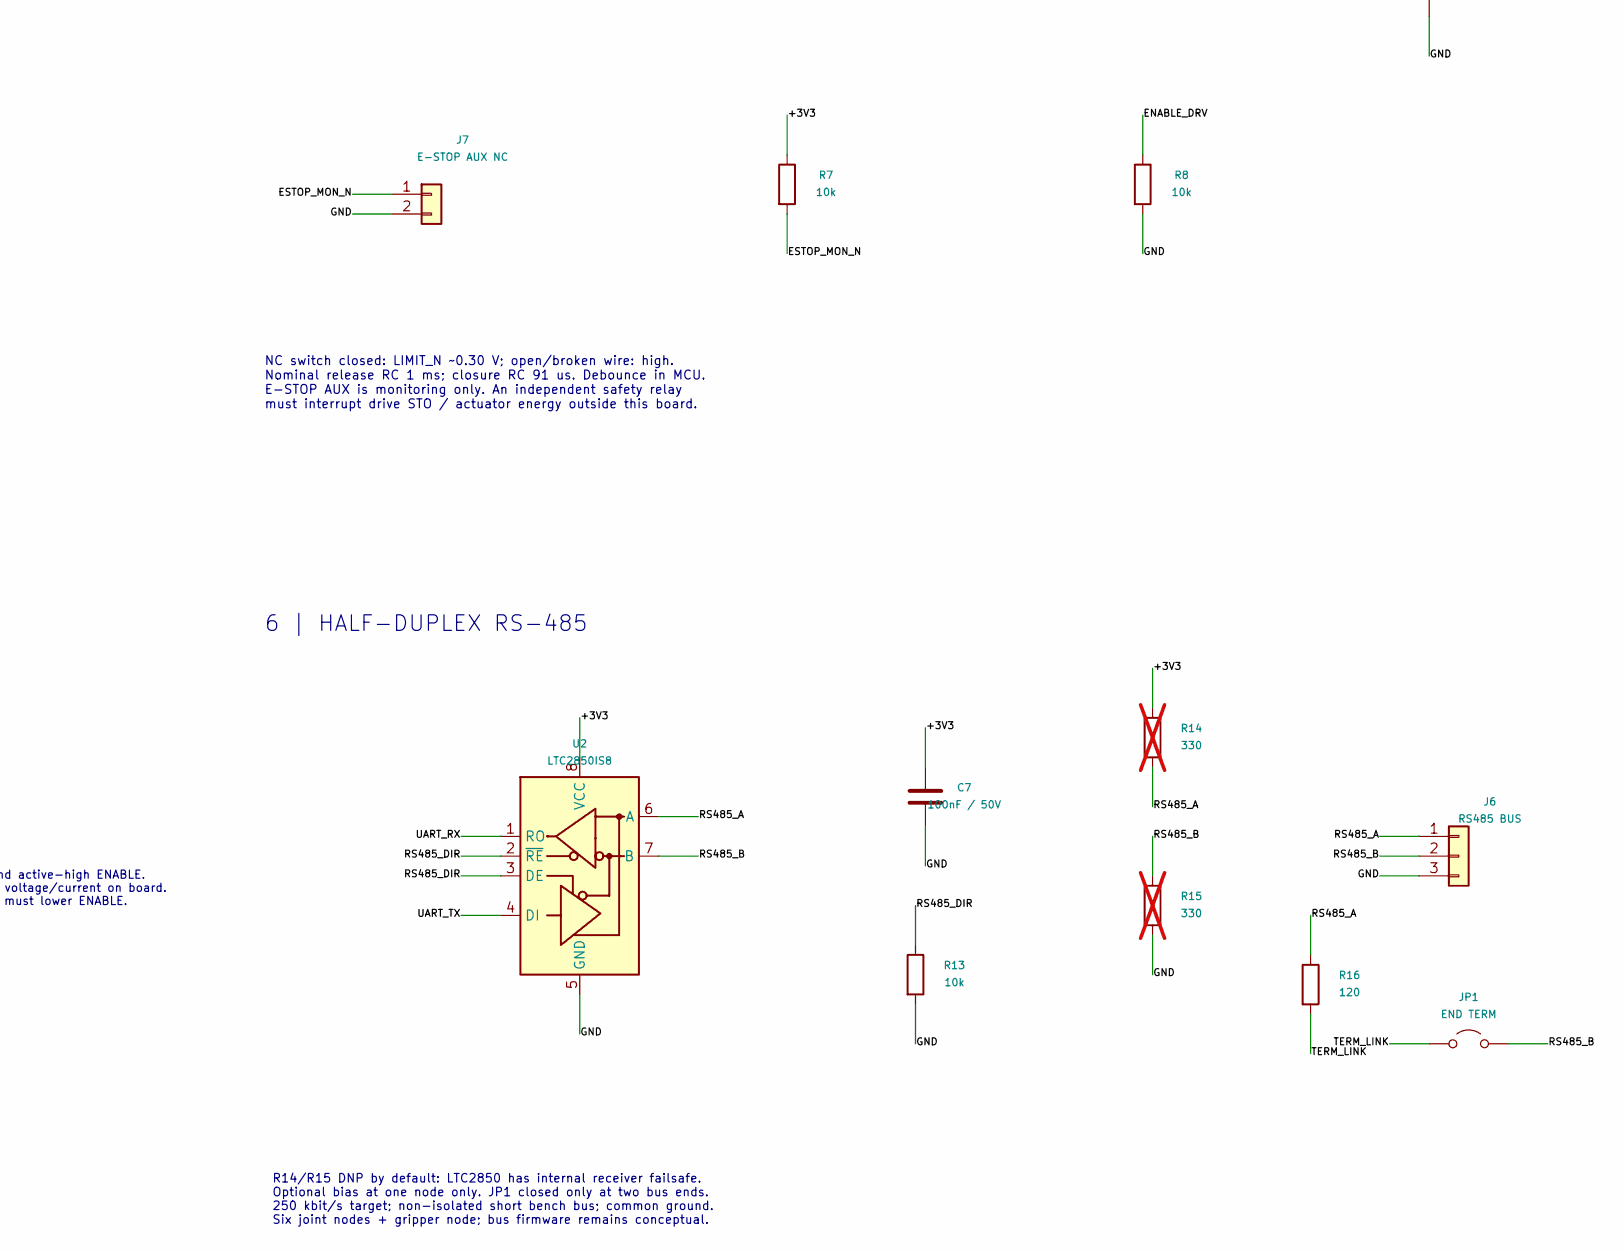
[picture p98: schematic joint_interface.kicad_sch, INDRBT | Joint / Sensor Interface, part in row 2, column 2]

Parts:
C1: 10uF / 10V; C_0805_2012Metric
C2: 4.7uF / 10V; C_0805_2012Metric
C3, C4, C5: 100pF / 50V; C_0805_2012Metric
C6, C7: 100nF / 50V; C_0805_2012Metric
D1: SS14; D_SMA
D2: GREEN; LED_0805_2012Metric
D3, D4, D5, D6, D7, D8, D9, D10: BAT54H; D_SOD-123F
F1: MF-NSMF025X-2; PTC_Bourns_MF-NSMF025X_1206
J1: 5V INPUT; PinHeader_1x02_P2.54mm_Vertical
J2: MCU 3V3 I/O; PinHeader_1x16_P2.54mm_Vertical
J3: ENCODER 3V3; PinHeader_1x05_P2.54mm_Vertical
J4: NC LIMIT; PinHeader_1x02_P2.54mm_Vertical
J5: 3V3 DRIVE I/O; PinHeader_1x06_P2.54mm_Vertical
J6: RS485 BUS; PinHeader_1x03_P2.54mm_Vertical
J7: E-STOP AUX NC; PinHeader_1x02_P2.54mm_Vertical
JP1: END TERM; SolderJumper-2_P1.3mm_Open_Pad1.0x1.5mm
R1, R2, R3, R4, R5: 1k; R_0805_2012Metric
R6, R7, R8, R12, R13: 10k; R_0805_2012Metric
R9, R10, R11: 330; R_0805_2012Metric
R14, R15: 330; R_0805_2012Metric; not fitted
R16: 120; R_0805_2012Metric
U1: AP2112K-3.3; SOT-23-5
U2: LTC2850IS8; SOIC-8_3.9x4.9mm_P1.27mm

Connections:
/+3V3: C2.1, C7.1, D3.1 (K), D5.1 (K), D7.1 (K), D9.1 (K), J2.1, J3.1, R1.1, R6.1, R7.1, R12.1, R14.1, U1.5 (VOUT), U2.8 (VCC)
/+5V_FUSED: D1.2 (A), F1.2
/+5V_IN: F1.1, J1.1
/+5V_PROTECTED: C1.1, D1.1 (K), U1.1 (VIN), U1.3 (EN)
/DIR_CMD: J2.8, R10.1
/DIR_DRV: J5.2, R10.2
/DRIVE_FAULT_N: J2.10, J5.4, R12.2
/ENABLE_CMD: J2.9, R11.1
/ENABLE_DRV: J5.3, R8.1, R11.2
/ENC_A: C3.1, D3.2 (A), D4.1 (K), J2.3, R2.2
/ENC_A_RAW: J3.3, R2.1
/ENC_B: C4.1, D5.2 (A), D6.1 (K), J2.4, R3.2
/ENC_B_RAW: J3.4, R3.1
/ENC_Z: C5.1, D7.2 (A), D8.1 (K), J2.5, R4.2
/ENC_Z_RAW: J3.5, R4.1
/ESTOP_MON_N: J2.14, J7.1, R7.2
/GND: C1.2, C2.2, C3.2, C4.2, C5.2, C6.2, C7.2, D2.1 (K), D4.2 (A), D6.2 (A), D8.2 (A), D10.2 (A), J1.2, J2.2, J2.15, J2.16, J3.2, J4.2, J5.5, J5.6, J6.3, J7.2, R8.2, R13.2, R15.2, U1.2 (GND), U2.5 (GND)
/LED_A: D2.2 (A), R1.2
/LIMIT_N: C6.1, D9.2 (A), D10.1 (K), J2.6, R5.2, R6.2
/LIMIT_RAW: J4.1, R5.1
/RS485_A: J6.1, R14.2, R16.1, U2.6 (A)
/RS485_B: J6.2, JP1.2 (B), R15.1, U2.7 (B)
/RS485_DIR: J2.13, R13.1, U2.2 (~RE), U2.3 (DE)
/STEP_CMD: J2.7, R9.1
/STEP_DRV: J5.1, R9.2
/TERM_LINK: JP1.1 (A), R16.2
/UART_RX: J2.12, U2.1 (RO)
/UART_TX: J2.11, U2.4 (DI)

Notes on the sheet:
1 | PROTECTED LOGIC SUPPLY
5.0 V +/-5% regulated source. 3.3 V total load budget <=150 mA. PWR_FLAG: external source / diode-passive source declaration. C1/C2 X7R; effective output capacitance >=1 uF after DC bias.
2 | EXTERNAL MCU / LOGIC CONTRACT
MCU is external; signal directions in electronics documentation. GPIO must have Schmitt inputs on ENC_* and LIMIT_N. 3.3 V supply is an output: do not back-power this interface.
3 | QUADRATURE ENCODER INPUTS
3.3 V push-pull / open collector encoder only; add source pull-ups for open collector. RC nominal 100 ns; selected as an educational short-cable interface. Clamp diodes provide limited surge protection. Cable ESD / EMC, hysteresis and edge timing need physical verification.
4 | LIMIT + E-STOP MONITOR
NC switch closed: LIMIT_N ~0.30 V; open/broken wire: high. Nominal release RC 1 ms; closure RC 91 us. Debounce in MCU. E-STOP AUX is monitoring only. An independent safety relay must interrupt drive STO / actuator energy outside this board.
5 | EXTERNAL DRIVE COMMAND
Drive must accept 3.3 V STEP/DIR and active-high ENABLE. FAULT is 3.3 V open drain. No motor voltage/current on board. ENABLE default low. A firmware fault must lower ENABLE.
6 | HALF-DUPLEX RS-485
R14/R15 DNP by default: LTC2850 has internal receiver failsafe. Optional bias at one node only. JP1 closed only at two bus ends. 250 kbit/s target; non-isolated short bench bus; common ground. Six joint nodes + gripper node; bus firmware remains conceptual.

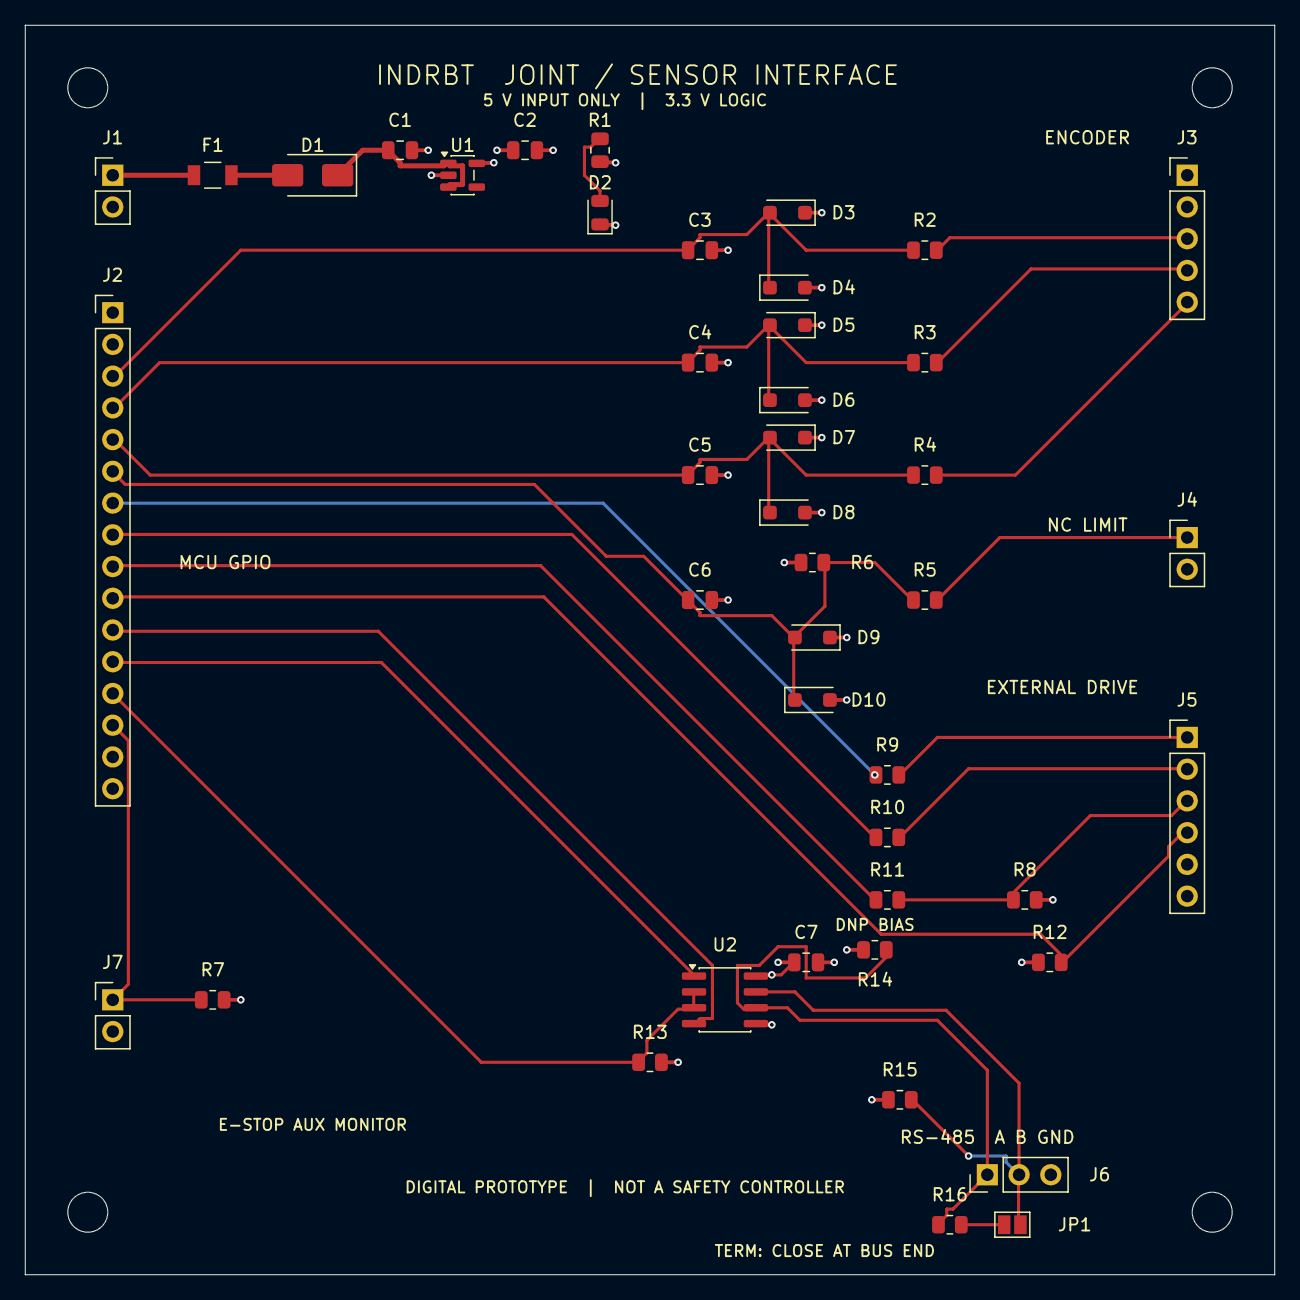
[picture p99: board joint_interface.kicad_pcb from above]

Board: 4 copper layers, 100.0 x 100.0 mm, 48 parts (0 on the bottom side), 28 nets.

Other parts of the board:
H1, H2, H3, H4: M3 mounting; MountingHole_3.2mm_M3
