pratham-cloud-ctrl/INDRBT/(commit log)

2026-10-04 chore: initialize ASTER-6 specification and centralized parameters
    [robot.yaml]
2026-10-04 feat: calculate load and beam envelopes with independent energy checks
    [robot.yaml]
2026-10-04 feat: simulate motion and control with verified kinematics and research sweeps
    [move_j.csv, move_l.csv, pick_place.csv, robot.yaml, samples.csv, tracking.csv]
2026-10-04 feat: export original CAD assemblies and verify sampled clearance
    [assembly_extended.step, assembly_extended.stl, assembly_folded.step, assembly_folded.stl, assembly_home.step, assembly_home.stl, assembly_pick.step, assembly_pick.stl]
2026-10-04 feat: add native joint interface schematic with ERC and topology evidence
    [bom.csv, joint_interface.kicad_sch]
2026-10-04 feat: add offline CAD twin and verified browser playback
2026-10-04 docs: add audited engineering report and full reproducible validation
    [assembly_extended.step, assembly_folded.step, assembly_home.step, assembly_pick.step, assembly_place.step, assembly_vertical.step, base_electronics_cover.step, base_mounting_plate.step]
2026-10-05 Complete ASTER-6 digital project and organize the v1.0 release
    Finish the routed KiCad PCB and native DRC/fabrication evidence, correct CAD interfaces found by all-pair screening, and verify 33 tests and a fresh wheel installation. Preserve original history in the organized repository with browser guides, explicit app launchers and hash-checked artifact copies.
    [assembly_extended.step, assembly_extended.stl, assembly_folded.step, assembly_folded.stl, assembly_home.step, assembly_home.stl, assembly_pick.step, assembly_pick.stl]
2026-10-05 Review engineering models and polish ASTER-6 component access
    [assembly_positions.csv, bom.csv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]
2026-10-17 Repair ASTER-6 mechanical interfaces and strengthen source-bound validation
    [assembly_extended.step, assembly_extended.stl, assembly_folded.step, assembly_folded.stl, assembly_home.step, assembly_home.stl, assembly_pick.step, assembly_pick.stl]
2026-10-20 Polish GitHub navigation and add illustrated engineering tours
    [joint_interface-B_Cu.gbl, joint_interface-B_Mask.gbs, joint_interface-B_Silkscreen.gbo, joint_interface-Edge_Cuts.gm1, joint_interface-F_Cu.gtl, joint_interface-F_Mask.gts, joint_interface-F_Paste.gtp, joint_interface-F_Silkscreen.gto]
2026-10-20 Link public browser showcase for CAD and PCB inspection
2026-10-21 Add CAD and KiCad file-opening guide alongside browser viewers
2026-10-21 Publish public CAD inspection download links and access guide
2026-10-21 Finish hosted engineering showcase with CAD and PCB downloads
2026-10-28 Rename the complete digital engineering project to INDRBT
    [aster6_home.FCStd, bom.csv, indrbt_home.FCStd, indrbt_home.blend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]
